OPEnSLab-OSU/SlideSentinel/Documentation/capstone/cs_capstone2018/Old/individual/main.pdf

## CS CAPSTONE TECHNOLOGY REVIEW

### DECEMBER 4, 2018

# SLIDE SENTINEL

PREPARED FOR

# OREGON STATE UNIVERSITY

### DR CHET UDELL

PREPARED BY

# GROUP 29 THE SLIDE SENTINEL

### LUCAS CAMPOS-DAVIS

Abstract

This document outlines different technology options for the Slide Sentinel project. The options presented cover micro-controllers, GPS modules, and filament materials for the housing.

CONTENTS

1 | Introduction | 2
2 | Technologies | 2
3 | Micro-controllers | 2
4 | GPS RTK Module | 3
5 | Housing Material | 4
6 | Conclusion | 4
References | 5

### 1 INTRODUCTION

My group is working on the Slide Sentinel project. This project aims to create a system for monitoring landslide-prone

areas as well as sending alerts when landslides occur. The system is built on a hub that communicates with many nodes

that report GPS data. The project also includes developing aversion of the hub that will integrate with the Open Sensing

ecosystem.

### 2 TECHNOLOGIES

The roles for our group have not yet been completely decided, so the technologies I review here may not represent what

I am responsible for come spring term. That being said, the technologies under review are Micro-controllers, GPS RTK

Modules, and Housing Materials

### 3 MICRO-CONTROLLERS

Both the ONE Hub and the Slide Sentinel Hub will be built around a micro-controller. This micro controller needs to be

able to communicate with the array of nodes and with the online client. To do this, the micro-controller will need to be

able to utilize LoRa to communicate with the nodes and LTE to communicate with the online client. The micro-controller

must also be readily available.

### 3.1 Arduino MKR NB 1500

The Arduino MKR NB 1500 is a new micro-controller from Arduino. The Arduino MKR NB 1500 is designed to provide

LTE connectivity for IoT developers. The Arduino MKR NB 1500 does not support LoRa communications by itself. If

we are to use this board, we would need an additional board to handle LoRa communications. The Arduino MKR NB

1500 is programmed in C or C++. The Arduino MKR NB 1500 also has not released yet so it is not readily available [1].

### 3.2 Pycom FiPy

The Pycom FiPy is a micro-controller with similar form factor to the Arduino MKR NB 1500. The Pycom FiPy, like the

Arduino MKR NB 1500, provides LTE communication. Unlike the Arduino MKR NB 1500, the Pycom FiPy provides four

other wireless communication networks. Not only does the Pycom FiPy provide LoRa communication, it also provides,

WiFi, Bluetooth, and Sigfox. The Pycom FiPy is programmed in a version of Python called MicroPython. The Pycom

FiPy is currently available from the Pycom website [2].

### 3.3 RAK WisLTE

The RAK WisLTE is similar to the Arduino MKR NB 1500 and the Pycom FiPy in that it is a micro-controller that

supports LTE communications. The RAK WisLTE is based on the Quectel BG96 IoT communications module. The RAK

WisLTE supports Arduino control but does not provide LoRa communication [3]. In order to utilize the RAK WisLTE we

could have to combine it with the RAK811 which is a LoRa module from RAK that is based on the Semtech SX1276[4].

All RAK boards ship through AliExpress which means that is the RAK boards are chosen, orders will need to be placed

soon.

### 3.4 Recommendation

The only board that supports LTE and LoRa communication without any additional components is the Pycom FiPy.

The fact that it meets both of the communication requirements and that it is readily available from the Pycom website

cement the Pycom FyPi as my recommendation for the micro-controller that the two Hub’s will be built around.

### 4 GPS RTK MODULE

The Slide Sentinel Hub will utilize Real Time Kinematics, or RTK. RTK relies on a base station with a fixed position

to send correction data a rover or rovers [5]. For Slide Sentinel, the hub will act as the base station and the nodes

will be the rovers. The Slide Sentinel team has already identified a GPS chip that is RTK capable. I have found two

alternative products that provide similar functionality. In order for one of the alternatives to be recommended, they

need to consume less power than the current chip. If they both consume less power, the form factor should be the

deciding trait.

### 4.1 Navspark S2525F8-GL-RTK

The Navspark S2525F8-GL-RTK is the current choice for both the base and the nodes. The Navspark S2525F8-GL-RTK

provides RTK capabilities. When RTK is not feasible, the chip can provide GNSS and DGNSS positioning. The Navspark

S2525F8-GL-RTK provides centimeter-level accuracy. The Navspark S2525F8-GL-RTK is twenty five millimeters by

twenty five millimeters. The power consumption is 230 mW [6].

### 4.2 SXBlue III+ GNSS

The SXBlue III+ GNSS is not an integratable chip or board. The SXBlue III+ GNSS is a stand alone RTK receiver. The

SXBlue III+ GNSS also offers one centimeter accuracy in RTK mode. The SXBlue III+ GNSS is designed to get its RTK

data from existing RTK stations. The SXBlue III+ GNSS also has the option to use GPS or GLONASS. The SXBlue

III+ GNSS is twenty six millimeters by sixty six millimeters. The SXBlue III+ GNSS uses its own rechargeable, field

replaceable, battery. The SXBlue III+ GNSS’s battery lasts an average of eight hours and takes four to five hours to

charge [7].

### 4.3 Trimble MB-Two

The Trimble MB-Two is an integratable module. The Trimble MB-Two can be used for RTK applications and can utilize

a local base or existing RTK networks. The Trimble MB-Two, in RTK mode, has a one centimeter-level accuracy. The

Trimble MB-Two can utilize RTK with a stationary or mobile base. The Trimble MB-Two is seventy one millimeters by

forty six millimeters by eleven millimeters. The power consumption for the Trimble MB-Two is about 1.2 W [8].

### 4.4 Recommendation

While all three options offer centimeter-level accuracy, there is one clear winner. My recommendation is to keep using

the Navspark S2525F8-GL-RTK. I recommend the Navspark S2525F8-GL-RTK over the other two alternatives because it

is the smallest of the three and has the lowest power consumption of the three.

### 5 HOUSING MATERIAL

The Slide Sentinel Hub needs to have a 3D printed housing. This housing will need to protect the hardware inside from

water and any potential impacts that the hub may sustain. Therefore the selected material needs to be water resistant.

The selected material can not be brittle. The housing material must also be able to survive in an outdoor environment.

The housing will be printed at the OPEnS Lab and therefore should be available at the lab. The OPEnS Lab has the

resources to print in resin, ABS, PLA, and Nylon 645. The resin-capable printer is significantly slower and smaller than

the other two printers which are capable of printing in the other materials [9].

### 5.1 ABS

As Anatol Locker wrote for All3DP, Acrylonitrile Butadiene Styrene, or ABS, is one of the most common plastics used

today. ABS can be found in Lego bricks, bicycle helmets, and home appliances. ABS can melt and cool without changing

its chemical properties, which makes it a good option for 3D printer filament [10]. ABS produces strong and durable

prints, ABS is often used for items that will be dropped or frequently handled such as phone cases and electrical

enclosures [11]. The one downside of ABS is that is can degrade through prolonged exposure to sunlight [10].

### 5.2 PLA

Polylactic Acid, or PLA, is a filament material that is made from biological materials like cornstarch or sugarcane.

Being made from biological materials means that prints made from PLA are biodegradable. This means that for indoor

applications, PLA will not degrade quickly, but for outdoor applications the prints will be degraded by bacteria. PLA is

also brittle and prone to shattering if it is dropped or put under stress. PLA is often used for low wear parts like painted

miniatures [12]. PLA is also used for prototype parts [11].

### 5.3 Nylon 645

The final non-resin filament type available to the OPEnS Lab is Nylon 645. Nylon is considered the number one filament

choice when it comes to strength, flexibility, and durability. Printed Nylon parts are resistant to impact and prolonged

stress. However, nylon is hygroscopic, this means that nylon will absorb water over time. This property leads to

decreased strength and durability. It also is not preferable for outdoor use [11]. According to a manufacturer of nylon

645, the only way to bond anything with nylon 645 is to either use heat to bond two pieces of nylon 645 or to use a

proprietary nylon glue [13].

### 5.4 Recommendation

All three filament types have their own drawbacks. PLA is immediately disqualified as its biodegradable and brittle

properties make it not suited for outdoor applications. Thus, the decision comes down to ABS or nylon. While nylon

is very durable and seemingly well suited to protecting the Slide Sentinel Hub from impacts, the absorption of water

from the surrounding air means that it is not suited for protecting electronics from the environment. This means that

ABS is the most well suited for the Slide Sentinel Hub enclosure. ABS will need to be painted in order to keep it from

degrading in sunlight.

### 6 CONCLUSION

My recommendations are summarized in the table below.

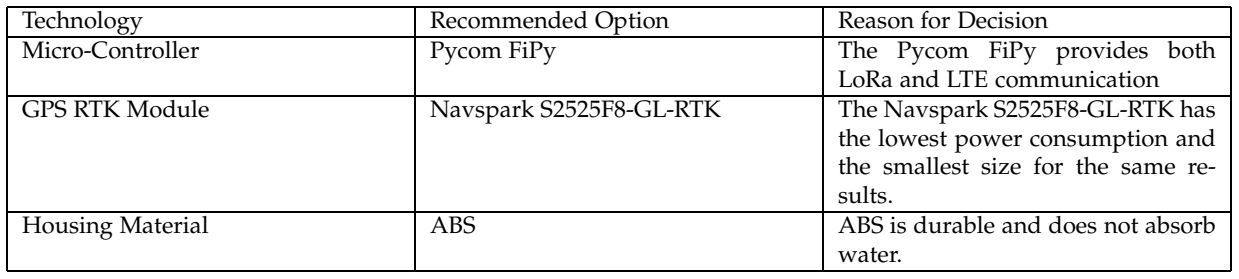
[picture p12: figure]
LoRa and LTE communication; the lowest power consumption and the smallest size for the same re- sults.; water.

Technology | Recommended Option | Reason for Decision
Micro-Controller | Pycom FiPy | The Pycom FiPy provides both
GPS RTK Module | Navspark S2525F8-GL-RTK | The Navspark S2525F8-GL-RTK has
Housing Material | ABS | ABS is durable and does not absorb

REFERENCES

[1] Arduino, “Arduino mkr nb 1500.” [Online]. Available: https://store.arduino.cc/usa/arduino-mkr-nb-1500
[2] Pycom, “Fipy.” [Online]. Available: https://pycom.io/product/fipy/
[3] R. T. Co, “Wislte.” [Online]. Available: https://www.rakwireless.com/en/WisKeyOSH/WisLTE
[4] ——, “Rak811.” [Online]. Available: https://www.rakwireless.com/en/module/lora/RAK811
[5] R. S. LLC, “Rtk (real time kinematic) basics for surveying.” [Online]. Available: http://www.resourcesupplyllc.com/PDFs/RTKBasics SurveyGradeGPS.pdf
[6] Navspark, “S2525f8glrtk.” [Online]. Available: http://navspark.mybigcommerce.com/content/S2525F8-GL-RTK v2.pdf
[7] G. | inc, | “Sxblue | iii+ | gnssk.” | [Online]. | Available: | http://www.sxbluegps.com/wp-content/uploads/2016/07/
2016-07-15-SXBlue-III-GNSS-EN web.pdf
[8] T. N. Limited, “Trimble mb-two.” [Online]. Available: http://trl.trimble.com/docushare/dsweb/Get/Document-867970/
[9] OPEnS, “Resources.” [Online]. Available: www.open-sensing.org/resources
[10] A. Locker, “The ultimate filament guide.” [Online]. Available: https://all3dp.com/abs-3d-printer-filament-explained/
[11] All3DP, “The ultimate filament guide.” [Online]. Available: https://all3dp.com/1/3d-printer-filament-types-3d-printing-3d-filament/
[12] R. Baguley, “3d printing materials: The pros and cons of each type.” [Online]. Available: https://www.tomsguide.com/us/3d-printing-materials,news-24392.html
[13] taulman3d, “645 specifications.” [Online]. Available: http://taulman3d.com/645-features.html
