OPEnSLab-OSU/SlideSentinel/Documentation/capstone/cs_capstone2018/Old/individual/techreview.pdf

## CS CAPSTONE TECHNOLOGY REVIEW

### NOVEMBER 27, 2018

# SLIDE SENTINEL

PREPARED FOR

# OREGON STATE UNIVERSITY

DR CHET UDELL

PREPARED BY

# GROUP 29 THE SLIDE SENTINEL

KEVIN KOOS

Abstract

This document outlines some technologies to be used in the Slide Sentinel and ONE hub projects. Outlined here is information on IoT cellular networks, LPWAN radio technologies, and radio transceivers. Each section overviews three possible technologies to be used along with a final recommendation.

CONTENTS

1 | Introduction | 1
2 | Technologies | 1
3 | IoT Cellular Networks | 2
4 | LPWAN Radio Technologies | 3
5 | Radio Transceivers | 3
6 | Appendix | 4
7 | References | 5
References | 5

### 1 INTRODUCTION

Our senior capstone projects goal is to develop a wireless hub to be used in the Open Sensing sensor ecosystem with the LOOM library, as well as a wireless hub for the Slide Sentinel project using satellite communication with additional constraints on the system. Both hubs will provide a way for many smaller sensors to communicate with it and allow users to remotely collect their data while providing data to the sensors such as RTK GPS corrections. The Slide Sentinel projects goal is to provide a means for users to monitor mass movements of ground in remote locations and visualize that information on an online client for easy viewing and analysis.

### 1.1 Role

While our specific roles in the project are not set in stone at the moment, my current responsibility is to work on the wireless capabilities of the hubs, add more wireless capabilities into it, and integrate existing code into the LOOM library according to previously set specifications. I will likely also be working on the Slide Sentinel hub but many specifics of its final design are still being finalized.

### 2 TECHNOLOGIES

The technologies I will be reviewing in this paper are cellular networks, radio transceivers, and LPWAN IoT wireless radio protocols. The LPWAN IoT wireless protocols are different from regular wireless protocols in that it is specific towards wireless protocols which are designed for IoT devices where efficiency and robustness are considered top priority.

### 3 IOT CELLULAR NETWORKS

One of the central and key responsibilities of the central hub is to send collected data over a cellular network to some other database. There are many different kinds of cellular networks available all with different data rates, frequency, sensitivity, and power consumption. Both hubs will utilize cellular networks. Due to one of the use cases of the hub being remote data collection, priority will be placed on networks which feature a low data rate and low power consumption such as IoT specific cellular networks. Cellular IoT networks are actually considered LPWAN networks but due to their significant difference in range, we will consider them separately from other LPWAN technologies later in the document. The three cellular network shown here give a wide view of both the time line and scope of these technologies as they came to be. All three run at a low transmit power of around 20 30 dBm and a relatively narrow band of frequencies making them optimal for IoT specific applications.

### 3.1 LTE CAT-1

LTE CAT-1, released in Q4 2008, was the first cellular network available to expressly support IoT-like devices. Although LTE CAT-1 does have a relatively large frequency band from 1.4 to 20 MHz, it makes up for it in the peak upload and download rates which are much higher than other IoT standards. Additionally, this network boasts full duplex communication unlike other IoT standards, allowing for 2-way continuous communication. As a consequence of supporting full duplex communication and high data rates, LTE CAT-1 is still an expensive solution for small IoT application with extremely low data rates. For what it is worth, LTE CAT-1 directly builds off of existing LTE modems allowing for IoT application to connect where LTE networks already exist. Usage of this network can be seen in IoT devices which may require a higher data rate than most such as those concerning video streaming.

3.2 4G LTE CAT-M1
4G LTE CAT-M1 was the first fully IoT based cellular network to be widely supported and used. It was released in the 2016 3GPP specification. Compared to LTE CAT-1, CAT-M1 is cheaper with lower data rates and a much narrower frequency band. The network also boasts a much lower latency than other networks with the capability to communication in either full or half duplex mode. CAT-M1 has a large popularity among IoT cellular networks due to its wide variety of capabilities and low data rates. CAT-M1, like its predecessor CAT-1, is able to directly build off of existing LTE networks. CAT-M1 IoT applications can be seen in devices which collect a small amounts of data periodically such as a rain meter or electrical meter.

3.3 4G CAT-NB1 (NB-IoT)
NB-IoT, short for Narrow Band, is a new IoT communication standard that works differently from previous standards. The NB-IoT standard is built from the ground up to be for IoT devices by only requiring a very narrow band of frequency and very low power usage. As a consequence, communication speeds on NB-IoT is much slower, but for basic sensing IoT applications, it is more than enough. NB-IoT was released in the 2016 3GPP specification along with CAT-M1 and has had much slower adoption due to it not using an LTE modem. NB-IoT uses DSSS modulation which is a specific modulation technique that spreads out a signal into a wider spectrum of frequencies (a ”wideband signal”) in order to decrease effects of interference on the signal.

### 3.4 Recommendations

Since both hubs are to be used in IoT application where data is very small, we want to go with a cellular network with a low data rate. Additionally, both hubs are envisioned to be used in remote areas away from any outlet so power consumption is one of our top priorities when choosing a cellular network. For the reasons stated above, going with either CAT-M1 or NB-IoT is recommended for either project. Located below is a table containing the specifications we are concerned with.

TABLE 1
Numerical qualities of cellular IoT networks
Standard: | LTE CAT-1 | 4G LTE CAT-M1 | 4G NB-IoT
Peak Download Rate: | 10 Mbit/s | 1 Mbit/s | <300 kbit/s
Peak Upload Rate: | 5 Mbit/s | 1 Mbit/s | <300 kbit/s
Transmit Power(US) | 23dBm | 20dBm | 23dBm
Duplex Mode | Full | Full or Half | Half

### 4 LPWAN RADIO TECHNOLOGIES

LPWAN, short for Low Power Wide Area Network, are network technologies which are designed to be used in low power and low data rate applications. The Slide Sentinel hub and the ONE hub will both depend on some radio technologies to talk to other sensors in the field. All three radio technologies are patented, each using slightly different techniques to improve certain aspects of the signal. For both hubs, we are looking for radio solutions which can transmit at a long range and on a low power budget. All three achieve this but in much different ways.

### 4.1 LoRa

LoRa, short for Long Range, is a patented wireless radio technology which can achieve a high sensitivity at the cost of lower data rates. These characteristics make this technology perfect for low data wireless applications such as IoT devices. LoRa was originally developed by Cycleo, but was later acquired by Semtech. LoRa is able to achieve this due to their patented chirp modulation technology. LoRa is also capable of multiplexing multiple signals together onto a single frequency allowing for multiple LoRa systems to talk to one another on the same band. This is achieved by their chirp modulation technology which encodes data through many ”chirps”. (Chirps are signals which increase or decrease in frequency over time.) This makes LoRa considered a ”spread-spectrum” radio technology. These chirps are also much easier to discern from noise in a signal making LoRa resistant to some kinds of interference.

### 4.2 SigFox

SigFox is a patented wireless radio technology, developed by its namesake, which boasts a low power, low bit-rate, long range solution all in a very narrow frequency bandwidth. SigFox uses a technique called D-BPSK which is a specific kind of phase shift keying (PSK) which encodes data in the reference wave of a signal by modulating its phase. Since the modulation technique here only affects the phase of the signal, the transmissions only need a very narrow chunk of the spectrum to transmit data unlike LoRa which requires a frequency band. As a consequence, SigFox has a very slow symbol transmission rate and needs more than a few seconds per transmission which can lead to interference between symbols in the transmission. Although slow and possibly noisy, SigFox radio technology is able to achieve low power, low data rate transmission in a remarkably small spectrum band. Due to these combinations of factors, SigFox is useful for star networks with a central base station which has a better antenna.

### 4.3 nRF

nRF are a brand of wireless solutions from Nordic Semiconductor which runs in the 2.4GHz WiFi band that specialize in being ultra low power. Due to the frequency at which WiFi runs at, multiple WiFi signals can exist in a crowded area simultaneously. Due to this and the low throughput of nRF, signals have a very low range which is way under the requirements of our project. To make up for this, a Low-Noise Amplifier (LNA) can be used to amplify the receiving signal. Of course, using an amplifier will increase the overall power needed for transmission, but with an already low power nRF solution, the combined power consumption may still make nRF a viable solution in the end.

### 4.4 Recommendations

Due to the need for both long range and low power transmissions, I would recommend the usage of LoRa in the radio solution. LoRa is a good choice for the Slide Sentinel project because of its ability to multiplex signals together and have a long range. Of course, the radio solutions depend on the implementation of the radio technology in the hardware along with the radio technology itself.

### 5 RADIO TRANSCEIVERS

The Slide Sentinel project will require a radio transceiver in the hub that has enough range and can communicate with sensors placed in the field as well have a low power consumption to last a long time. Typically these two qualities have an inverse relationship but certain radio technologies can make up for this. The need for a transceiver rather than a receiver comes from the fact that sensor nodes will get GPS RTK correction data from the central hub to achieve our goal of having a 1cm positional accuracy on sensor positions. Currently the final choice of transceiver has not yet been made yet and only a few solutions have been tried. Covered here are three solutions that fit our requirements and have not yet been considered in the hubs.

### 5.1 Analog Devices: ADF7030-1

The ADF7030-1 is a programmable radio transceiver available through Analog Devices. It is able to transmit at frequencies <1GHz and uses Gaussian PSK modulation. It is able to achieve up to 300 kbps with -121.4 dBm sensitivity at 2.4 kbps. Along with a transmitting -20dBm - +17dBm range, this transceiver is a very capable device. It comes with both IEEE802.15.4g and generic packet modes allowing for flexibility in the packet protocol. More importantly, this transceiver comes with multiple modes of interrupts in order to wake the transceiver out of sleep mode. Although this module among its modes consumes more power than the others on average, it can be programmed for just the right amount of amplification for the job at hand.

### 5.2 RFSolutions: RF-LORA-915-SO

RF-LORA-915-SO is a LoRa radio transceiver solution from RFSolutions. It uses a Semtech SX1272 Modem at its core and is capable of up 16km in range at frequencies <1GHz. Although this range is probably optimistic due to lack of obstructions, this is still an outstanding range to get nonetheless. Although this module is designed for use with LoRa, the Semtech modem is capable of other modulation techniques such as G/FSK, G/MSK, and OOK. With a high sensitivity and a high link budget, this module is capable of a very long range making it a good choice for project with small data requirements. This RF transceiver also comes with a few modes of interrupts in order to wake the transceiver up to listen mode.

### 5.3 STMicroelectronics: S2-LP

The S2-LP is a RF transceiver available from STMicroelectronics which boats having high performance at an ultra low power. It is capable of transmitting over a number of modulation techniques such as G/FSK, OOK, and ASK. Just like the other two transceivers this radio transmits in the <1GHz range. This RF transceiver has a lower power budget out of the others pulling 7mA receiving and 10mA (at +10dBm) when transmitting. Although this RF transceiver also has excellent sensitivity and link budget, it is lacking in terms of amplification when compared to the previous two transceivers. This transceiver comes with a wide range of ways to wake the transceiver from idle.

### 5.4 Recommendations

For the reasons stated above, I would recommend the RFSolutions RF-LORA-915-SO due to its long range and flexible settings. Due to the environment our radio solutions will be placed in, nothing can replace real testing when it comes to finding the best performer. Below is a table of the appropriate information of each transceiver. Range is usually not provided and can usually only be inferred from testing in the deployment location.

TABLE 2
Specifications of RF Transceivers
Transceiver | Modulation | Estimated Range | Data Rate | Sensitivity | Link Budget | Power Consumption
ADF7030-1 | G/FSK | N/A | 0.1-300 kbps | -121.2 dBm (@ 2.4kbps) | N/A | (@915MHz) 25.4mA (300kbps) RX 43mA (+13dBm) TX
RF-LORA-915-SO | LoRa(Chirp), FSK, MSK | 16Km | 0.1-300 kbps | -130 dBm | 157 dB Max | 10mA RX 28mA TX (+13dBm)
S2-LP | FSK, ASK, SigFox | N/A | 0.1-500 kbps | -130 dBm | >145 dB | 7mA RX 10 mA TX (+10 dBm)

### 6 APPENDIX

### 6.1 Abbreviations

- IoT - Internet of Things
- PSK - Phase Shift Keying
- GPSK - Gaussian PSK
- MSK - Minimum Shift Keying
- GMSK - Gaussian MSK
- FSK - Frequency Shift Keying
- ASK - Amplitude Shift Keying
- OOK - On-Off Keying
- LoRa - Long Range
- nRF - (Nordic) Radio Frequency
- GPS - Global Positioning System
- RTK - Real Time Kinematic (GPS)
- WAN - Wide Area Network
- LPWAN - Low Power WAN
- LTE - Long-Term Evolution
- NB-IoT - Narrow Band IoT
- 3GPP - 3rd Generation Partnership Project
- DSSS - Direct Sequence Spread Spectrum (modulation)
- CAT - Category

### 7 REFERENCES

[1] V. Prajzler, “Lora, lorawan and loriot.io,” https://www.loriot.io/lorawan.html, accessed: 11-5-18.
[2] Y. | Hwang, | “Cellularm | iot | explained | - | nb-iot | vs. | lte-m | vs. | 5g | and | more,” | https://www.iotforall.com/
cellular-iot-explained-nb-iot-vs-lte-m/, (https://www.iotforall.com/cellular-iot-explained-nb-iot-vs-lte-m/) accessed: 11-4-18.
[3] “Sigfox technology overview,” https://www.sigfox.com/en/sigfox-iot-technology-overview#popin-235-1, accessed: 11-6-18.
[4] Y.-P. E. Wang, X. Lin, A. Adhikary, A. Grovlen, Y. Sui, Y. Blankenship, J. Bergman, and H. S. Razaghi, “A primer on 3gpp narrowband internet of things,” IEEE Communications Magazine, vol. 55, no. 3, pp. 117–123, 2017.
[5] 3GPP, “Release specificatioins,” www.3gpp.org/release-#, accessed: 11-19-18.
[6] LinkLabs, “Sigfox vs. lora,” https://www.link-labs.com/blog/sigfox-vs-lora, accessed: 11-24-18.
[7] ——, “What is sigfox?” https://www.link-labs.com/blog/sigfox-vs-lora, accessed: 11-24-18.
[8] N. Semiconductor, “Nordic 2.4ghz rf,” https://www.nordicsemi.com/eng/Products/2.4GHz-RF, accessed: 11-25-18.
[9] A. Devices, “Adf7030-1,” https://www.analog.com/en/products/ADF7030-1.html#product-overview, accessed: 11-25-18.
[10] RFSolutions, “Rm-lora-915-so,” https://www.rfsolutions.co.uk/radio-modules-c10/fm-lora-transceiver-module-pre-set-to-915mhz-p469, accessed: 11-25-18.
[11] STMicroeletronics, | “S2-lp,” | https://www.st.com/content/st com/en/products/wireless-connectivity/sub-1ghz-rf/s2-lp.html#
design-scroll, (https://www.st.com/content/st_com/en/products/wireless-connectivity/sub-1ghz-rf/s2-lp.html) accessed: 11-26-18.
