OPEnSLab-OSU/SlideSentinel/Documentation/capstone/cs_capstone2018/Old/29_progressWINTER.pdf

## CS CAPSTONE PROGRESS REPORT

### APRIL 16, 2019

# SLIDE SENTINEL

PREPARED FOR

# OREGON STATE UNIVERSITY

DR CHET UDELL

PREPARED BY

# GROUP 29 THE SLIDE SENTINEL

JAMES STALLKAMP
LUCAS CAMPOS-DAVIS
KEVIN KOOS

Abstract

This document provides an overview of the Slide Sentinel capstone teams work over the past term. This includes an overview of what problems we have encountered and how they have/will be solved. Images included show off alpha level functionality.

CONTENTS

1 | Purpose | 2
2 | Goals | 2
3 | What is Next | 2
4 | Problems and Solutions | 2
5 | Interface Design and Feedback | 3
6 | Images | 4

### 1 PURPOSE

The purpose of the Slide Sentinel project is to provide users a cost effective way to monitor remote areas that are at risk

of landslides. Slide Sentinel will accomplish this with an array of sensors devices that communicate telemetry data to

a central hub. Slide Sentinel will automatically upload the data that it collects to a remote repository. In addition to the

hub system there exists a online client that allows users to access and visualize the data that Slide Sentinel collects. The

data that Slide Sentinel collects will hopefully help to prevent or mediate future damages from landslides.

The senior capstone team will also be working on the ONE Hub, a generalized version of the Slide Sentinel hub designed

for the LOOM sensor ecosystem. LOOM is a much larger sensor ecosystem that encapsulates many devices, eventually

slide sentinel will be fully integrated into LOOM. This means the hub will be able to communicate with other LOOM

sensors over nRF, LoRa, or WiFi. Data collected by the ONE hub will be sent to a remote repository of the user’s

choosing.

### 2 GOALS

The senior capstone team for Slide Sentinel is focused on implementing software for the online client and to handle

routing communication between the hub and nodes. Another major goal included for all aspects of the project is to

eventually integrate the entire system into the LOOM ecosystem. Additionally the Slide Sentinel may have other small

software issues related to being integrated with LOOM that the capstone team may work on.

### 3 WHAT IS NEXT

There are several tasks remaining to be completed. The script used to populate a spreadsheet used for data store is still

being finalized. The online client needs some kind of functionality added to allow users to directly access data. Also the

online client has some aesthetic and general formatting work that needs to be done before presenting. Last the client

would like the entire slide sentinel system to be integrated into the greater LOOM system that the opens lab uses.

### 4 PROBLEMS AND SOLUTIONS

### 4.1 Cellular

During the beginning of the project, it was made clear that we would be using a cellular network along with satellite

communication as a low cost solution to uploading data. Work initially began using a Pycom Gpy since it could

communicate with cellular networks out of the box. However, this proved to be a great challenge due to Pycom devices

only recently getting software to properly communicate over our specific cellular network. For this reason, and that

the target device we will be using has changed to the Adafruit feather M0, the decision was made to use an Adafruit

breakout board called a FONA, which simplifies the process to communicate over a cellular network.

### 4.2 Rockblock+

The Rockblock+ proved to be a challenge for us for a while due to circumstances outside of our control. In order to use

any Rockblock product, credits need to be bought to upload strings as well as a line rentals to activate the Rockblock

to be able to communicate to the satellites. Due to complications with how these charges were going to be funded, we

needed to wait until we have the necessary approval to move forward with testing the Rockblock. This approval took around a weeks time to go through due to having to use a wire transfer to transfer funds. Additionally, when it came

time to work on the Rockblock+, we had not gotten the line rental yet. Fortunately, approval for the line rental came

through quickly this time.

Unique to the Rockblock+ compared to the normal Rockblock, it uses a RS-232 interface to interface with the microcon-

troller. A custom printed circuit board was created by Kamron of OPEnS for interfacing a Adafruit feather M0 with both

the Rockblock and Rockblock+. Before the custom PCB was finished and tested, he helped us with making a breadboard

version of the PCB so we could begin testing early.

### 4.3 LOOM Pushingbox Depreciation and Rock7

With LOOM 2 coming in the near future and new additions being made to the whole LOOM project, previous features

are being reevaluated if they should be included in LOOM. Pushingbox, due to security and limitations is being

depreciated from LOOM in the near future. Since our project is supposed to integrate into LOOM later in the projects

lifespan, we want to align with the direction LOOM is taking and want to remove the need for Pushingbox in our

project. While this is simple for directly uploading to Google sheets from the microcontroller, uploading from iridium’s

Rock7 servers is not. The Iridium Rock7 server requires that the server it sends a POST request to responds with a 200

HTML only and nothing else. If it doesn’t get a 200 response code back, the server will automatically put the message

into a re-delivery queue where the message will be resent again after a certain amount of time. When a HTML request

is sent to a Google URL, a one-time use URL is generated for the request and redirected there for security reasons. This

redirect responds with an HTML response code of 302, not the 200 which Rock7 requires. Additionally, the request will

go through on Google’s side and work, but since Rock7 server think the message did not deliver, the message is sent

repeatedly. Due to these reasons, an intermediary is needed for these two servers to talk to one another correctly. A

small NodeJS app was created and hosted on Microsoft Azure Cloud Services to act as this intermediary. This program

essentially acts in just the same way as Pushingbox and allows for the redirection of the endpoints remotely.

### 5 INTERFACE DESIGN AND FEEDBACK

### 5.1 Spreadsheet

The spreadsheet used for displaying the raw data is hosted on Google sheets and displays the necessary information to

the users. As of the latest version of the spreadsheet, the columns are separated into all the fields that the hubs send out.

Everything is displayed to the user and any abbreviations are expanded into their real meaning by the spreadsheet to

reduce the number of bytes sent by the hub. Aesthetically, the spreadsheet looks like a normal spreadsheet but sports a

green background. Below is a picture of the spreadsheet.

### 5.2 Map Client

The Map client has been created as a web page and has most of its basic functionality implemented. The Map client is

deployed as a node js application and currently is hosted on a personal machine. This map client can load a specific sheet

selected by the user from a pre-defined Google spreadsheet. The map client searches the retrieved data for longitude

and latitude in the column names and visualizes the corresponding points onto Google maps. The Google API proved

to be rather difficult to work with as the API itself is very particular. Security and app permissions proved to be difficult

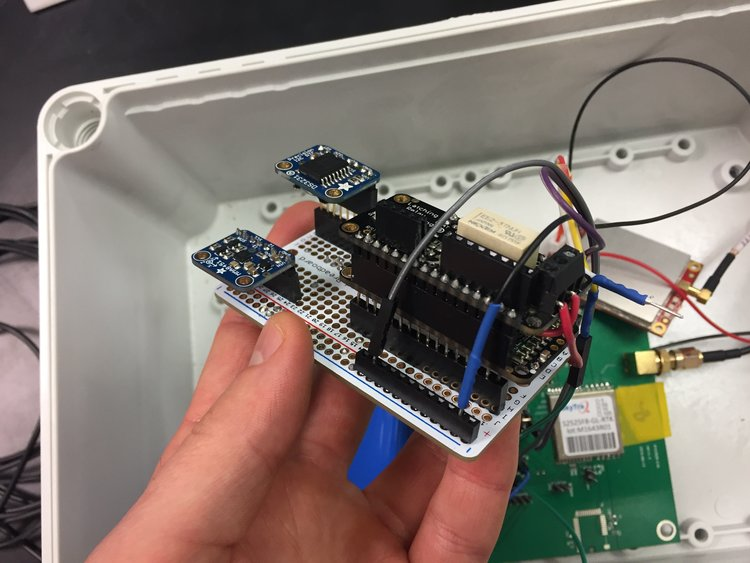
[picture p13: figure]

Fig. 1. OPEnS open house revision of the hub

as we had to work through Google’s credential system and we had no prior experience. The web client still needs to be

polished aesthetically and the client may want additional functionality added. These future additions should be small

and can be implemented quickly.

### 6 IMAGES

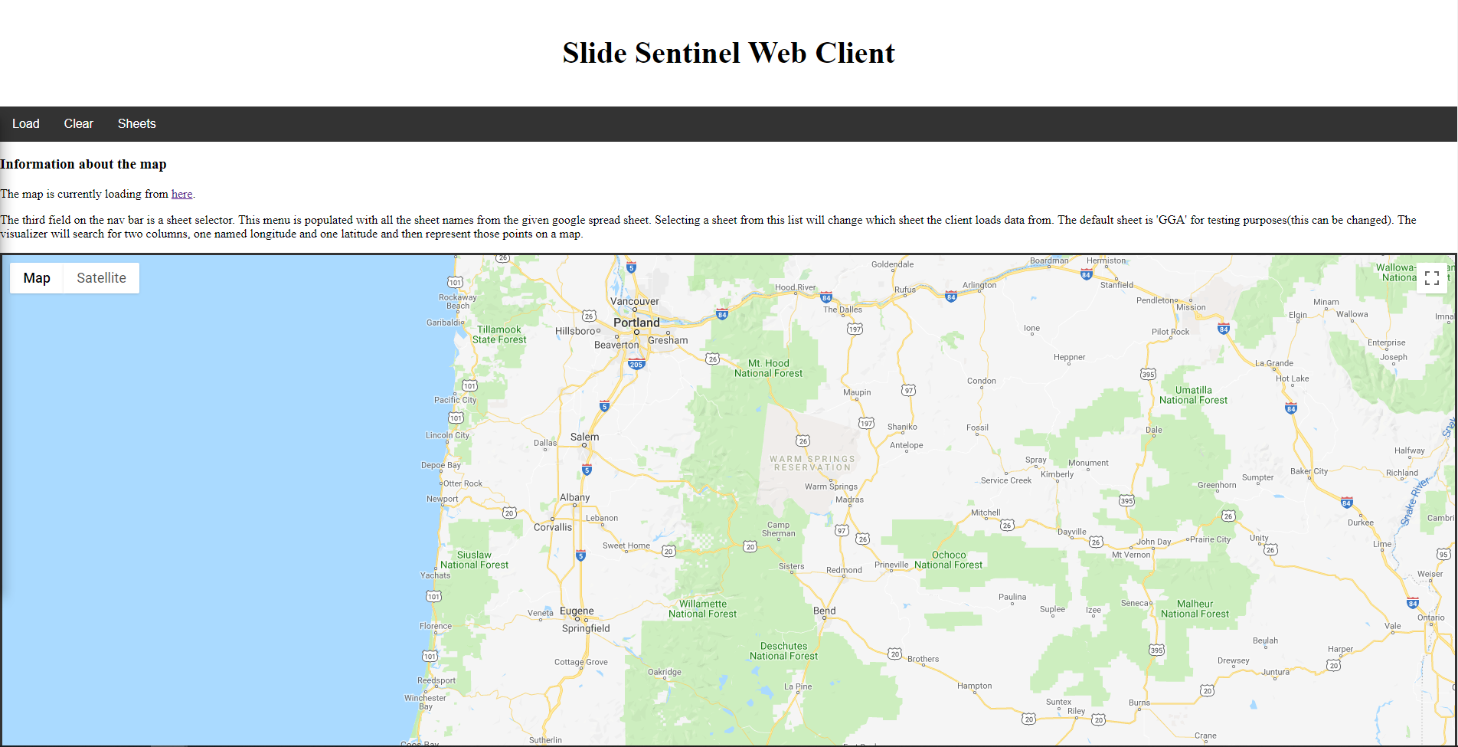
[picture p14: figure]

Fig. 2. WIP Version of the map client

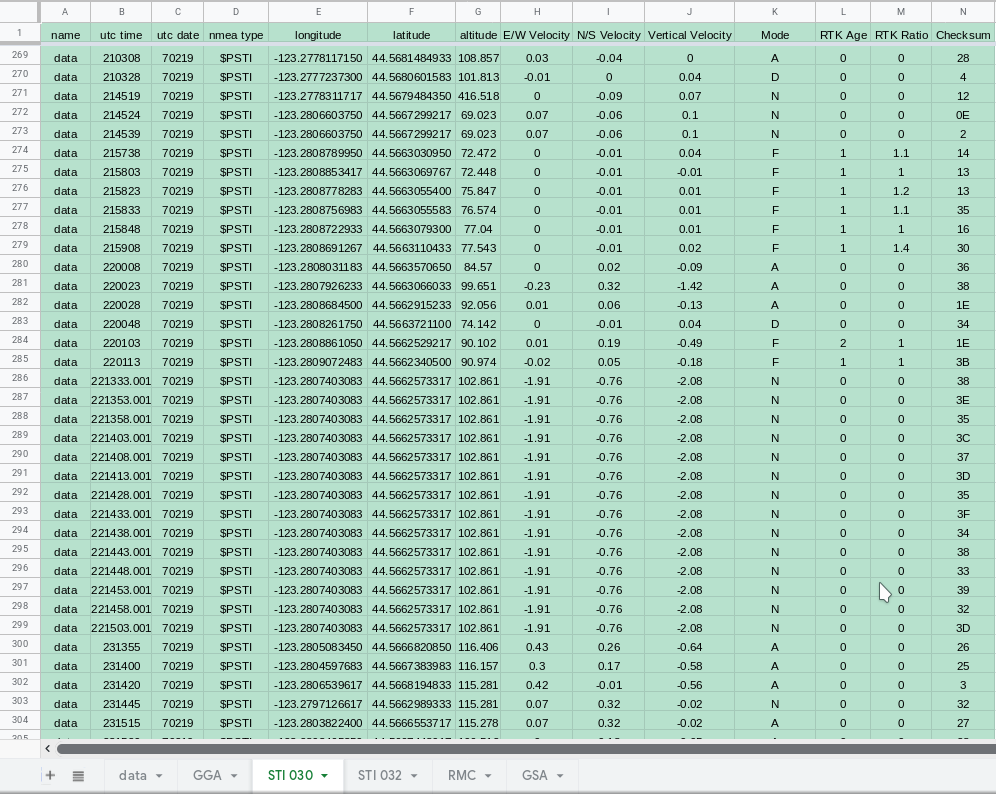
[picture p15: figure]

Fig. 3. OPEnS Open house demonstration spreadsheet

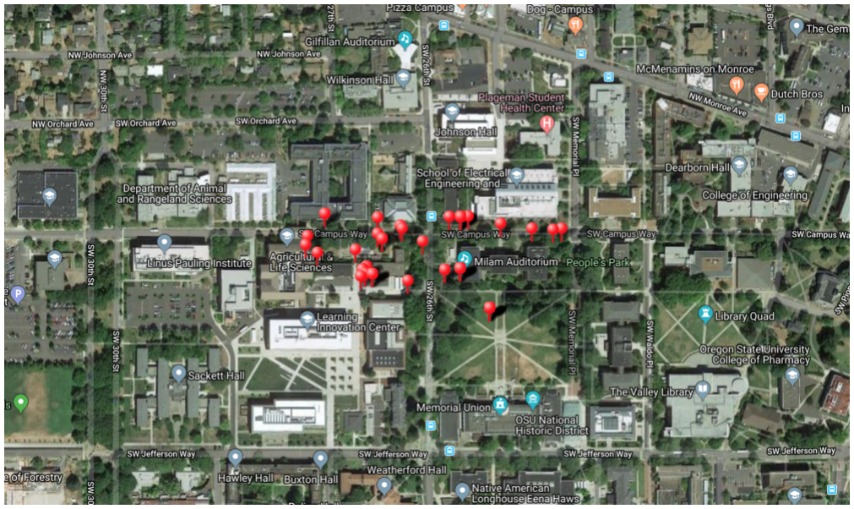
[picture p16: figure]

Fig. 4. Early version of the map client using GPSVisualizer. Used for OPEnS open house demonstration
