OPEnSLab-OSU/SlideSentinel/Documentation/Photos/Diagrams/GNSSfrequency.png

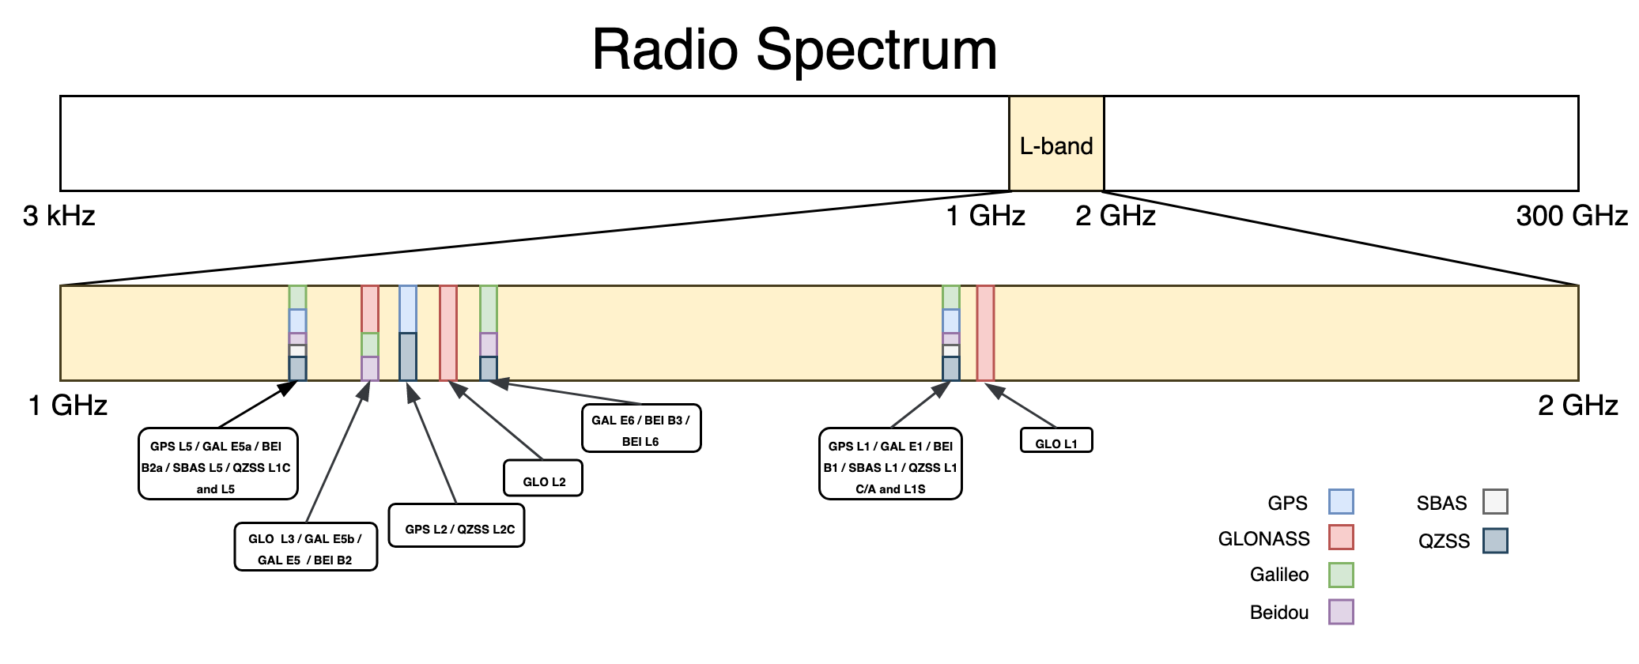
Documentation/Photos/Diagrams/GNSSfrequency.png
