OPEnSLab-OSU/SlideSentinel/Documentation/Photos/Diagrams/MAXdiagram.png

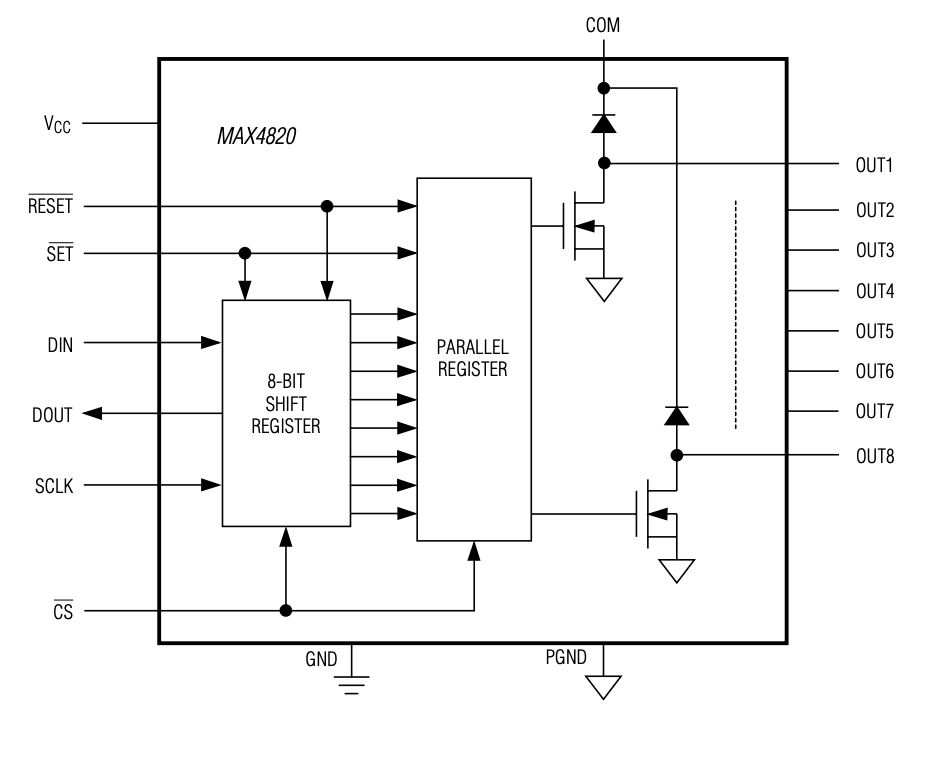
Documentation/Photos/Diagrams/MAXdiagram.png
