OPEnSLab-OSU/SlideSentinel/Documentation/Photos/Diagrams/NewDiagram.png

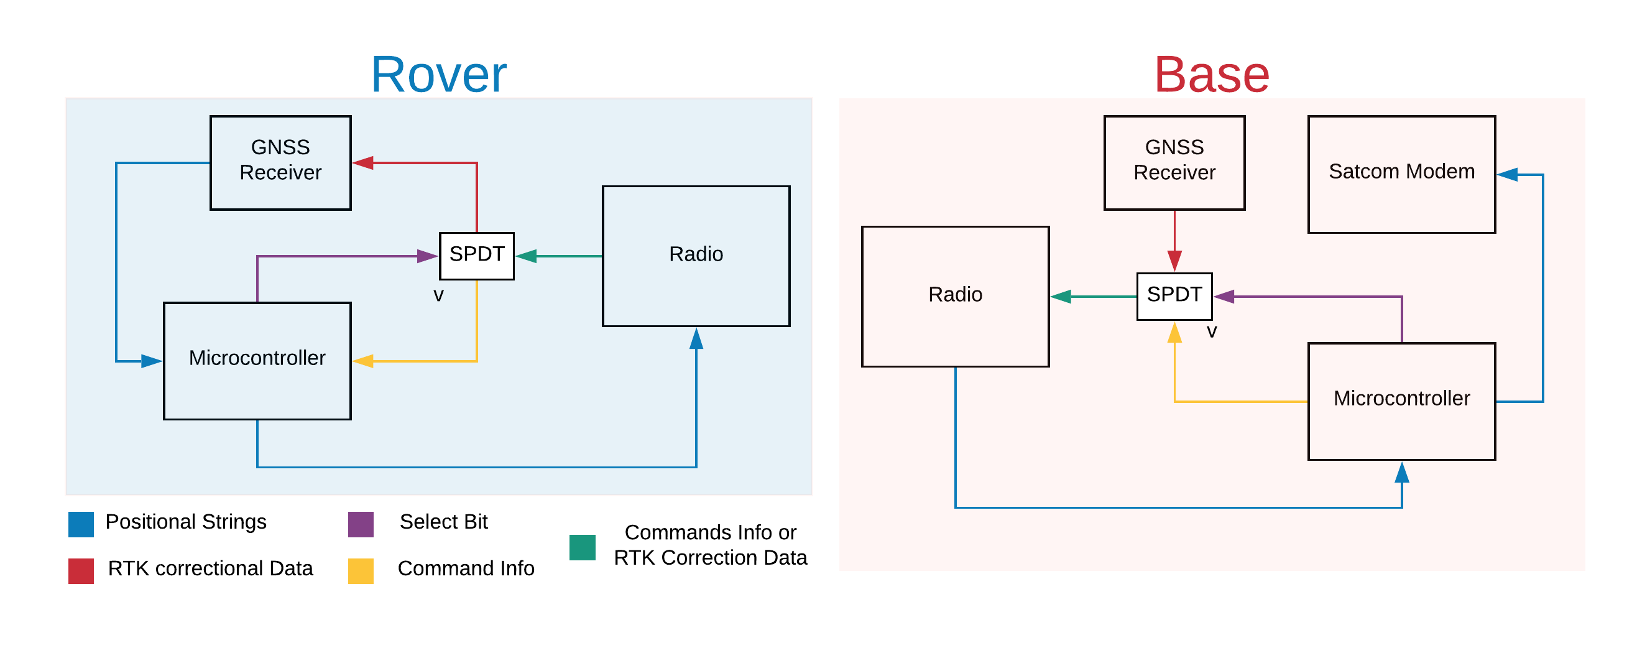
Documentation/Photos/Diagrams/NewDiagram.png
