OPEnSLab-OSU/SlideSentinel/Documentation/Photos/Diagrams/routingRS232.png

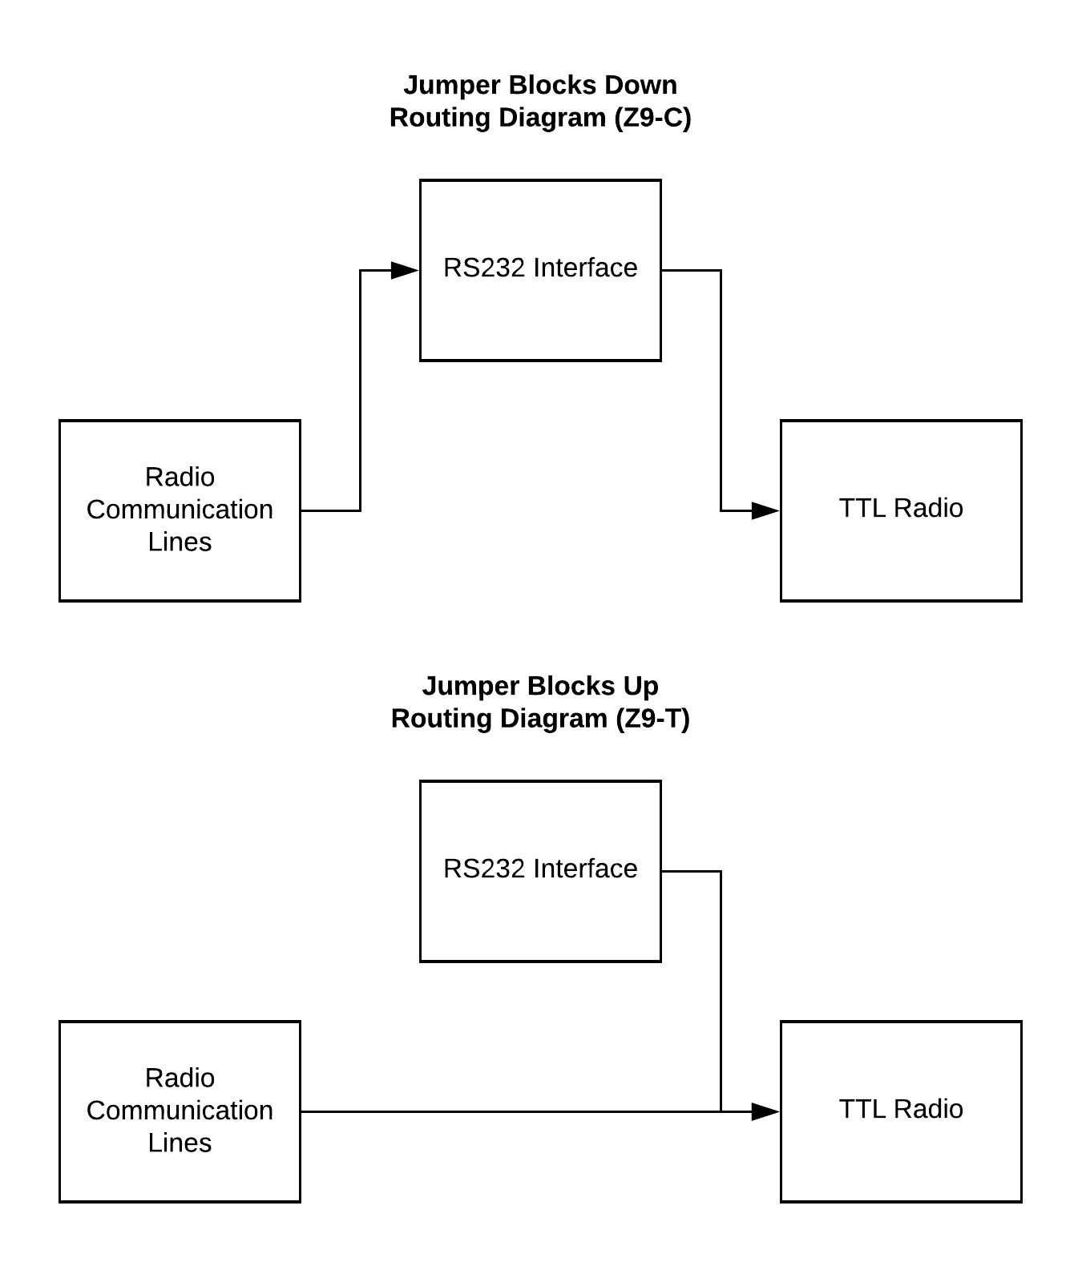
Documentation/Photos/Diagrams/routingRS232.png
