OPEnSLab-OSU/SlideSentinel/Documentation/Photos/Hardware/Base.jpg

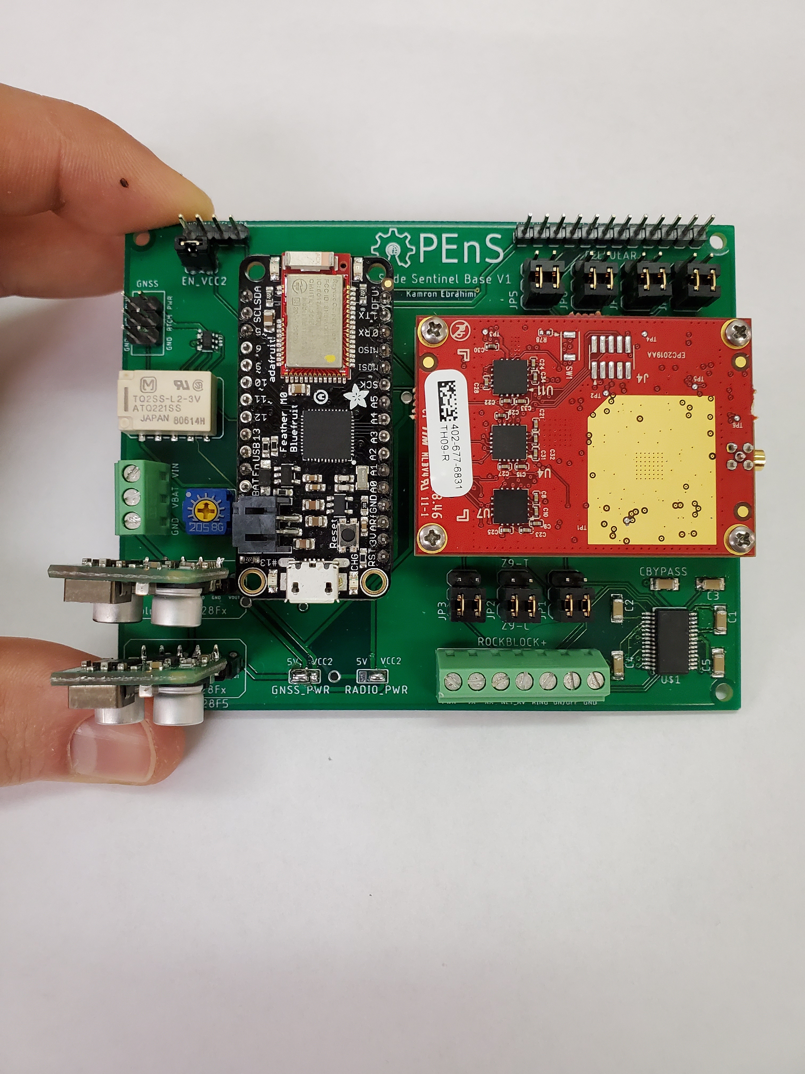
Documentation/Photos/Hardware/Base.jpg
