OPEnSLab-OSU/SlideSentinel/Documentation/Photos/Hardware/baseBlocks.png

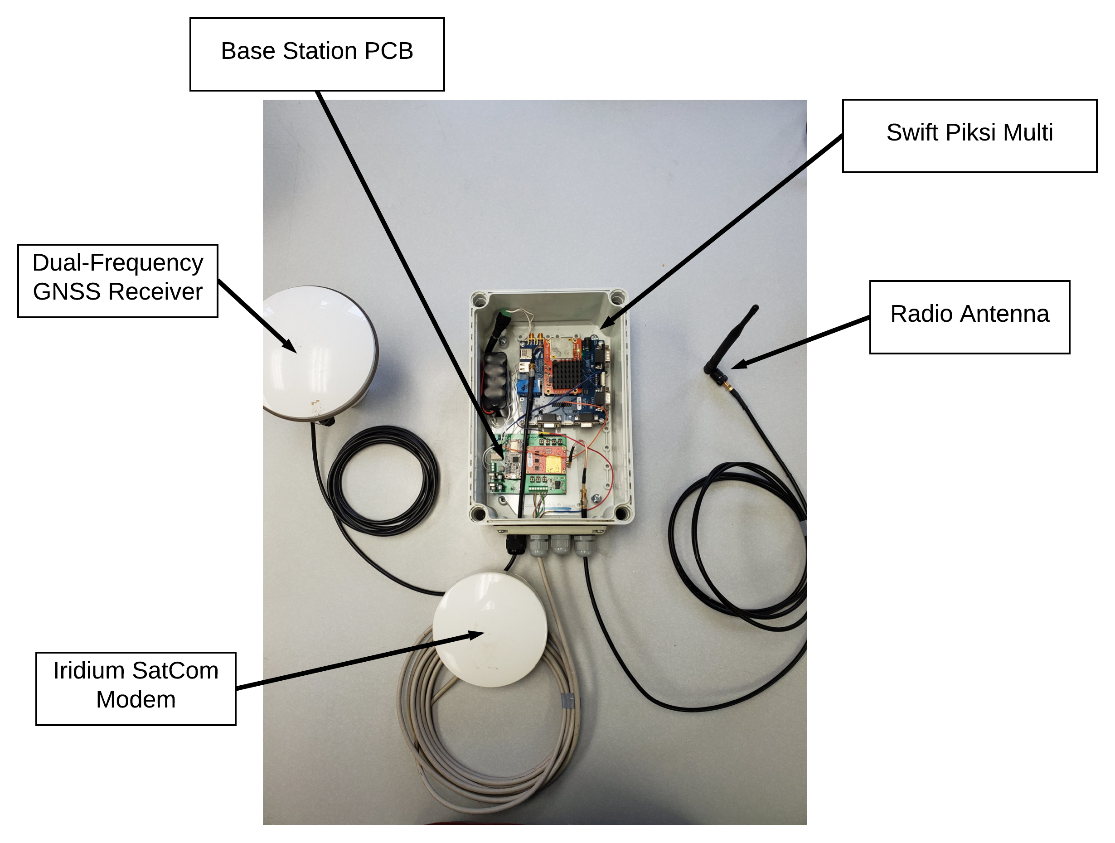
Documentation/Photos/Hardware/baseBlocks.png
