OPEnSLab-OSU/SlideSentinel/Documentation/Photos/Hardware/BaseBlog.png

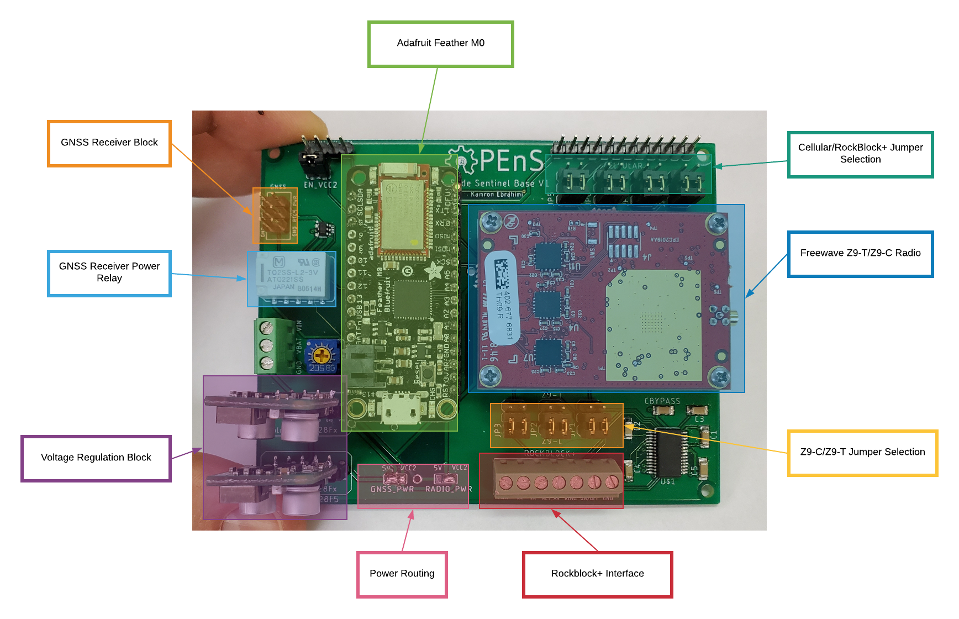
Documentation/Photos/Hardware/BaseBlog.png
