OPEnSLab-OSU/SlideSentinel/Documentation/Photos/Hardware/baseEmpty.jpg

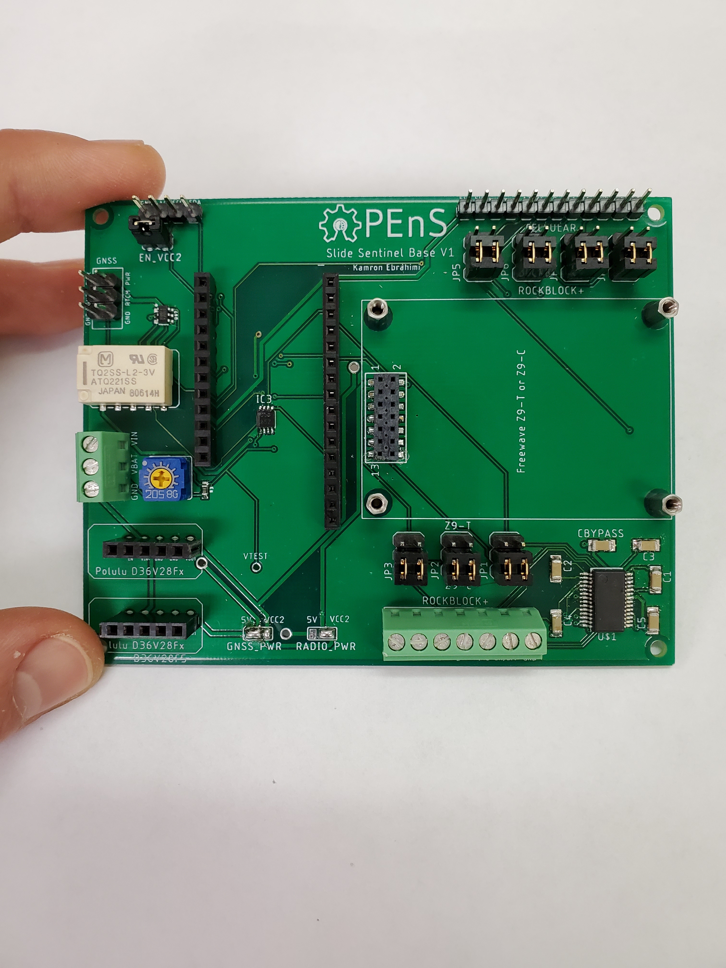
Documentation/Photos/Hardware/baseEmpty.jpg
