OPEnSLab-OSU/SlideSentinel/Documentation/Photos/Hardware/basePCB.png

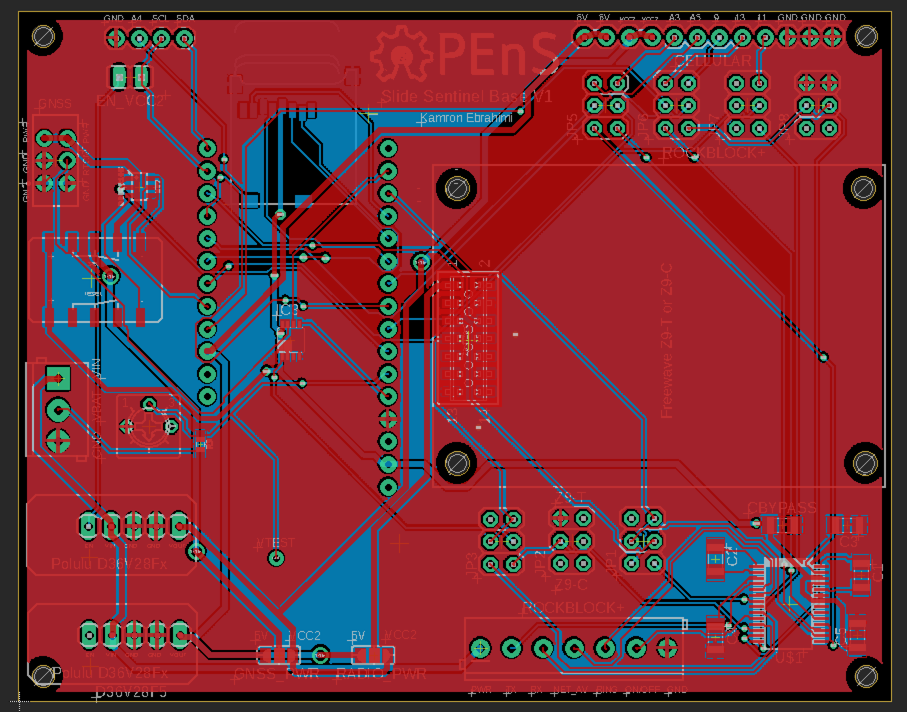
Documentation/Photos/Hardware/basePCB.png
