OPEnSLab-OSU/SlideSentinel/Documentation/Photos/Hardware/FreewaveCADModel.png

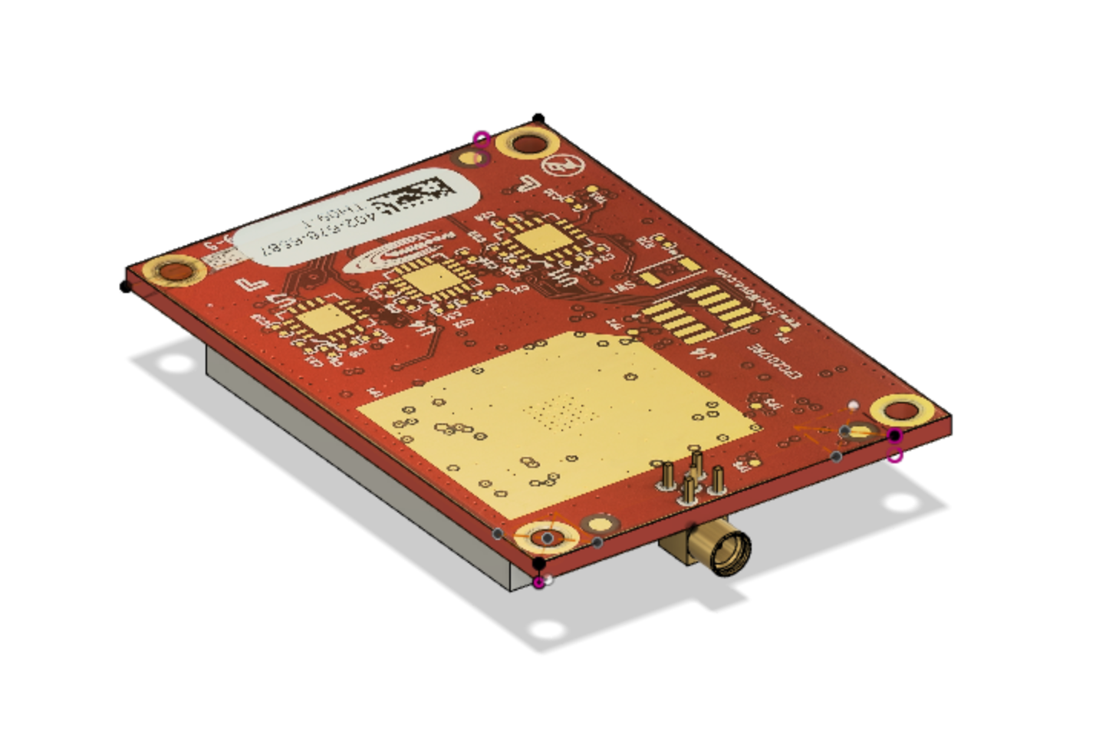
Documentation/Photos/Hardware/FreewaveCADModel.png
