OPEnSLab-OSU/SlideSentinel/Documentation/Photos/Hardware/fusionPCB.png

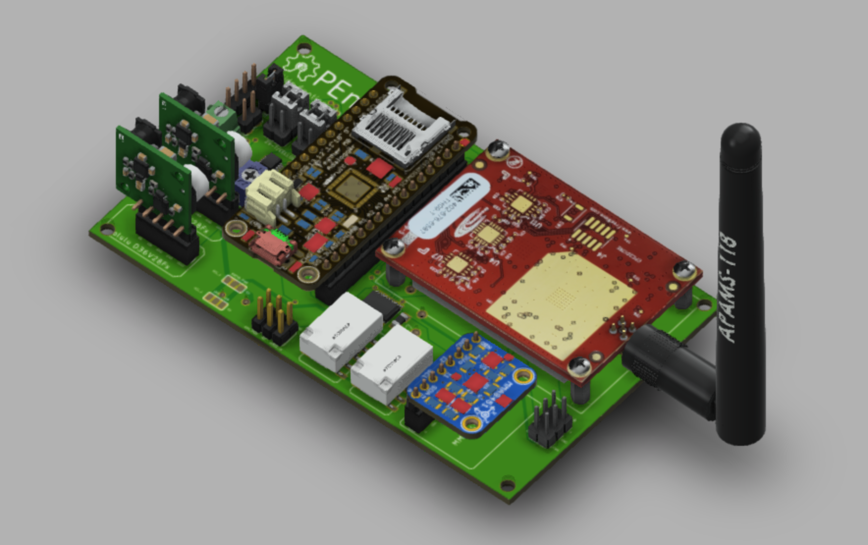
Documentation/Photos/Hardware/fusionPCB.png
