OPEnSLab-OSU/SlideSentinel/Documentation/Photos/Hardware/MAX4280.png

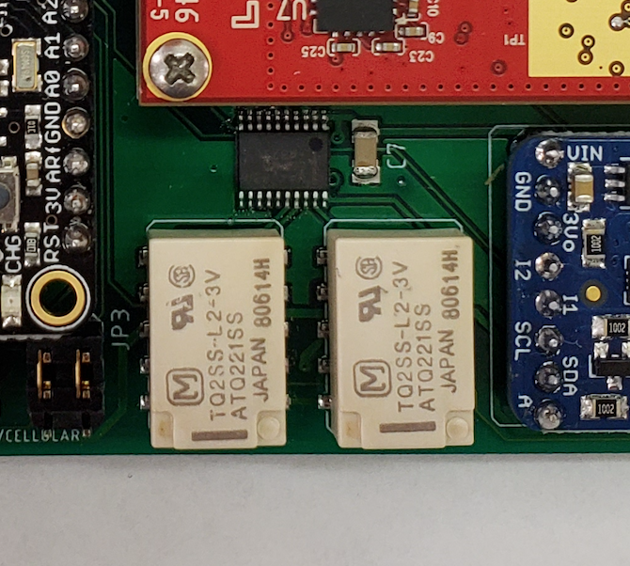
Documentation/Photos/Hardware/MAX4280.png
