OPEnSLab-OSU/SlideSentinel/Documentation/Photos/Hardware/MaxPCB.png

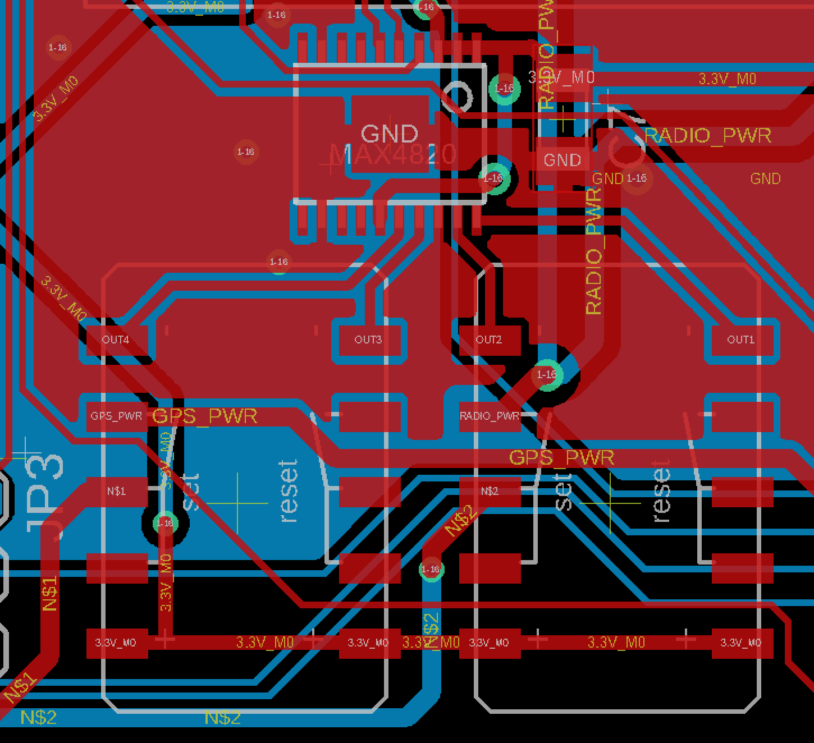
Documentation/Photos/Hardware/MaxPCB.png
