OPEnSLab-OSU/SlideSentinel/Documentation/Photos/Hardware/piksiMulti.jpg

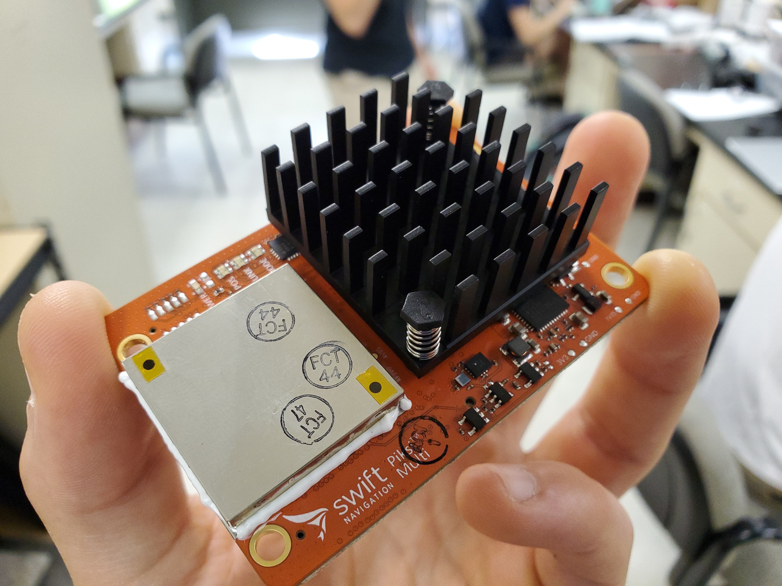
Documentation/Photos/Hardware/piksiMulti.jpg
