OPEnSLab-OSU/SlideSentinel/Documentation/Photos/Hardware/rockblock.jpg

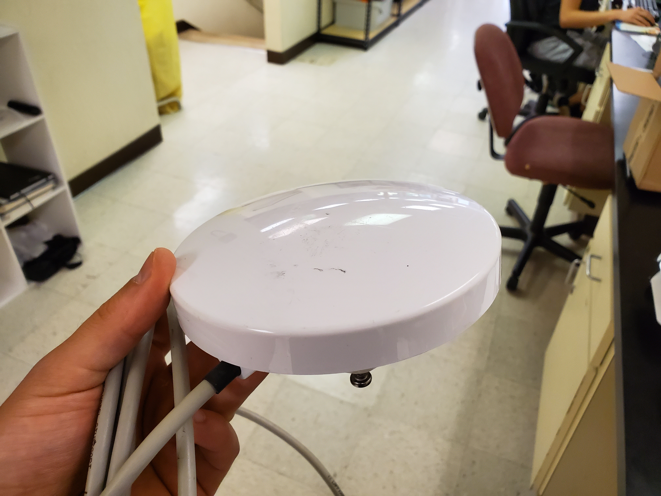
Documentation/Photos/Hardware/rockblock.jpg
