OPEnSLab-OSU/SlideSentinel/Documentation/Photos/Hardware/rover.jpg

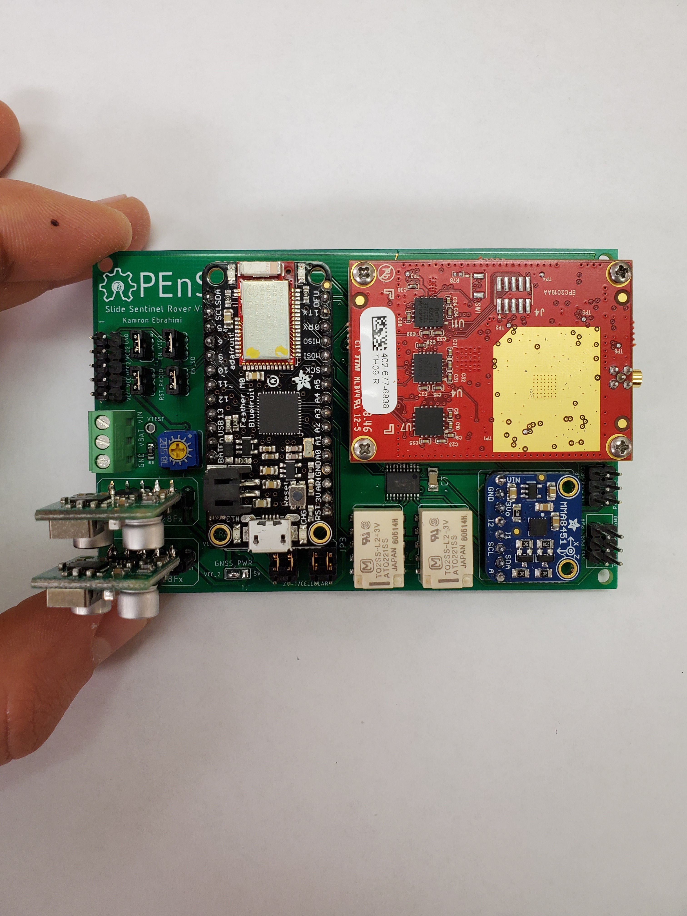
Documentation/Photos/Hardware/rover.jpg
