OPEnSLab-OSU/SlideSentinel/Documentation/Photos/Hardware/RoverBlog.png

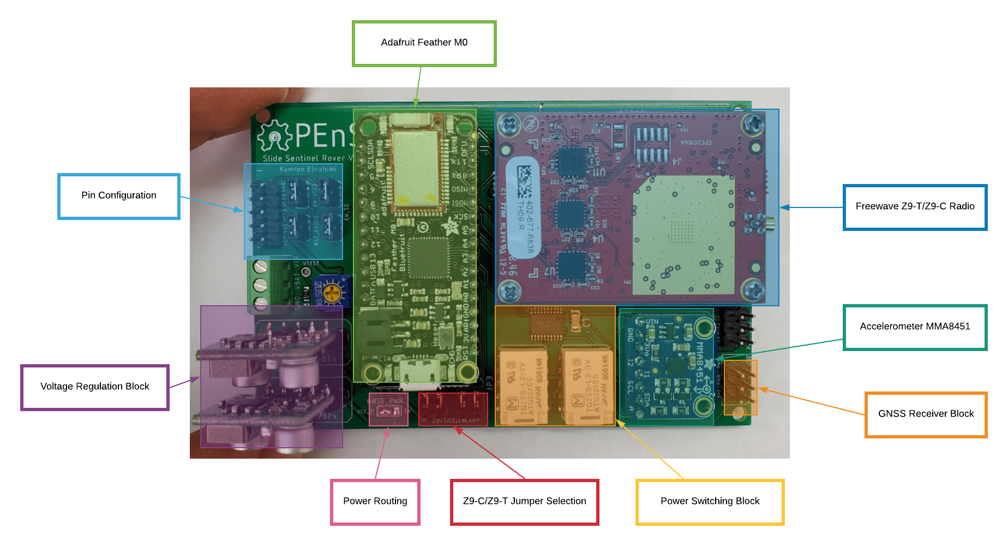
Documentation/Photos/Hardware/RoverBlog.png
