OPEnSLab-OSU/SlideSentinel/Documentation/Photos/Hardware/RoverBlogEmpty.png

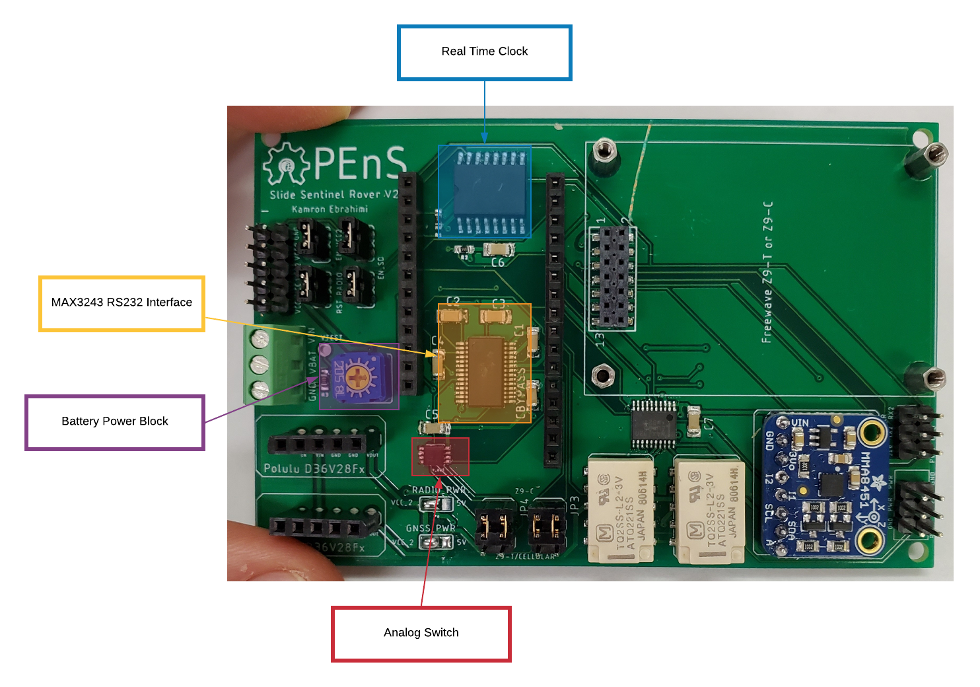
Documentation/Photos/Hardware/RoverBlogEmpty.png
