OPEnSLab-OSU/SlideSentinel/Documentation/Photos/Hardware/roverEmpty.jpg

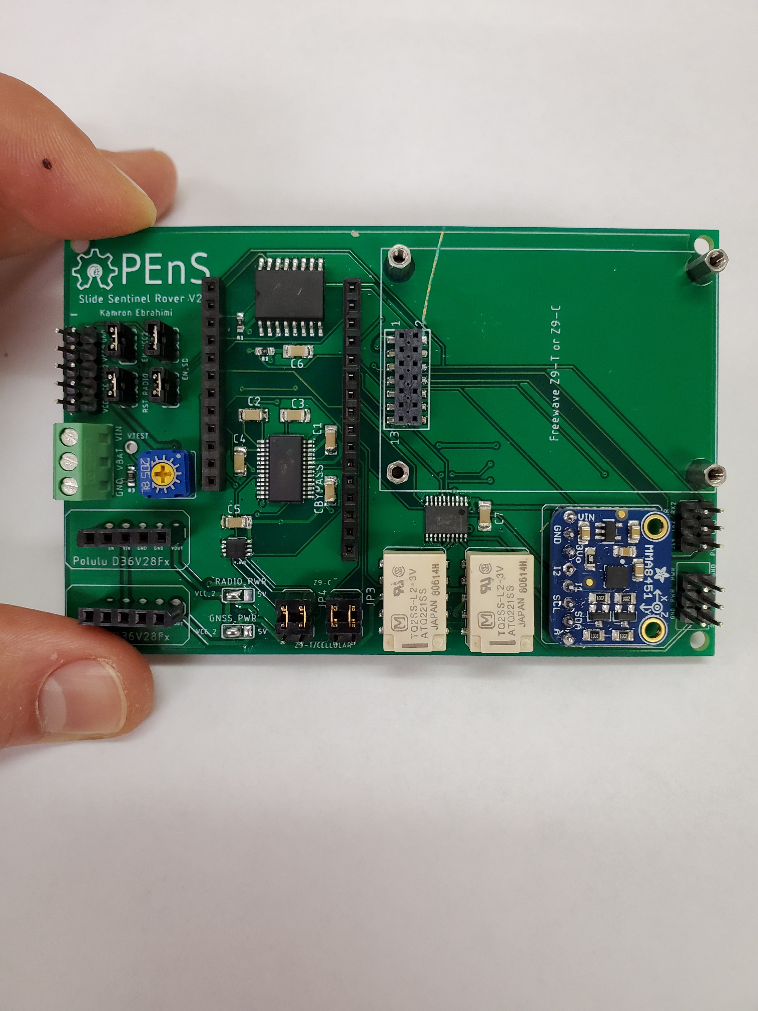
Documentation/Photos/Hardware/roverEmpty.jpg
