OPEnSLab-OSU/SlideSentinel/Documentation/Photos/Hardware/skytraq.jpg

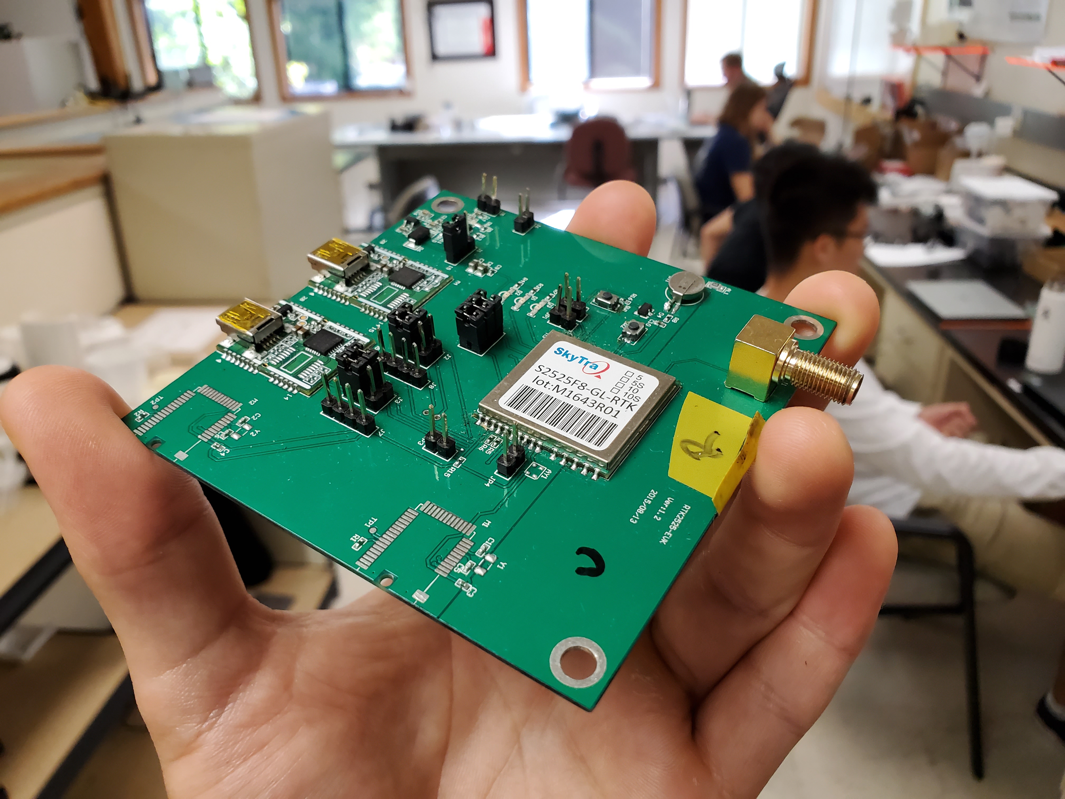
Documentation/Photos/Hardware/skytraq.jpg
