OPEnSLab-OSU/SlideSentinel/Documentation/Photos/Hardware/zed.jpg

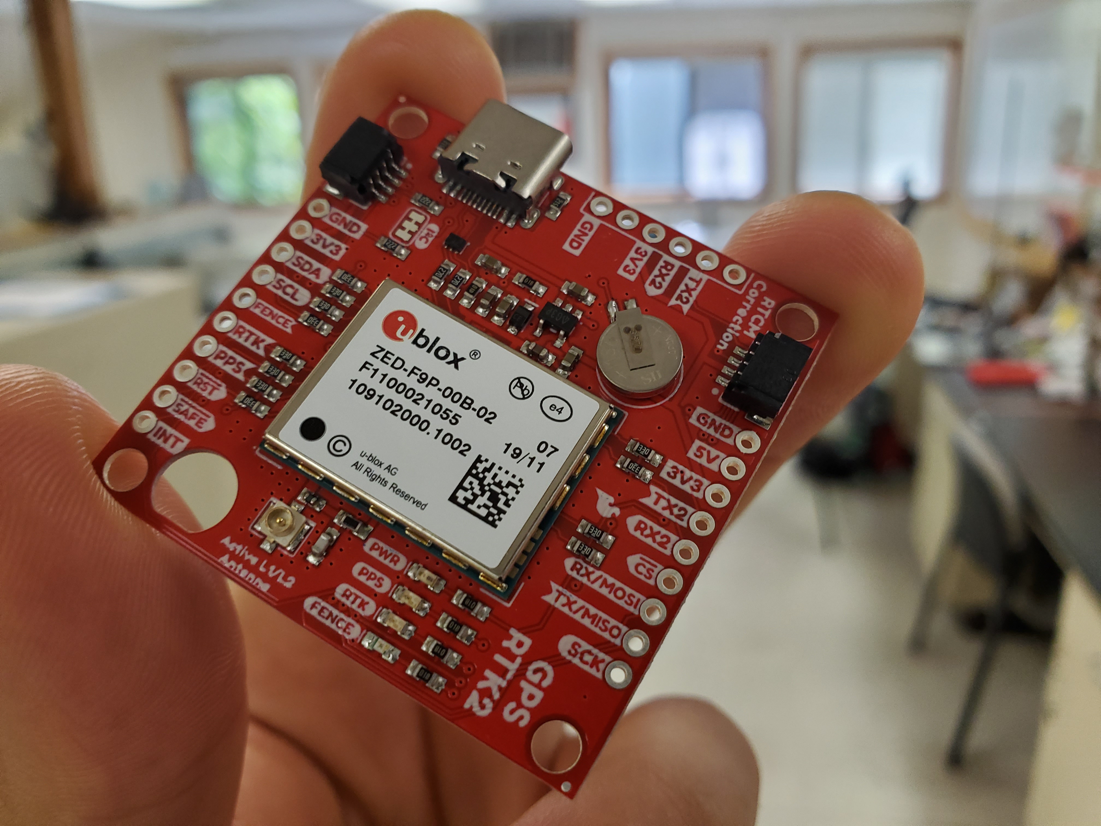
Documentation/Photos/Hardware/zed.jpg
