OPEnSLab-OSU/SlideSentinel/Integration/Hardware/rover/bom.pdf

Item | Name On PCB | Value | Package Size | Manufacturer part Number DigiKey part number | Quantity per PCB | Cost per 1 pcs | Cost for Required quantity | Product/site info | Future Design Considerations ANALOG SWITCH
SN74LVC2G53 | IC3 C5 | 1 uF | SM8 1206 | SN74LVC2G53DCT CC1206KRX7R9BB104 | 296-13269-2-ND 311-1179-1-ND | 1 1 | $0.67 $0.19 | $0.67 $0.19 | https://www.digikey.com/product-detail/en/texas-instruments/SN74LVC2G53DCTR/296-13269-1-ND/484508 Bypass Capacitor 1 uF (1206) https://www.digikey.com/product-detail/en/yageo/CC1206KRX7R9BB104/311-1179-1-ND/303089 RADIO
SAMTEC TLE 14 POS | Freewave Z9-C Freewave Z9-C | | TLE | TLE-107-01-G-DV-A Z9-C | SAM10182-ND 2108-Z9-C-ND | 1 1 | $2.83 $490.44 | $2.83 $490.44 | https://www.digikey.com/product-detail/en/samtec-inc/TLE-107-01-G-DV-A/SAM10182-ND/6678919 FREEWAVE Z9-C or Z9-T https://www.digikey.com/products/en?keywords=freewave%20Z9-C

CONNECTIVE HARDWARE

Female-Female 1/4", 2-56 standoffs | For connecting the Freewave Radio | | | | | 4 | $1.87 | $7.48 | https://www.mcmaster.com/91115A806
2-56 Thread, 3/16" Long Bolt | For connecting the Freewave Radio | (Packs of 100 @ $5.40) | 12 | $5.40 | $5.40 | https://www.mcmaster.com/91802A076 Female-Male 1/4", 2-56 standoffs | For connecting the entire board | 4 | $2.15 | $8.60 | https://www.mcmaster.com/91075A211 CONNECTORS/ANTENNA
900 MHz RF antenna | | SMA MMCX | A09-HASM-675 CBA-SMA-MMCXRA | A09-HASM-675-ND CBA-SMA-MMCXRA-ND | 1 1 | $25.00 $5.81 | $25.00 $5.81 | https://www.digikey.com/product-detail/en/digi-international/A09-HASM-675/A09-HASM-675-ND/615818 MMCX to SMA connector https://www.digikey.com/product-detail/en/rf-solutions/CBA-SMA-MMCXRA/CBA-SMA-MMCXRA-ND/2781759

JUMPERS

2x3 2.54 mm header block | Z9-C Radio/Z9-TRadio | 2.54 mm | M20-9980345 | 952-2120-ND | 3 | $0.27 | $0.81 | https://www.digikey.com/product-detail/en/harwin-inc/M20-9980345/952-2120-ND/3728084
2x2 2.54 mm Shunt Jumper | Z9-C Radio/Z9-TRadio | 2.54 mm | MNT-102-BK-G | SAM9042-ND | 2 | $0.76 | $1.52 | https://www.digikey.com/product-detail/en/samtec-inc/MNT-102-BK-G/SAM9042-ND/2685308
2x1 2.54 mm Shunt Jumper | RST_RADIO/EN_VCC2 | 2.54 mm | QPC02SXGN-RC | S9337-ND | 2 | $0.10 | $0.20 | https://www.digikey.com/product-detail/en/sullins-connector-solutions/QPC02SXGN-RC/S9337-ND/2618262 RS232 INTERFACE TO RADIO MAX3243 | MAX3243 | SSOP-28 | MAX3243CDBR | 296-6941-1-ND | 1 | $1.91 | $1.91 | https://www.digikey.com/product-detail/en/texas-instruments/MAX3243CDBR/296-6941-1-ND/371563
0.1 uF SMD capacitor (1206) | C1, C2, C3, C4, CBYPASS | 1 uF | 1206 | CC1206KRX7R9BB104 | 311-1179-1-ND | 5 | $0.19 | $0.95 | https://www.digikey.com/product-detail/en/yageo/CC1206KRX7R9BB104/311-1179-1-ND/303089 ACCELEROMETER
Adafruit MMA8451 | Adafruit MMA8451 | | | | | 1 | $7.95 | $7.95 | https://www.adafruit.com/product/2019 POWER GRID
Polulu 5V step down | (Recommend D36V28F3) D36V28F5 | | | N/A D36V28F5 | | 1 1 | $11.95 $11.95 | $11.95 $11.95 | https://www.pololu.com/product/3782 Polulu 3V step down https://www.pololu.com/product/3782
3.5 mm 3-position screw terminal | | | 3.5 mm pitch length | 1751251 | 277-5749-ND | 1 | $1.95 | $1.95 | https://www.digikey.com/product-detail/en/phoenix-contact/1751251/277-5749-ND/2511152 VOLTAGE DIVIDER
VBAT Resistor (0603) 1MOhm | R12 | 1 M Ohms | \0603 | CPF0603B1M0E | A119955DKR-ND | 1 | $0.52 | $0.52 | https://www.digikey.com/product-detail/en/te-connectivity-passive-product/CPF0603B1M0E/A119955DKR-ND/4966666 Trim pot CT6 2MOhms | 2 M Ohms | CT6 | CT6EP205 | CT6EP205-ND | 1 | $0.79 | $0.79 | https://www.digikey.com/product-detail/en/nidec-copal-electronics/CT6EP205/CT6EP205-ND/738311 Microcontroller Adafruit Feather Addalogger | 1 | $19.95 | $19.95 | https://www.adafruit.com/product/2796 RTC
DS3231 | C6 | 1 uF | 16-SOIC 1206 | DS3231S#T&R CC1206KRX7R9BB104 | DS3231S#T&RCT-ND 311-1179-1-ND | 1 1 | $7.87 $0.19 | $7.87 $0.19 | https://www.digikey.com/product-detail/en/maxim-integrated/DS3231S-T-R/DS3231S-T-RCT-ND/4895454 Bypass Capacitor 1 uF https://www.digikey.com/product-detail/en/yageo/CC1206KRX7R9BB104/311-1179-1-ND/303089
10K Resistor 0805 | R9,R6 | 10K | \0603 | RNCP0805FTD10K0 | RNCP0805FTD10K0CT-ND | 2 | $0.10 | $0.20 | https://www.digikey.com/product-detail/en/te-connectivity-passive-product/CPF0603B1M0E/A119955DKR-ND/4966666 SD
SD connector | SD CARD MICO CONNECTOR | 1 | $1.95 | $1.95 | https://www.adafruit.com/product/1660 Relay MAX4280 | TSSOP | MAX4820EUP+T | MAX4820EUP+CT-ND | 1 | $3.93 | $3.93 | https://www.digikey.com/product-detail/en/maxim-integrated/MAX4820EUP-T/MAX4820EUP-CT-ND/5405793
2A Latching Relay | relays 1 and 2 C5 | 1 uF | 1206 | TQ2SS-L2-3V-Z CC1206KRX7R9BB104 | 255-3845-1-ND 311-1179-1-ND | 2 1 | $5.07 $0.19 | $10.14 $0.19 | https://www.digikey.com/product-detail/en/panasonic-electric-works/TQ2SS-L2-3V-Z/255-3845-1-ND/3885594 Bypass Capacitor 1 uF (1206) https://www.digikey.com/product-detail/en/yageo/CC1206KRX7R9BB104/311-1179-1-ND/303089
| | | | | | | TOTAL | 631.34
Source | Description | Units | Part number | Price/unit | Total | Purpose: X for Y Digikey | SN74LVC2G53 | 1 | 296-13269-2-ND | $0.67 | $0.67 | For signal routing on the rover Digikey | Bypass Capacitor 1 uF (1206) | 8 | 311-1179-1-ND | $0.19 | $1.52 | Passives for Rover PCB Digikey | SAMTEC TLE 14 POS | 1 | SAM10182-ND | $2.83 | $2.83 | Conector for Freewave Digikey | FREEWAVE Z9-C or Z9-T | 1 | 2108-Z9-C-ND | $490.44 | $490.44 | Radio for Rover Digikey | 900 MHz RF antenna | 1 | A09-HASM-675-ND | $25.00 | $25.00 | Antenna for radio Digikey | MMCX to SMA connector | 1 | CBA-SMA-MMCXRA-ND | $5.81 | $5.81 | Antenna adapted for radio Digikey | 2x3 2.54 mm header block | 3 | 952-2120-ND | $0.27 | $0.81 | Jumpers for Rover PCB Digikey | 2x2 2.54 mm Shunt Jumper | 2 | SAM9042-ND | $0.76 | $1.52 | Jumpers for Rover PCB Digikey | 2x1 2.54 mm Shunt Jumper | 2 | $0.10 | $0.20 | Jumpers for Rover PCB Digikey | MAX3243 | 1 | 296-6941-1-ND | $1.91 | $1.91 | RS232 interface for Z9-C Digikey | 3.5 mm 3-position screw terminal | 1 | 277-5749-ND | $1.95 | $1.95 | Screw terminal for Rover PCB Digikey | 1MOhm resistor | 1 | A119955DKR-ND | $0.52 | $0.52 | Resistor for Rover PCB Digikey | 2 M Ohms Trim Pot | 1 | CT6EP205-ND | $0.79 | $0.79 | Trim pot for rover Digikey | DS3231 | 1 | DS3231S#T&RCT-ND | $7.87 | $7.87 | RTC for rover Digikey | 10k 0603 resistors | 2 | RNCP0805FTD10K0CT-ND | $0.10 | $0.20 | resistor for RTC Digikey | MAX4280 | 1 | MAX4820EUP+CT-ND | $3.93 | $3.93 | Low side relay driver SPI Digikey | 2A Latching Relay | 2 | 255-3845-1-ND | $5.07 | $10.14 | 2A Latching Relay Adafruit | Microcontroller | 1 | $19.95 | $19.95 | Microcontroller from rover Adafruit | MMA8451 breakout | 1 | $7.95 | $7.95 | Accelerometer for Rover McMaster | Female-Female 1/4", 2-56 standoffs | 4 | $1.87 | $7.48 | Hardware for rover McMaster | 2-56 Thread, 3/16" Long Bolt | 1 | (pack of 100) | $5.40 | $5.40 | Hardware for rover McMaster | Female-Male 1/4", 2-56 standoffs | 4 | $2.15 | $8.60 | Hardware for rover Polulu | 5 Volt regulator | 1 | $11.95 | $11.95 | Voltage regulator for PCB
Polulu (https://www.pololu.com/product/3781) | 3.3 Volt regulator | 1 | $11.95 | $11.95 | Voltage regulator for PCB
Total | $629.39
Rover Pins | Function | Block A0 | Select bit | SPDT A3 | Int1 on MMA8451 | Accelerometer A1 | Battery Voltage | Power A2 | SD CARD RESET | SD
A4 | SD_CARD CS | SD
A5 | FORCEOFF_N RS232 | Radio RX (0) | Serial1_RX | Radio TX (1) | Serial1_TX | Radio
9 | CS MAX4280 | Relay 13 | VCC2_EN | Power 12 | Serial2_RX | GPS
11 | Serial2_TX | GPS
10 | CD | radio
6 | reset Radio | Radio
5 | RTC wake | RTC

SCL SDA
