OPEnSLab-OSU/SlideSentinel/Integration/Hardware/base/pcb/BaseStencil v1.stl

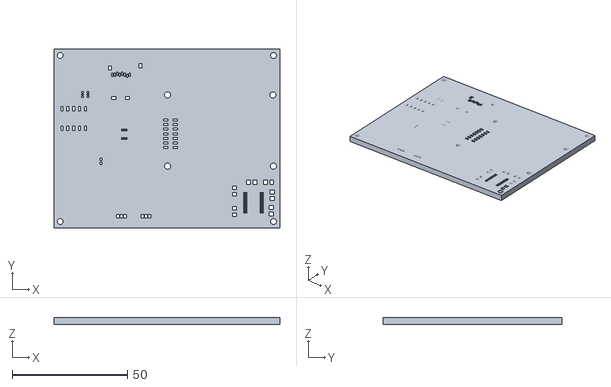
[picture p38: CAD file, 2020-05-13]
Integration/Hardware/base/pcb/BaseStencil v1.stl
98.1 x 77.6 x 3.00
