OPEnSLab-OSU/SlideSentinel/Integration/Hardware/rover/pcb/RoverStencil v1.stl

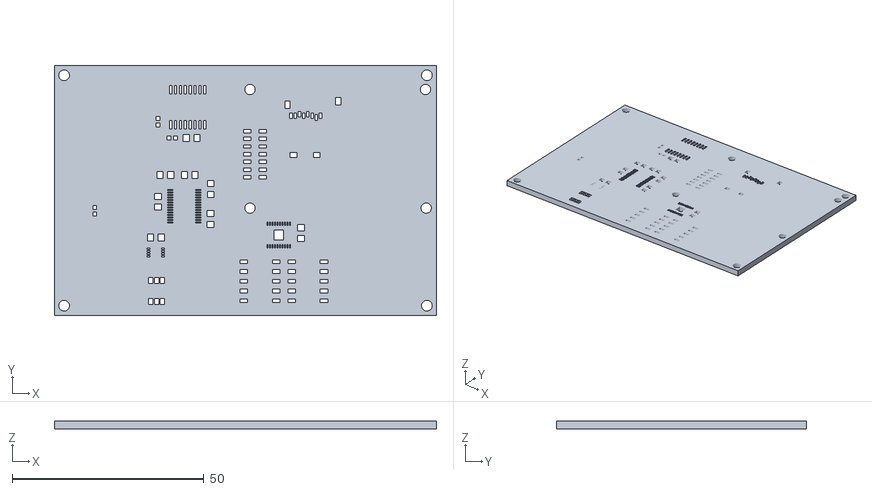
[picture p39: CAD file, 2020-05-13]
Integration/Hardware/rover/pcb/RoverStencil v1.stl
99.5 x 65.0 x 2.00
