OPEnSLab-OSU/SlideSentinel/Documentation/Photos/Hardware/baseAssembled.jpg

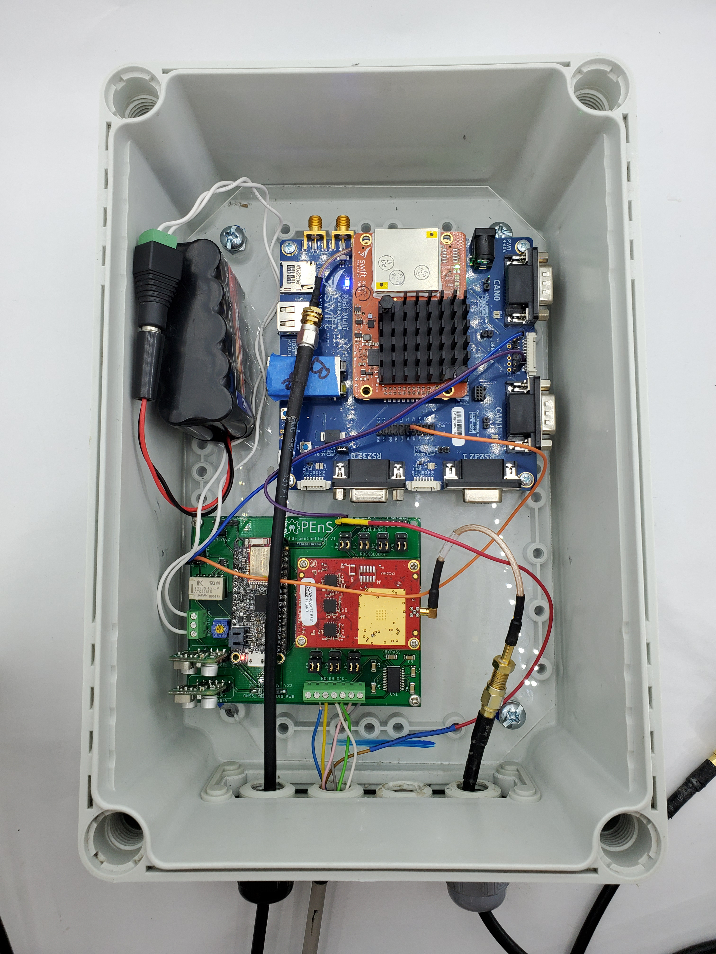
Documentation/Photos/Hardware/baseAssembled.jpg
