OPEnSLab-OSU/SlideSentinel/Documentation/Photos/Hardware/roverAssembled.jpg

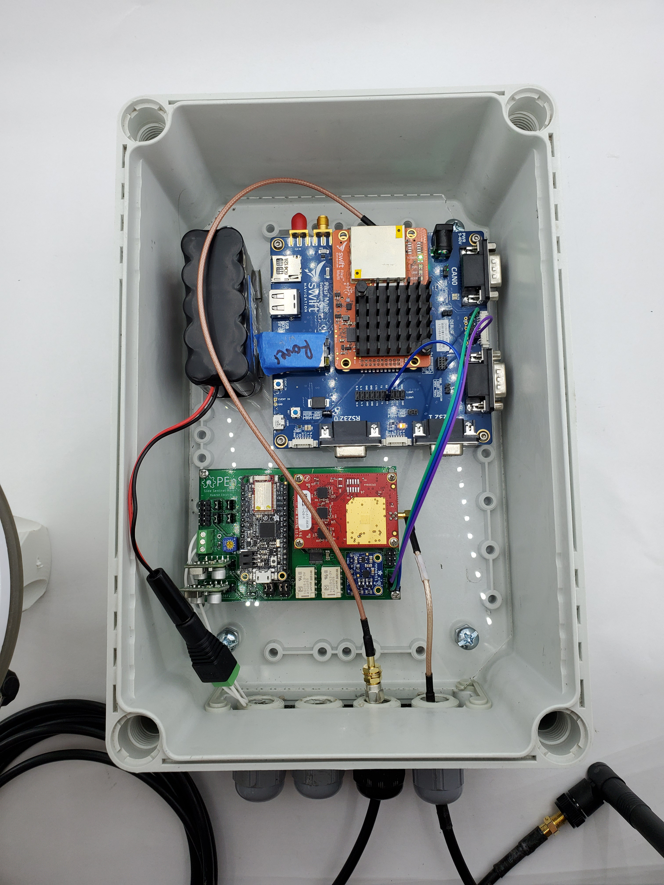
Documentation/Photos/Hardware/roverAssembled.jpg
