OPEnSLab-OSU/SlideSentinel/(threads)

Thread 2 (2018-10-23):

Configure Accelerometer Interrupts for Transient detection

lunng, 2018-10-23:
Motion detection interrupt for feather M0 needed from MMA8451 accelerometer. Preferentially single pulse, one time configuration interrupts so that the device can be set up and measured without further configuration.

lunng, 2018-11-09:
MMA done

Closed 2018-11-09.

Thread 3 (2018-10-23):

Write functional tests for Nordic 2.4GHz antennae

lunng, 2018-10-23:
Need to implement rx and tx files with large payloads for a NRF24L01+ range test. Rx and tx files are currently written, testing is required with Sparkfun boards.

Closed 2020-02-06.

Thread 54 (2022-08-23):

Gnss poll won't function unless call latency is as close to 0 as possible

AleksVidmantas, 2022-08-23:
10 ms delay seems to occasionally work, 50ms doesn't at all. 0 ms is ideal.

AleksVidmantas, 2022-08-23:
I believe this is the cause for do_every. If a delay of 0 is used, poll throws a return error on clean data

AleksVidmantas, 2022-09-01:
Additionally, a solid satellite signal with a solild yellow/orange LED is required for data to be sent.

Closed 2022-09-01.

Thread 56 (2022-09-08):

Base will acknowledge a transmission while flagging it as a retry.

AleksVidmantas, 2022-09-08:
This takes place on fullrewritetest at the current date.

AleksVidmantas, 2022-09-09:
FOR REFERENCE:
justin....@gmail.com
4:35 PM (8 minutes ago)
to radiohead-arduino
Hi,

I added a fix a while ago for what sounds like this exact issue. You can set RH_ENABLE_EXPLICIT_RETRY_DEDUP in RHReliableDatagram.h to 1 to enable my fix that checks an explicit retry bit so the server will know not to dedupe the latest message containing the same seen ID as before (since every time your client device starts up, it resets the ID to zero -- essentially always sending an ID of zero).

You can see what it is doing by search for the usage of RH_ENABLE_EXPLICIT_RETRY_DEDUP in RHReliableDatagram.cpp.

Currently you have to manually flip this value in the library itself. A few months ago I proposed a change that would make this configurable via a compiler arg so consumers can change this value without having to make changes to the lib source locally. Mike indicated that he would include this in the next release (this was in March/April of 2022, and the last release was 2022-02-02, so I don't think it has made it in yet). Here is the thread related to making it overridable: https://groups.google.com/u/1/g/radiohead-arduino/c/SyXyJe5vVKo

You should just be able to modify this flag in your local lib source. Just be aware that you will need to do this again if you upgrade the lib. Hope this solves your problem.

AleksVidmantas, 2022-09-09:
The issue was that the rover would send 1 message per wake cycle. The rover defaults to message ID 0 when turned on. Supposedly the base stores the ID of the last message. When the rover wakes up, the ID is 0 again matching the base's, causing it to get flagged as a duplicate.

NOTE: I believe this only happens if the 1st transmission fails, in addition to all of the above circumstances.

Closed 2022-09-09.

Thread 57 (2022-09-20):

RadioHead needs maxlength to be custom set if using high capacity radios

AleksVidmantas, 2022-09-20:
set RH_SERIAL_MAX_PAYLOAD_LEN  to something like 1000

AleksVidmantas, 2022-09-21:
255 is the hard max so far encountered, fixing seems unlikely, not critical
