OPEnSLab-OSU/SlideSentinel/Integration/Hardware/rover/pcb/rover_2.0.0.brd

## EAGLE design Integration/Hardware/rover/pcb/rover_2.0.0.brd (2019-12-03)

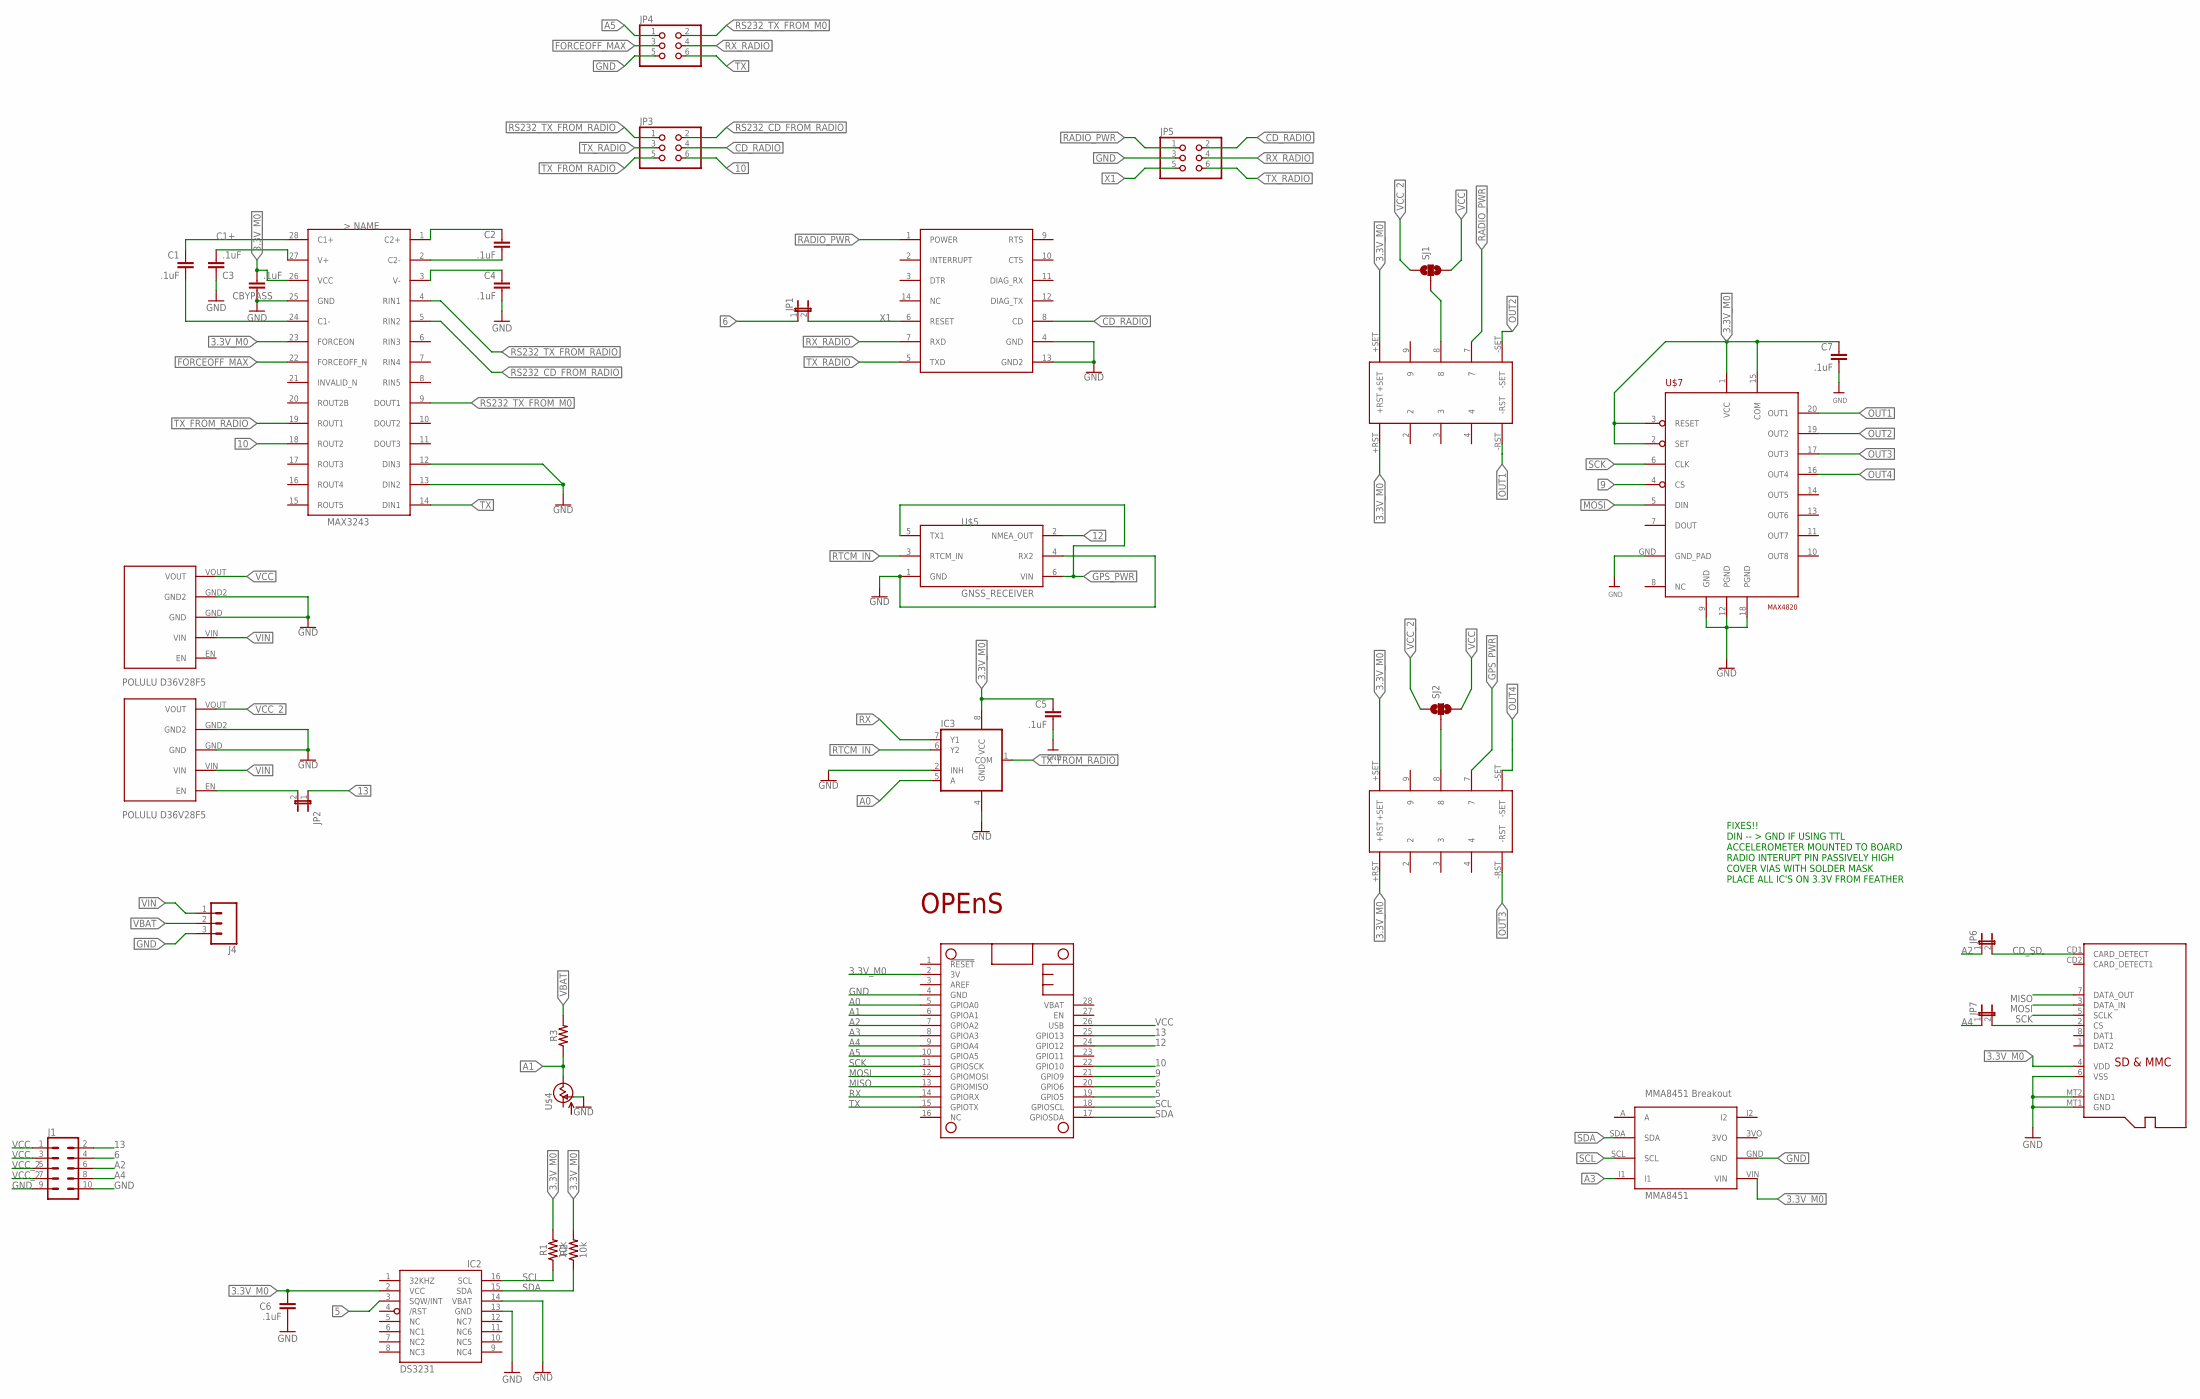
[picture p42: schematic rover_2.0.0.sch]

Parts:
C1, C2, C3, C4, C5, C6, C7: .1uF; C1206
CBYPASS: .1uF; C1206
IC2: DS3231/SO; SO16W
IC3: 741G53DCT; DCT_R-PDSO-G8
J1: CONN_05X2NO_SILK; 2X5_NOSILK
J4: CONN_03SCREW; SCREWTERMINAL-3.5MM-3
JP1, JP2, JP6, JP7: JP1E; JP1
JP3, JP4, JP5: PINHD-2X3; 2X03
MS1: FEATHERWING
R1, R2: 10k; 0603
R3: 1.6KOHM-0603-1/10W-1%; 0603
SJ1, SJ2: SOLDERJUMPER_2WAY-OLDT; SJ_2
U$1: MAX3243; SSOP-28
U$2: OPENS-LOGO
U$3, U$12: POLULU_D36V28FX
U$4: CT6EP205; CT6
U$5: GNSS_RECEIVER; HDRV6W64P254_2X3_1016X508X838B
U$7: MAX4820; TSSOP20
U$8, U$9: TQ2SS
U$11: Z9-T/Z9-C
U$13: MMA8451
U$16: MICROSD

Connections:
3.3V_M0: C5.1, C6.1, C7.1, CBYPASS.2, IC2.2 (VCC), IC3.8 (VCC), MS1.2 (3V), R1.2, R2.2, U$1.23 (FORCEON), U$1.26 (VCC), U$7.1 (VCC), U$7.2 (SET), U$7.3 (RESET), U$7.15 (COM), U$8.+RST, U$8.+SET, U$9.+RST, U$9.+SET, U$13.VIN, U$16.4 (VDD)
5: IC2.3 (SQW/INT), MS1.19 (GPIO5)
6: J1.4, JP1.1, MS1.20 (GPIO6)
9: MS1.21 (GPIO9), U$7.4 (CS)
10: JP3.6, MS1.22 (GPIO10), U$1.18 (ROUT2)
12: MS1.24 (GPIO12), U$5.2 (NMEA_OUT)
13: J1.2, JP2.1, MS1.25 (GPIO13)
A0: IC3.5 (A), MS1.5 (GPIOA0)
A1: MS1.6 (GPIOA1), R3.1, U$4.S (VSS)
A2: J1.6, JP6.1, MS1.7 (GPIOA2)
A3: MS1.8 (GPIOA3), U$13.I1
A4: J1.8, JP7.1, MS1.9 (GPIOA4)
A5: JP4.1, MS1.10 (GPIOA5)
C1+: C1.1, U$1.28 (C1+)
CD_RADIO: JP3.4, JP5.2, U$11.8 (CD)
CD_SD: JP6.2, U$16.CD1 (CARD_DETECT)
CS_SD: JP7.2, U$16.2 (CS)
FORCEOFF_MAX: JP4.3, U$1.22 (FORCEOFF_N)
GND: C3.1, C4.2, C5.2, C6.2, C7.2, CBYPASS.1, IC2.13 (GND), IC2.14 (VBAT), IC3.2 (INH), IC3.4 (GND), J1.9, J1.10, J4.3, JP4.5, JP5.3, MS1.4 (GND), U$1.12 (DIN3), U$1.13 (DIN2), U$1.25 (GND), U$3.GND, U$3.GND2, U$4.A (OUT), U$5.1 (GND), U$5.4 (RX2), U$7.9 (GND), U$7.12 (PGND), U$7.18 (PGND), U$7.GND (GND_PAD), U$11.4 (GND), U$11.13 (GND2), U$12.GND, U$12.GND2, U$13.GND, U$16.6 (VSS), U$16.MT1 (GND), U$16.MT2 (GND1)
GPS_PWR: U$5.5 (TX1), U$5.6 (VIN), U$9.7
MISO: MS1.13 (GPIOMISO), U$16.7 (DATA_OUT)
MOSI: MS1.12 (GPIOMOSI), U$7.5 (DIN), U$16.3 (DATA_IN)
unnamed: SJ2.2, U$9.8
unnamed: SJ1.2, U$8.8
unnamed: C2.1, U$1.1 (C2+)
unnamed: C2.2, U$1.2 (C2-)
unnamed: C4.1, U$1.3 (V-)
unnamed: C1.2, U$1.24 (C1-)
unnamed: C3.2, U$1.27 (V+)
OUT1: U$7.20 (OUT1), U$8.-RST
OUT2: U$7.19 (OUT2), U$8.-SET
OUT3: U$7.17 (OUT3), U$9.-RST
OUT4: U$7.16 (OUT4), U$9.-SET
RADIO_PWR: JP5.1, U$8.7, U$11.1 (POWER)
RS232_CD_FROM_RADIO: JP3.2, U$1.5 (RIN2)
RS232_TX_FROM_M0: JP4.2, U$1.9 (DOUT1)
RS232_TX_FROM_RADIO: JP3.1, U$1.4 (RIN1)
RTCM_IN: IC3.6 (Y2), U$5.3 (RTCM_IN)
RX: IC3.7 (Y1), MS1.14 (GPIORX)
RX_RADIO: JP4.4, JP5.4, U$11.7 (RXD)
SCK: MS1.11 (GPIOSCK), U$7.6 (CLK), U$16.5 (SCLK)
SCL: IC2.16 (SCL), MS1.18 (GPIOSCL), R1.1, U$13.SCL
SDA: IC2.15 (SDA), MS1.17 (GPIOSDA), R2.1, U$13.SDA
TX: JP4.6, MS1.15 (GPIOTX), U$1.14 (DIN1)
TX_FROM_RADIO: IC3.1 (COM), JP3.5, U$1.19 (ROUT1)
TX_RADIO: JP3.3, JP5.6, U$11.5 (TXD)
VBAT: J4.2, R3.2
VCC: J1.1, J1.3, MS1.26 (USB), SJ1.3, SJ2.3, U$3.VOUT
VCC_2: J1.5, J1.7, SJ1.1, SJ2.1, U$12.VOUT
VIN: J4.1, U$3.VIN, U$12.VIN
X1: JP1.2, JP5.5, U$11.6 (RESET)
X2: JP2.2, U$12.EN

Notes on the sheet:
FIXES!! DIN -- > GND IF USING TTL ACCELEROMETER MOUNTED TO BOARD RADIO INTERUPT PIN PASSIVELY HIGH COVER VIAS WITH SOLDER MASK PLACE ALL IC'S ON 3.3V FROM FEATHER

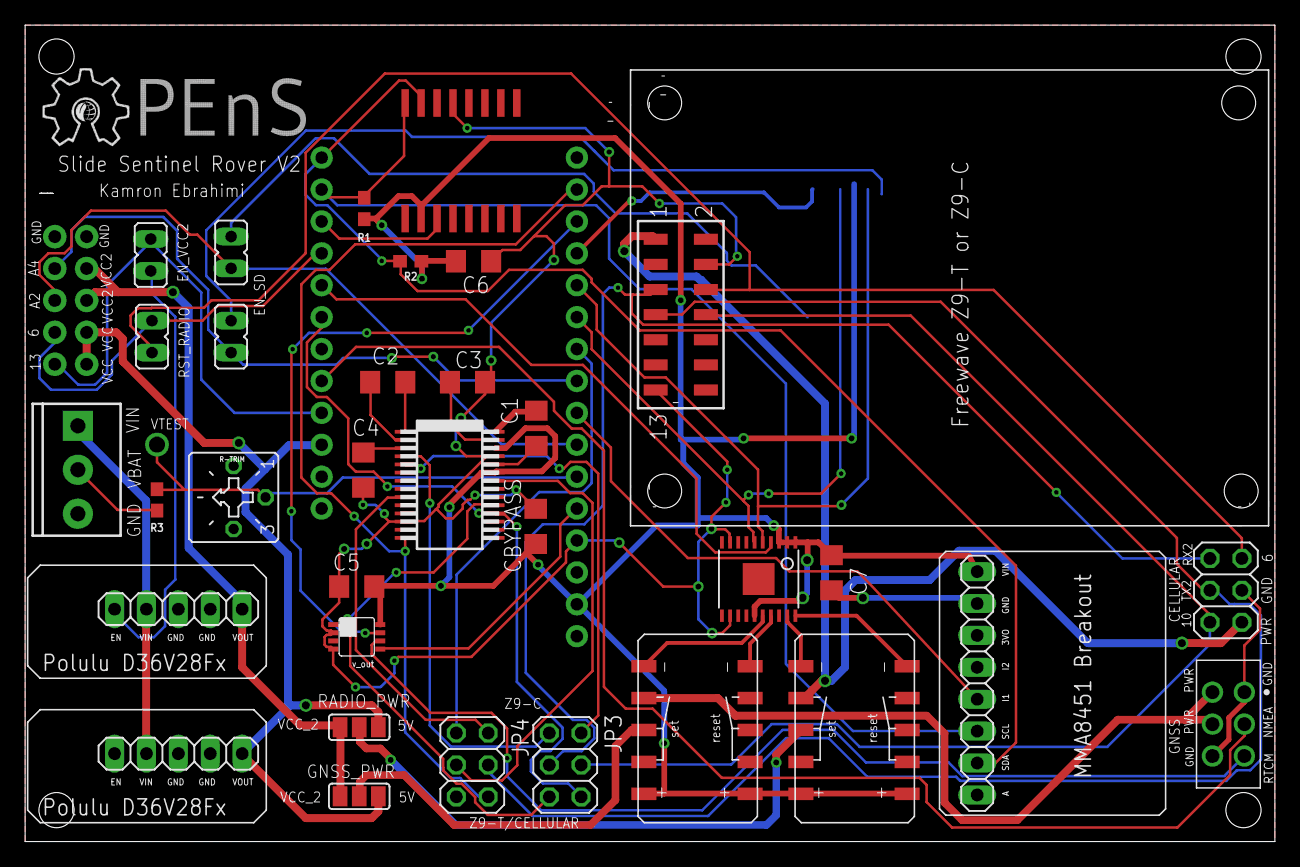
[picture p43: board rover_2.0.0.brd from above]

Board: 2 copper layers, 99.5 x 65.0 mm, 37 parts (1 on the bottom side), 52 nets.
