OPEnSLab-OSU/SlideSentinel/Integration/Hardware/base/pcb/base_2.0.0.brd

## EAGLE design Integration/Hardware/base/pcb/base_2.0.0.brd (2019-12-03)

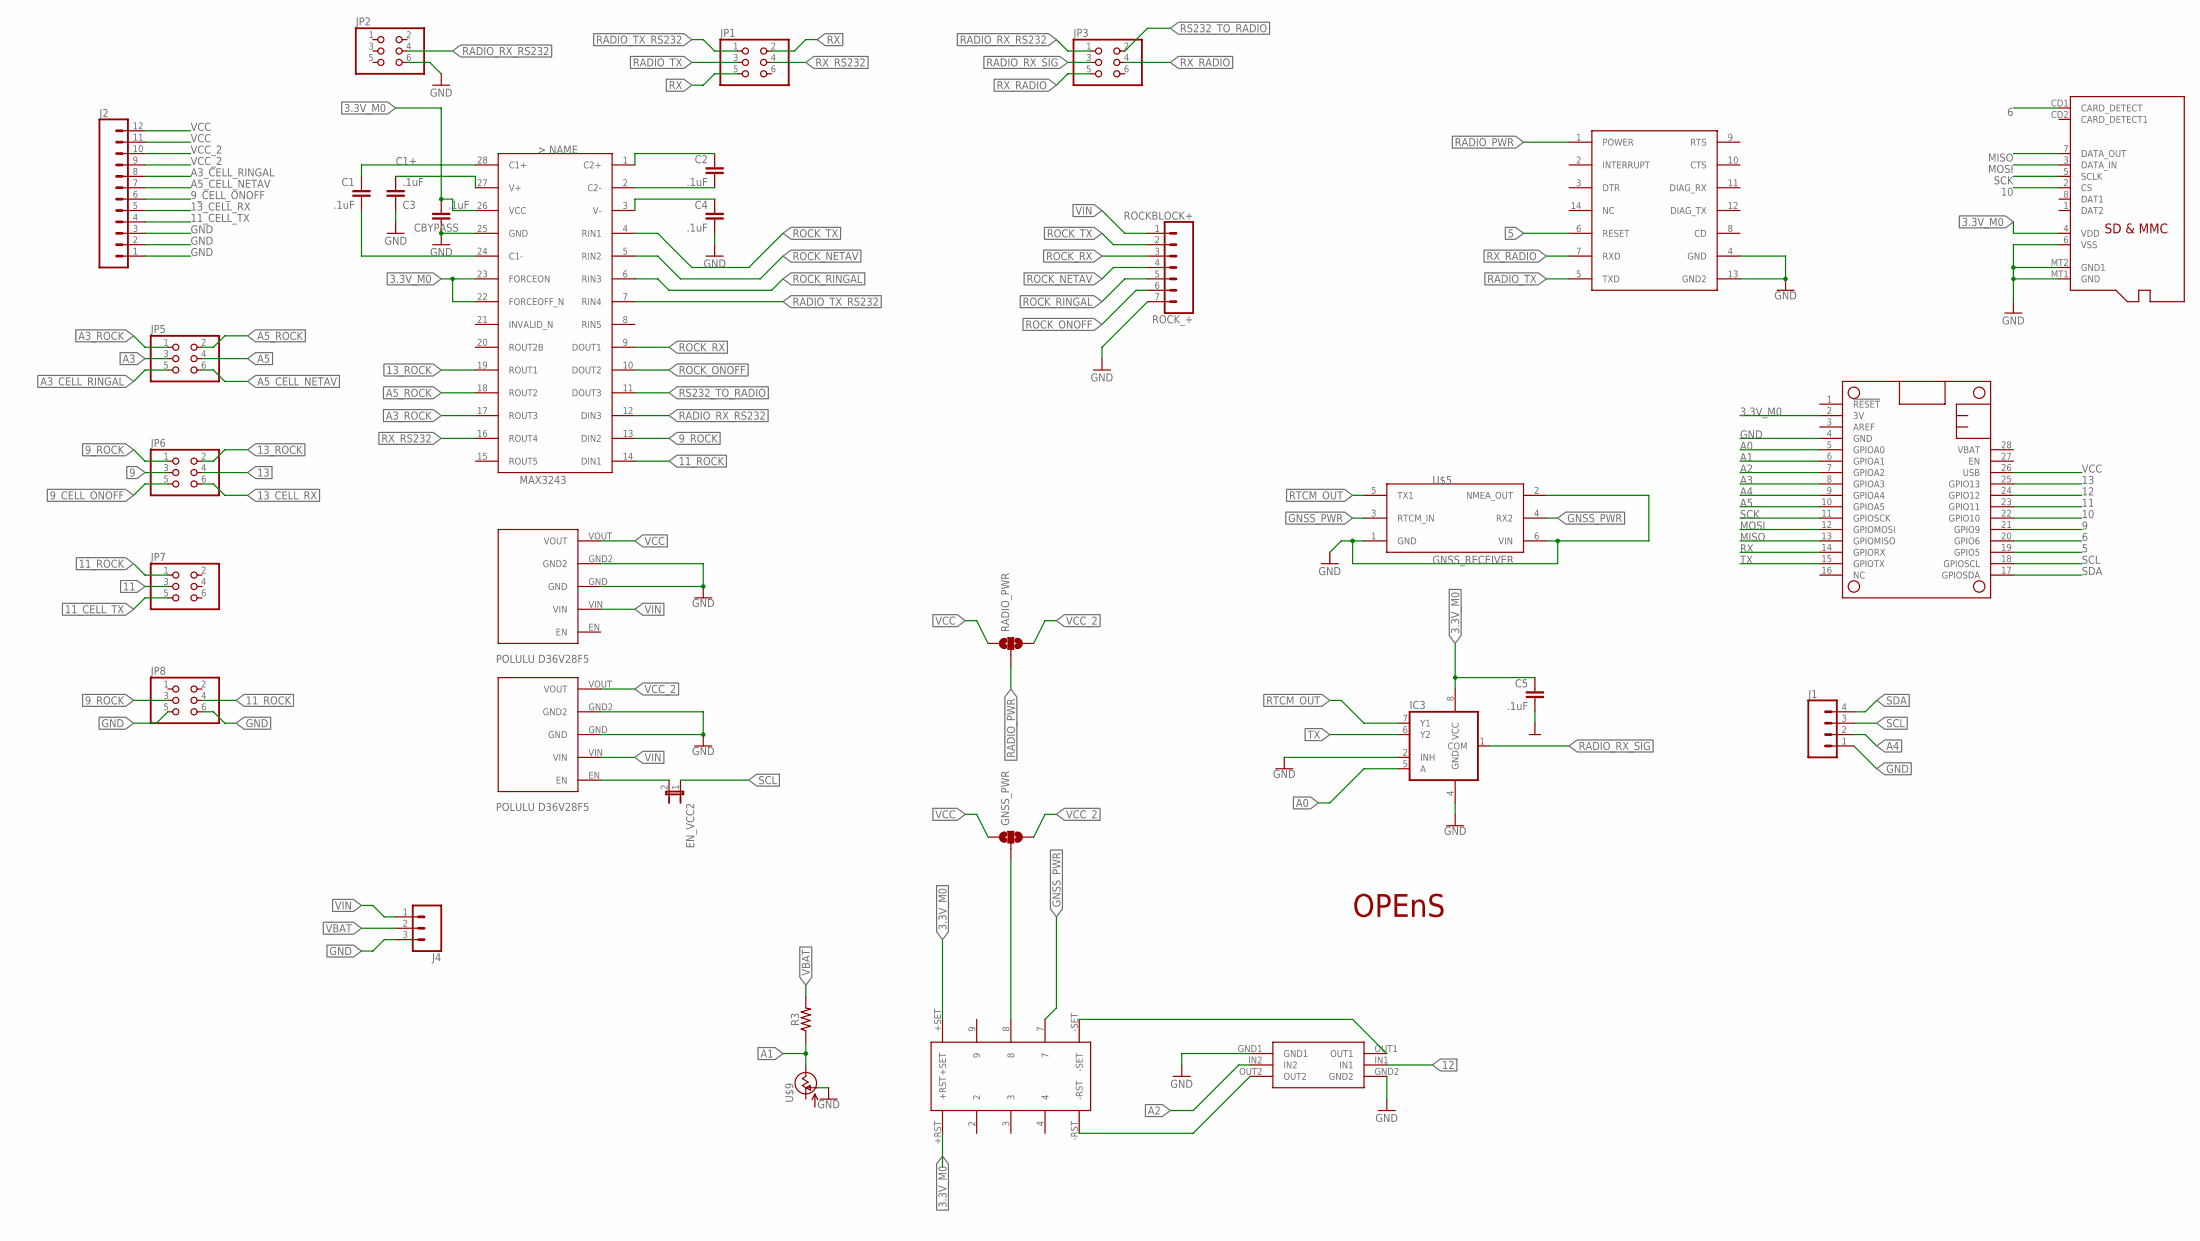
[picture p44: schematic base_2.0.0.sch]

Parts:
C1, C2, C3, C4, C5: .1uF; C1206
CBYPASS: .1uF; C1206
EN_VCC2: JP1E; JP1
GNSS_PWR: SOLDERJUMPER_2WAY-OLDT; SJ_2
IC3: 741G53DCT; DCT_R-PDSO-G8
J1: CONN_04; 1X04
J2: CONN_12; 1X12
J4: CONN_03SCREW; SCREWTERMINAL-3.5MM-3
JP1, JP2, JP3, JP5, JP6, JP7, JP8: PINHD-2X3; 2X03
MS1: FEATHERWING
R3: 1.6KOHM-0603-1/10W-1%; 0603
RADIO_PWR: SOLDERJUMPER_2WAY-OLDT; SJ_2
ROCK_+: ROCKBLOCK+; SCREWTERMINAL-3.5MM-7
U$1: MAX3243; SSOP-28
U$2: OPENS-LOGO
U$3, U$12: POLULU_D36V28FX
U$4: MICROSD
U$5: GNSS_RECEIVER; HDRV6W64P254_2X3_1016X508X838B
U$7: DRDC3105; SOT26
U$8: TQ2SS
U$9: CT6EP205; CT6
U$11: Z9-T/Z9-C

Connections:
3.3V_M0: C5.1, CBYPASS.2, IC3.8 (VCC), MS1.2 (3V), U$1.22 (FORCEOFF_N), U$1.23 (FORCEON), U$1.26 (VCC), U$4.4 (VDD), U$8.+RST, U$8.+SET
5: MS1.19 (GPIO5), U$11.6 (RESET)
6: MS1.20 (GPIO6), U$4.CD1 (CARD_DETECT)
9: JP6.3, MS1.21 (GPIO9)
9_CELL_ONOFF: J2.6, JP6.5
9_ROCK: JP6.1, JP8.3, U$1.13 (DIN2)
10: MS1.22 (GPIO10), U$4.2 (CS)
11: JP7.3, MS1.23 (GPIO11)
11_CELL_TX: J2.4, JP7.5
11_ROCK: JP7.1, JP8.4, U$1.14 (DIN1)
12: MS1.24 (GPIO12), U$7.IN1
13: JP6.4, MS1.25 (GPIO13)
13_CELL_RX: J2.5, JP6.6
13_ROCK: JP6.2, U$1.19 (ROUT1)
A0: IC3.5 (A), MS1.5 (GPIOA0)
A1: MS1.6 (GPIOA1), R3.1, U$9.S (VSS)
A2: MS1.7 (GPIOA2), U$7.IN2
A3: JP5.3, MS1.8 (GPIOA3)
A3_CELL_RINGAL: J2.8, JP5.5
A3_ROCK: JP5.1, U$1.17 (ROUT3)
A4: J1.2, MS1.9 (GPIOA4)
A5: JP5.4, MS1.10 (GPIOA5)
A5_CELL_NETAV: J2.7, JP5.6
A5_ROCK: JP5.2, U$1.18 (ROUT2)
C1+: C1.1, U$1.28 (C1+)
GND: C3.1, C4.2, C5.2, CBYPASS.1, IC3.2 (INH), IC3.4 (GND), J1.1, J2.1, J2.2, J2.3, J4.3, JP2.6, JP8.5, JP8.6, MS1.4 (GND), ROCK_+.7, U$1.25 (GND), U$3.GND, U$3.GND2, U$4.6 (VSS), U$4.MT1 (GND), U$4.MT2 (GND1), U$5.1 (GND), U$5.2 (NMEA_OUT), U$5.6 (VIN), U$7.GND1, U$7.GND2, U$9.A (OUT), U$11.4 (GND), U$11.13 (GND2), U$12.GND, U$12.GND2
GNSS_PWR: U$5.3 (RTCM_IN), U$5.4 (RX2), U$8.7
MISO: MS1.13 (GPIOMISO), U$4.7 (DATA_OUT)
MOSI: MS1.12 (GPIOMOSI), U$4.3 (DATA_IN)
unnamed: GNSS_PWR.2, U$8.8
unnamed: C2.1, U$1.1 (C2+)
unnamed: C2.2, U$1.2 (C2-)
unnamed: U$7.OUT2, U$8.-RST
unnamed: U$7.OUT1, U$8.-SET
unnamed: EN_VCC2.2, U$12.EN
unnamed: C4.1, U$1.3 (V-)
unnamed: C1.2, U$1.24 (C1-)
unnamed: C3.2, U$1.27 (V+)
RADIO_PWR: RADIO_PWR.2, U$11.1 (POWER)
RADIO_RX_RS232: JP2.4, JP3.1, U$1.12 (DIN3)
RADIO_RX_SIG: IC3.1 (COM), JP3.3
RADIO_TX: JP1.3, U$11.5 (TXD)
RADIO_TX_RS232: JP1.1, U$1.7 (RIN4)
ROCK_NETAV: ROCK_+.4, U$1.5 (RIN2)
ROCK_ONOFF: ROCK_+.6, U$1.10 (DOUT2)
ROCK_RINGAL: ROCK_+.5, U$1.6 (RIN3)
ROCK_RX: ROCK_+.3, U$1.9 (DOUT1)
ROCK_TX: ROCK_+.2, U$1.4 (RIN1)
RS232_TO_RADIO: JP3.2, U$1.11 (DOUT3)
RTCM_OUT: IC3.7 (Y1), U$5.5 (TX1)
RX: JP1.2, JP1.5, MS1.14 (GPIORX)
RX_RADIO: JP3.4, JP3.5, U$11.7 (RXD)
RX_RS232: JP1.4, U$1.16 (ROUT4)
SCK: MS1.11 (GPIOSCK), U$4.5 (SCLK)
SCL: EN_VCC2.1, J1.3, MS1.18 (GPIOSCL)
SDA: J1.4, MS1.17 (GPIOSDA)
TX: IC3.6 (Y2), MS1.15 (GPIOTX)
VBAT: J4.2, R3.2
VCC: GNSS_PWR.1, J2.11, J2.12, MS1.26 (USB), RADIO_PWR.1, U$3.VOUT
VCC_2: GNSS_PWR.3, J2.9, J2.10, RADIO_PWR.3, U$12.VOUT
VIN: J4.1, ROCK_+.1, U$3.VIN, U$12.VIN

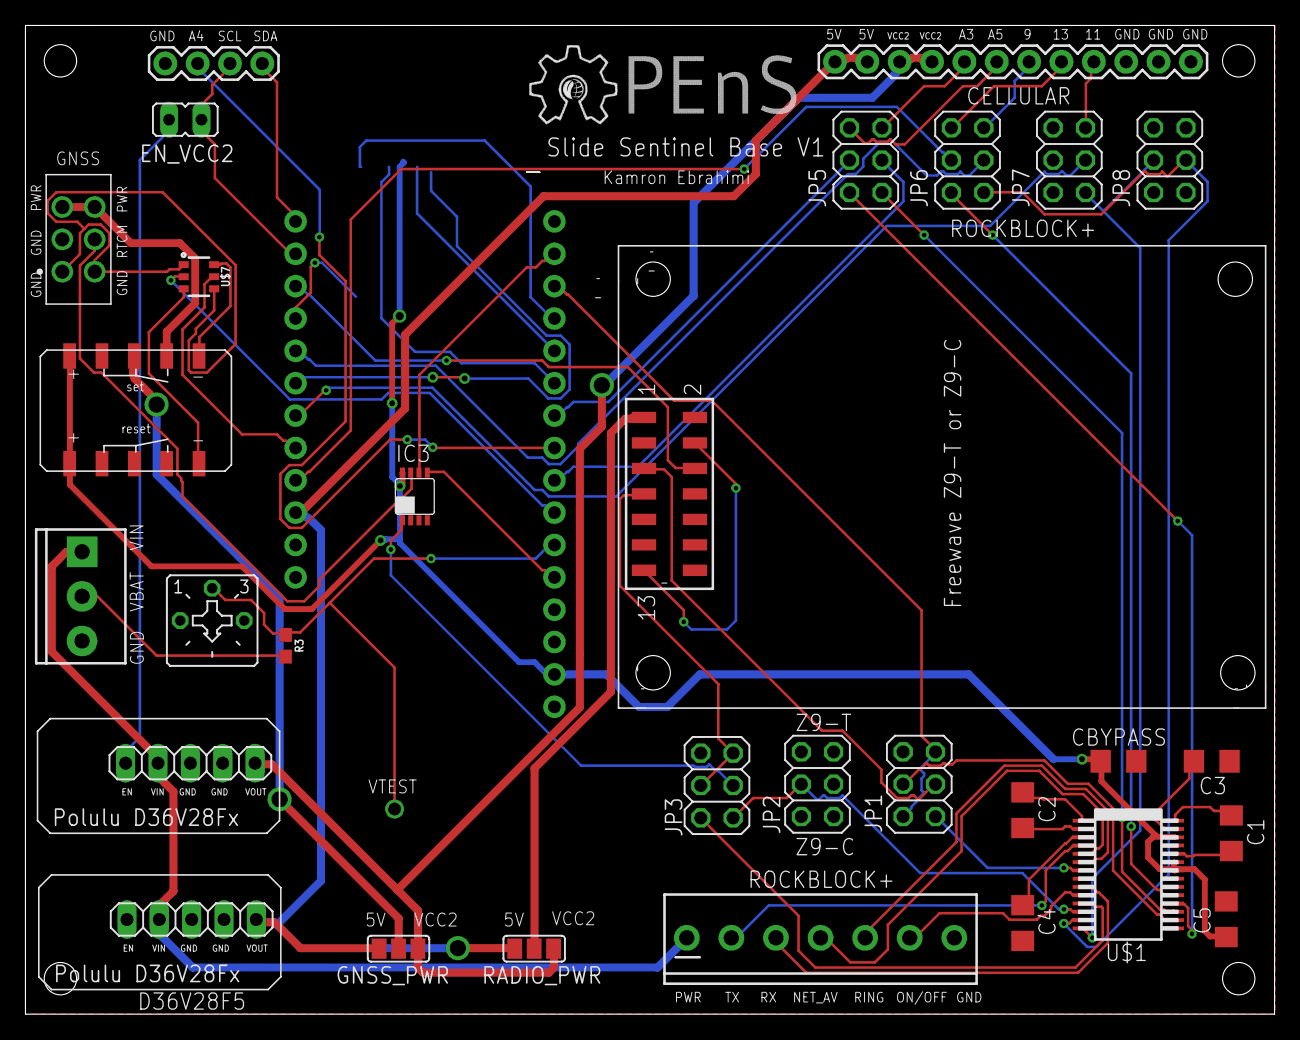
[picture p45: board base_2.0.0.brd from above]

Board: 2 copper layers, 98.1 x 77.6 mm, 33 parts (1 on the bottom side), 61 nets.
