OPEnSLab-OSU/SlideSentinel/Legacy/Phase2Legacy/Rover/PCB/simplePCB/roverPCB_simple.brd

## EAGLE design Legacy/Phase2Legacy/Rover/PCB/simplePCB/roverPCB_simple.brd (2019-12-03, an earlier design)

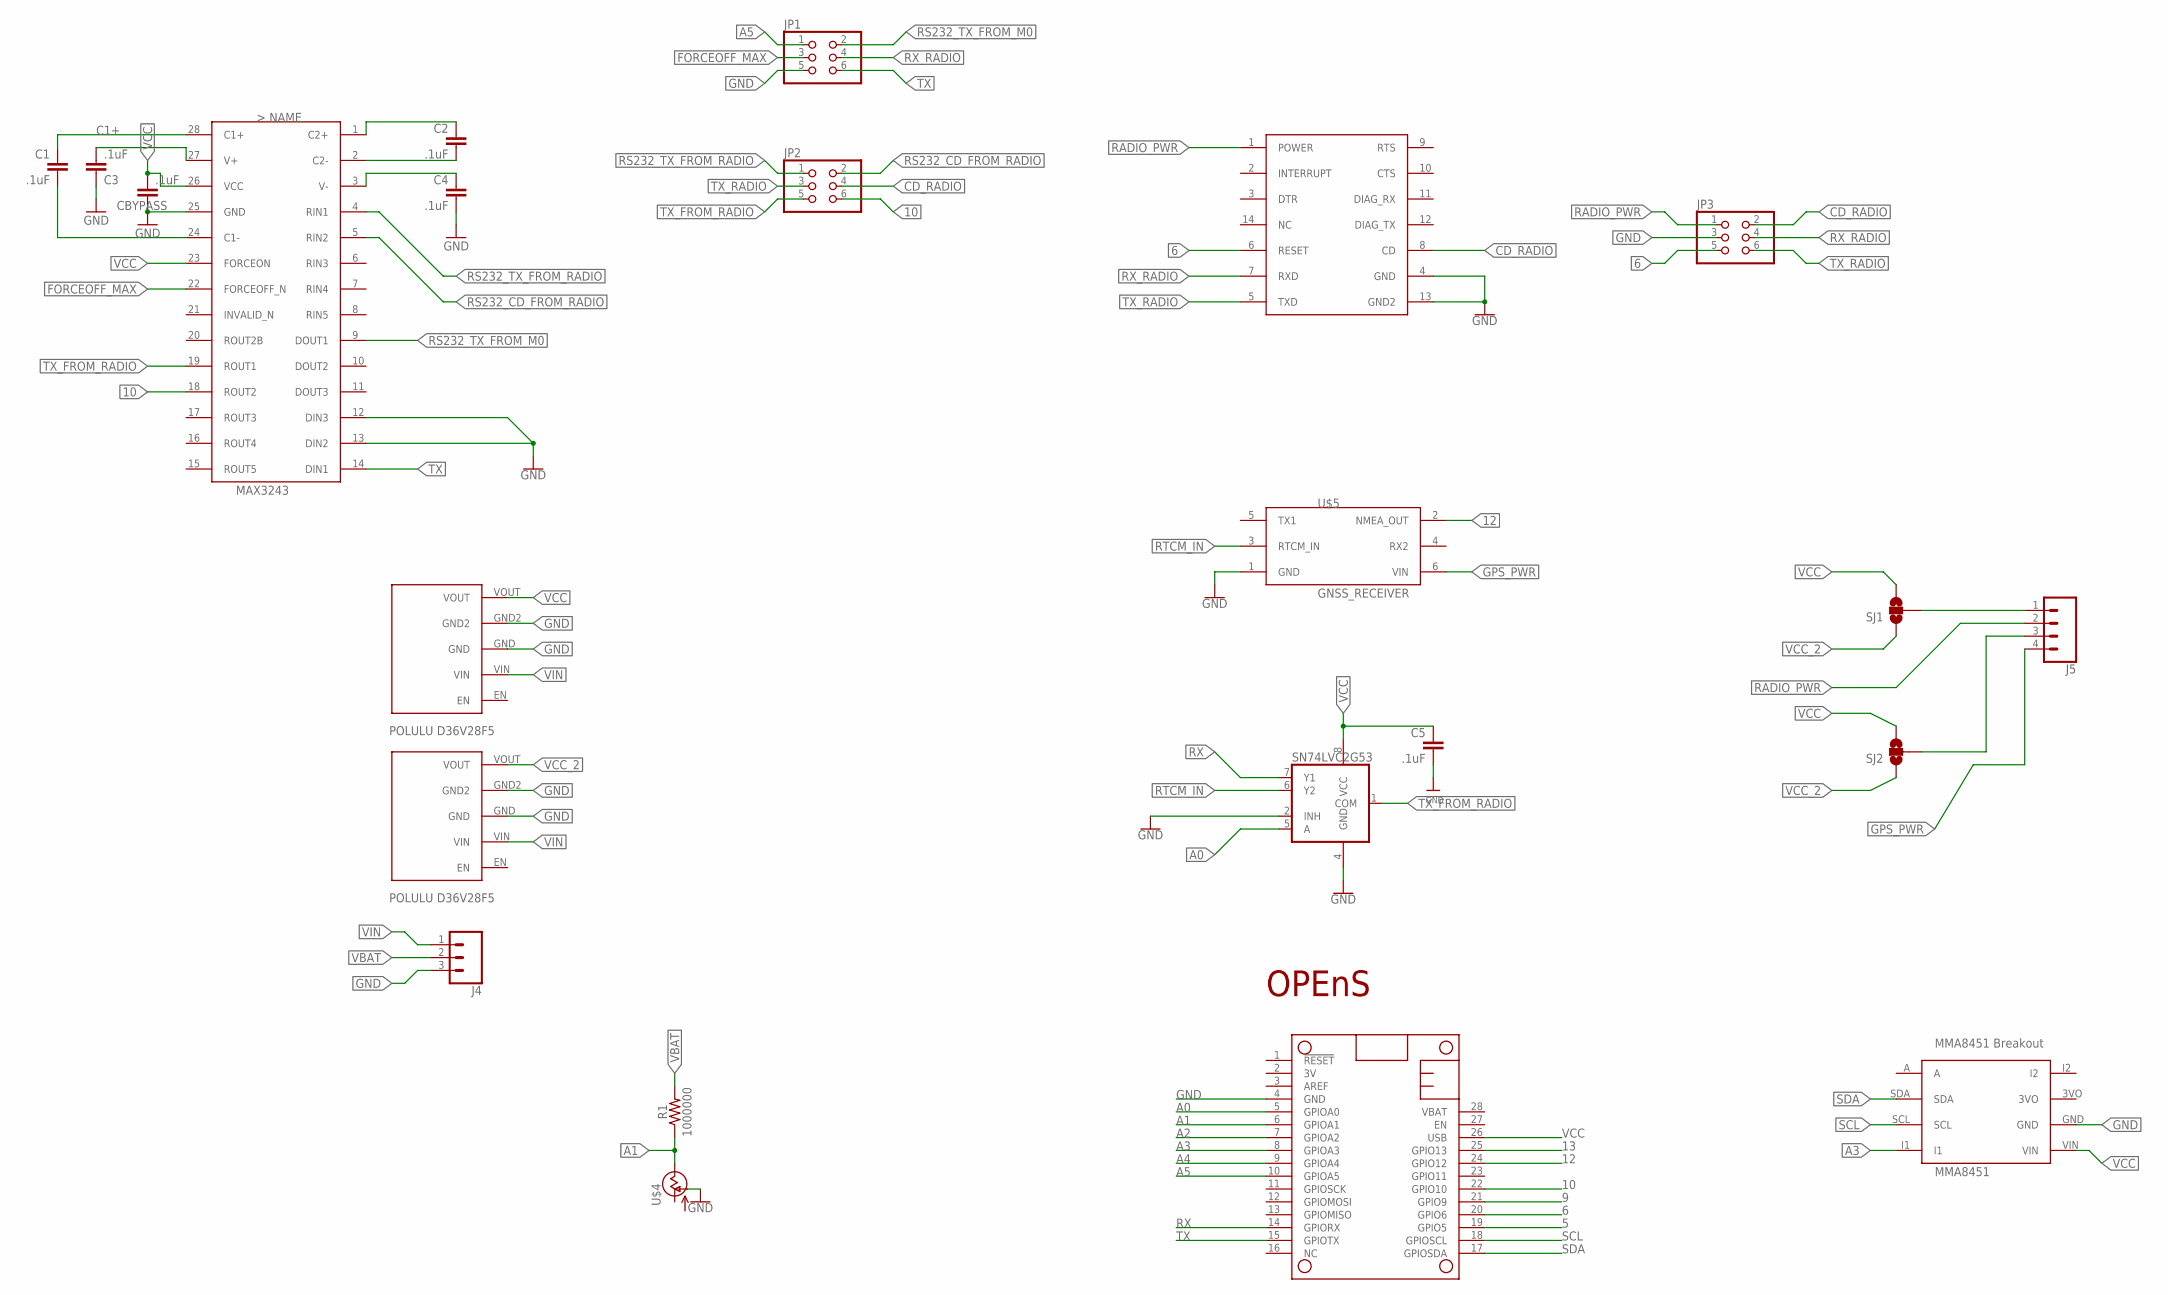
[picture p46: schematic roverPCB_simple.sch]

Parts:
C1, C2, C3, C4, C5: .1uF; C1206
CBYPASS: .1uF; C1206
J4: CONN_03SCREW; SCREWTERMINAL-3.5MM-3
J5: CONN_04SCREW; SCREWTERMINAL-3.5MM-4
JP1, JP2, JP3: PINHD-2X3; 2X03
MS1: FEATHERWING
R1: 1000000; 0603
SJ1, SJ2: SOLDERJUMPER_2WAY-OLDT; SJ_2
SN74LVC2G53: 741G53DCT; DCT_R-PDSO-G8
U$1: MAX3243; SSOP-28
U$2: OPENS-LOGO
U$3: Z9-T/Z9-C
U$4: CT6EP205; CT6
U$5: GNSS_RECEIVER; MA03-2
U$7, U$8: POLULU_D36V28FX
U$9: MMA8451

Connections:
5: MS1.19 (GPIO5)
6: JP3.5, MS1.20 (GPIO6), U$3.6 (RESET)
9: MS1.21 (GPIO9)
10: JP2.6, MS1.22 (GPIO10), U$1.18 (ROUT2)
12: MS1.24 (GPIO12), U$5.2 (NMEA_OUT)
13: MS1.25 (GPIO13)
A0: MS1.5 (GPIOA0), SN74LVC2G53.5 (A)
A1: MS1.6 (GPIOA1), R1.1, U$4.S (VSS)
A2: MS1.7 (GPIOA2)
A3: MS1.8 (GPIOA3), U$9.I1
A4: MS1.9 (GPIOA4)
A5: JP1.1, MS1.10 (GPIOA5)
C1+: C1.1, U$1.28 (C1+)
CD_RADIO: JP2.4, JP3.2, U$3.8 (CD)
FORCEOFF_MAX: JP1.3, U$1.22 (FORCEOFF_N)
GND: C3.1, C4.2, C5.2, CBYPASS.1, J4.3, JP1.5, JP3.3, MS1.4 (GND), SN74LVC2G53.2 (INH), SN74LVC2G53.4 (GND), U$1.12 (DIN3), U$1.13 (DIN2), U$1.25 (GND), U$3.4 (GND), U$3.13 (GND2), U$4.A (OUT), U$5.1 (GND), U$7.GND, U$7.GND2, U$8.GND, U$8.GND2, U$9.GND
GPS_PWR: J5.4, U$5.6 (VIN)
unnamed: C2.1, U$1.1 (C2+)
unnamed: C2.2, U$1.2 (C2-)
unnamed: J5.1, SJ1.2
unnamed: C4.1, U$1.3 (V-)
unnamed: C1.2, U$1.24 (C1-)
unnamed: J5.3, SJ2.2
unnamed: C3.2, U$1.27 (V+)
RADIO_PWR: J5.2, JP3.1, U$3.1 (POWER)
RS232_CD_FROM_RADIO: JP2.2, U$1.5 (RIN2)
RS232_TX_FROM_M0: JP1.2, U$1.9 (DOUT1)
RS232_TX_FROM_RADIO: JP2.1, U$1.4 (RIN1)
RTCM_IN: SN74LVC2G53.6 (Y2), U$5.3 (RTCM_IN)
RX: MS1.14 (GPIORX), SN74LVC2G53.7 (Y1)
RX_RADIO: JP1.4, JP3.4, U$3.7 (RXD)
SCL: MS1.18 (GPIOSCL), U$9.SCL
SDA: MS1.17 (GPIOSDA), U$9.SDA
TX: JP1.6, MS1.15 (GPIOTX), U$1.14 (DIN1)
TX_FROM_RADIO: JP2.5, SN74LVC2G53.1 (COM), U$1.19 (ROUT1)
TX_RADIO: JP2.3, JP3.6, U$3.5 (TXD)
VBAT: J4.2, R1.2
VCC: C5.1, CBYPASS.2, MS1.26 (USB), SJ1.3, SJ2.3, SN74LVC2G53.8 (VCC), U$1.23 (FORCEON), U$1.26 (VCC), U$7.VOUT, U$9.VIN
VCC_2: SJ1.1, SJ2.1, U$8.VOUT
VIN: J4.1, U$7.VIN, U$8.VIN

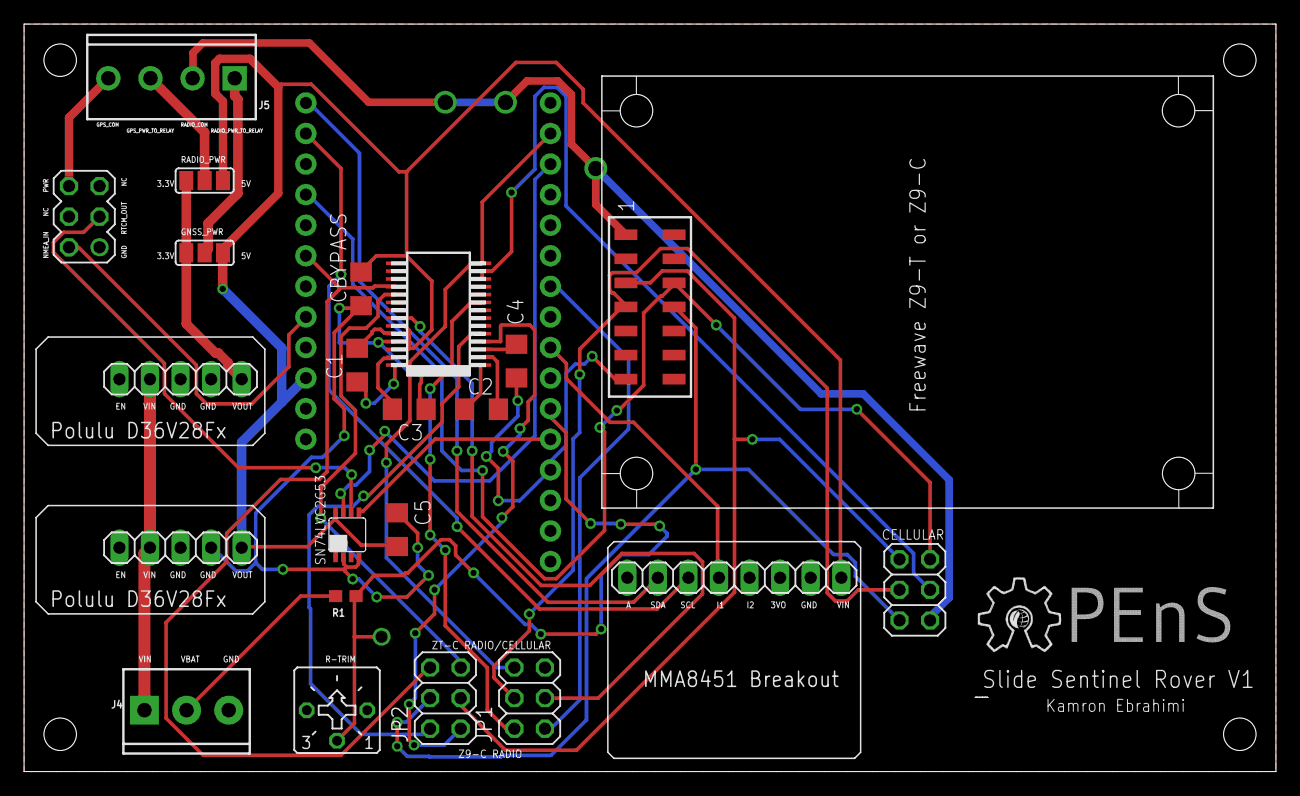
[picture p47: board roverPCB_simple.brd from above]

Board: 2 copper layers, 104.0 x 62.1 mm, 24 parts (0 on the bottom side), 35 nets.
