OPEnSLab-OSU/SlideSentinel/edit_files/P1_SS_Debug_LoopControl/P1_SS_Debug_LoopControl.ino

/*******************************************************************************************
    SlideSentinel: Phase 1 Sensor code
    Author: Marissa Kwon, Grayland Lunn
    8/24/18

    Use ctrl-f and search for every "IMPORTANT" comment before compiling and running, 
    these include notes for libraries and edits to dependant files.

    Slide Sentinel master code, fully operational, configure using preprocessor definitions

    info on devices can be found here:
    LIS3DH: https://learn.sparkfun.com/tutorials/lis3dh-hookup-guide
      SOURCE CODE FROM EXAMPLE: "IntUsage.ino"
      Marshall Taylor @ SparkFun Electronics
      Nov 16, 2016
      https://github.com/sparkfun/LIS3DH_Breakout
      https://github.com/sparkfun/SparkFun_LIS3DH_Arduino_Library

      See ST docs for information
      Doc ID 18198 (AN3308): LIS3DHpplication information
      Doc ID 17530: LIS3DH datasheet
**********************************************************************************************/

// necessary libraries here
#include <Arduino.h>
#include <SPI.h>
#include <RH_RF95.h> // Important Example code found at https://learn.adafruit.com/adafruit-rfm69hcw-and-rfm96-rfm95-rfm98-lora-packet-padio-breakouts/rfm9x-test
#include <RHReliableDatagram.h>
#include "LowPower.h" // from sparkfun low power library found here https://github.com/rocketscream/Low-Power
#include "RTClibExtended.h"// from sparkfun low power library found here https://github.com/FabioCuomo/FabioCuomo-DS3231/
#include "SparkFunLIS3DH.h"// from sparkfun accelerometer library found here https://github.com/sparkfun/SparkFun_LIS3DH_Arduino_Library
#include "wiring_private.h" // pinPeripheral() function
#include "Wire.h"

//IMPORTANT: Must include the following line in the RTClibExtended.h file to use with M0:
//#define _BV(bit) (1 << (bit))
#include <RTClibExtended.h>
#include <EnableInterrupt.h>

// Define mode constants
#define DEBUG 1       // allow printing to serial monitor,
                      // serial monitor must be opened before device will start to function in debug mode
#define RTC_MODE 1    // enable RTC interrupts
#define SD_WRITE 0    // enable SD card logging, not yuet implemented

// Define LoRa constants
#define TIMEOUT 15            // Serial NMEA timeout in ms
#define SERVER_ADDRESS 12     // IMPORTANT: should be between 0 and N_NODES constant in the HUB code (not including N_NODES)
#define LORA_HUB_ADDRESS 20   // IMPORTANT: set equal to the N_NODES constant in the HUB code
#define RTK_SERVER 21         // IMPORTANT: must be same as RTK server in HUB and server code
#define RF95_FREQ 915.0

// ======== Timer periods for different measurement conditions ==========
// Feel free to edit or change these, be aware of race condition when wake period is longer than WAKE time, device may go to sleep indefinitely (not tested)
#define RTC_WAKE_PERIOD 1      // Interval to wake and take sample in Min, reset alarm based on this period (Bo - 5 min), 15 min
#define STANDARD_WAKE 300       // Length of time to take measurements under periodic wake condition,
#define ALERT_WAKE 300          // Length of time to take measurements under acceleration wake condition
#define ACCEL_SAMPLE_PERIOD 15  // Number of seconds to take and send acceleration measurements (sent to base)
#define NMEA_SEND 10            // Number of seconds between transmission of NMEA strings to base


// ======== Pin Assignments, no need to change ==========
// Other pins in use: 13, 10, 6, A5 for UARTs 
// (can possibly use A5 and/or 13, they are defined as UART but unused in this implementation)
#define ACCEL_EN_PIN A1     // Interrupt driven, connect to switch for toggle
#define GPS_EN_PIN A2       // Attach to RESET on relay
#define ALERT_WAKE_PIN A3   // Attach A3 to int1 on accelerometer
#define GPS_DISABLE_PIN A4  // Attach to SET on relay
#define VBATPIN A7    
#define RTC_WAKE_PIN 12     // Attach to SQW pin on RTC
#define RFM95_CS 8          // LORA PIN
#define RFM95_RST 4         // LORA PIN
#define RFM95_INT 3         // LORA PIN


//Holds an NMEA string
struct loraString {
  char data[100];
  short int len;
};


#ifdef __SAMD21G18A__
#define is_M0
#endif

// ======== General Settings ==========

//sensors
LIS3DH myIMU(I2C_MODE, 0x19);       // Default accel constructor is I2C, addr 0x19.
RTC_DS3231 RTC_DS;                  //  instance of DS3231 RTC
RH_RF95 rf95(RFM95_CS, RFM95_INT);  // instance of LoRa
RHReliableDatagram manager(rf95, SERVER_ADDRESS);  //LoRa message verification


// ======== Serial Port Init ==========
// RX pin 13, TX pin 10, configuring for rover UART
Uart Serial2 (&sercom1, 13, 10, SERCOM_RX_PAD_1, UART_TX_PAD_2);
void SERCOM1_Handler()
{
  Serial2.IrqHandler();
}

/***********************IMPORTANT********************************/
// to use SERCOM5, comment out SERCOM5 definitions in arduinoCore-samd/variant/arduino-zero/variant.cpp
// see https://learn.adafruit.com/using-atsamd21-sercom-to-add-more-spi-i2c-serial-ports/muxing-it-up
// section: SERCOM 5
/****************************************************************/

// RX pin 6, TX pin A5, configuring for rover to GPS UART
Uart Serial3 (&sercom5, 6, A5, SERCOM_RX_PAD_2, UART_TX_PAD_0);
void SERCOM5_Handler()
{
  Serial3.IrqHandler();
}

// ========= Declare Variables ==============

int transmitBufLen; // length of transmit buffer
const int ID = 100; // id unique to device
String RTC_monthString, RTC_dayString, RTC_hrString, RTC_minString, RTC_timeString = "", stringTransmit = "";

// Declare RTC/Accelerometer specific variables
volatile bool TakeSampleFlag = false; // Flag is set with external Pin A0 Interrupt by RTC
volatile bool alertFlag = false;      // Flag if an alert is triggered and we need to speed up some processes (Phase 2)
volatile bool accelEnFlag = false;
volatile bool TimerFlag = false;
volatile bool RTCFlag = false;

volatile int HR = 8;        // Hr of the day we want alarm to go off
volatile int MIN = 0;       // Min of each hour we want alarm to go off
volatile int count = 10;    // number of seconds to wait before running loop()
volatile int awakeFor = 20; // number of seconds to stay awake and take measurements for

char buffr[10*RH_RF95_MAX_MESSAGE_LEN];
int avail;
int buffer_len;


unsigned long timer;  // time (in ms) interrupt was triggered
unsigned long accel_timer;
uint8_t dataRead;     // for acceleromter interrupt register
float measuredvbat;


// RTK and serial variables
uint8_t RTKString[RH_RF95_MAX_MESSAGE_LEN]; // string for reading RTK data
uint8_t len;

struct loraString input_string;
struct loraString last_string;
struct loraString accel_string;

unsigned long bytes_recvd, message_timer, buff_len, psti30_timer, psti32_timer, alert_timer, temp_timer;

char nmeaChar;
bool lastUpdated;
bool alertOff;
bool accelEn;

/**********************************************************************************************
   wakeUp_()
   Description: function that takes place after device wakes up
   See: Interrupt Service Routine (ISR)
   wakeUp_alert
   - sets SampleFlag and alertFlag TRUE;
   wakeUp_RTC
   - sets SampleFlag TRUE upon typical wakeup
**********************************************************************************************/
void wakeUp_alert()
{
  alertFlag = true;
  TakeSampleFlag = true;
  TimerFlag = true;
  myIMU.readRegister(&dataRead, LIS3DH_INT1_SRC);//cleared by reading
}

void wakeUp_RTC()
{
  detachInterrupt(digitalPinToInterrupt(RTC_WAKE_PIN));
  TimerFlag = true;
  RTCFlag = true;
}

//no need to detach interrupt because interrupt is rising/falling and will only be triggered when not in standby
void accel_toggle(){
  accelEnFlag = true;
}
/**********************************************************************************************
   setup()
   States: setup
   Preconditions: custom settings saved as global variables; takes place after a reset or power on
   Postcondition: alarmFlag set low; alertFlag set low
   Description:
        - begin serial
        - assign pinmodes/write to pins
        - assign IMU settings (LIS3DH), init, and configure IMU
        - (add GPS set up)
        - initialize DS3231 (if RTC mode on)
        - init LoRa/reliable datagram and set freq
**********************************************************************************************/

void setup() {
  //setup code here, to run once:
  // Open the main serial port to communicate with the computer
  Serial.begin(115200);

  // pins 13(rx), 10(tx) 
  Serial2_setup();

  // pins 6(rx), A5(tx)
  Serial3_setup();

  // lora pinmodes and manager initialization
  // pins 8, 4, 3
  lora_setup();
  
  set_globals();

#if DEBUG
  setupPrint(); //give the device time to wake up and upload sketch if necessary
#else
  // when not in debug mode, dont wait for serial to start code segment
  //   15s for sketch upload
  delay(15000);
#endif //DEBUG == 1
  
#if DEBUG == 1
  Serial.println("Processor Setup Successful.\n");
#endif

  initializeAcceleromter();
  
  /*initialize RTC*/
#if RTC_MODE == 1
  //RTC stuff init//
#if DEBUG == 1
  Serial.println("Setting up RTC");
#endif
  initializeRTC();

#if DEBUG == 1
  Serial.print("Alarm set to go off every ");
  Serial.print(RTC_WAKE_PERIOD);
  Serial.println(" min from program time");
#endif

#endif //RTC_MODE == 1


  timer = millis();
  temp_timer = timer;
  alert_timer = timer;
  /*initialize accelerometer and configure settings*/

  initializePins();

  accelEn = digitalRead(ACCEL_EN_PIN);
  accelInt(accelEn);
  gps_off();
}

void loop() {

  timerFlagCheck(); // set the timer each time an interrupt is triggered, prolong the wake period
  RTCFlagCheck();   // reset RTC interrupts
  enCheck();
  alertFlagCheck(); // reset accelerometer interrupts, 
                    // for some reason RTC flag is triggering every time device is woken from standby,
                    // shouldn't be an issue, I'm in a timecrunch now, plan to debug later



  //when passing recv, len is max message size, then updated to size of meassage received
  len = RH_RF95_MAX_MESSAGE_LEN;
  message_timer = millis();
  if (message_timer - alert_timer < 1000 * ACCEL_SAMPLE_PERIOD) {
    readNMEA();         // BOTTLENECK: block until lora is received or TIMEOUT occurs
    sampleSendAccel();  // read the accelerometer registers and send to waiting base (3 retries if base can't be reached)
  }
  else {
    readNMEA(); // BOTTLENECK: block until lora is received or TIMEOUT occurs
    recvLORA(); // non-blocking, reads a single lora string
  }

  if(message_timer - accel_timer > 200){
    accel_timer = millis();
    Serial.println(buildAccelString());
  }

  //this is the standby loop, always execute last in order
  //check the timer against millis() and sleep if difference is greater than "awakeFor"
  tryStandby();
}

/**********************************************************************************************
   Helper Functions - configInterrupts, initializeRTC, setRTCAlarm, clearRTCAlarm
**********************************************************************************************/

/******************
  Accelerometer
******************/
/* More info about listed data registers on the LISH3DH datasheet: */
/* http://www.st.com/content/ccc/resource/technical/document/datasheet/3c/ae/50/85/d6/b1/46/fe/CD00274221.pdf/files/CD00274221.pdf/jcr:content/translations/en.CD0027422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 */

/* Function: configInterrupts
   Use: set the necessary registers on a sparkfun LIS3DH accelerometer to send
        an interrupt signal from I1
   Precondoitions: Device is initialized using I2C constructor
   Description:
   Interrupt support for the LIS3DH is extremely flexible, so configuration must be left
   to the user.  This sketch demonstrates how to make a interrupt configuration function.

   Use configIntterupts() as a template, then comment/uncomment desired options.
*/

void configInterrupts()
{
  //uint8_t dataToWrite = 0;
  int x = 0;
  //LIS3DH_INT1_CFG
  //dataToWrite |= 0x80;//AOI, 0 = OR 1 = AND
  //dataToWrite |= 0x40;//6D, 0 = interrupt source, 1 = 6 direction source
  //Set these to enable individual axes of generation source (or direction)
  // -- high and low are used generically
  //dataToWrite |= 0x20;//Z high
  //dataToWrite |= 0x10;//Z low
  //dataToWrite |= 0x08;//Y high
  //dataToWrite |= 0x04;//Y low
  //dataToWrite |= 0x02;//X high
  //dataToWrite |= 0x01;//X low
  myIMU.writeRegister(LIS3DH_INT1_CFG, 0x5F);
  Serial.println(x++);

  //LIS3DH_INT1_THS
  //dataToWrite = 0;
  //Provide 7 bit value, 0x7F always equals max range by accelRange setting
  //dataToWrite |= 0x10; //0x10 -> 1/8 range
  myIMU.writeRegister(LIS3DH_INT1_THS, 0x01);
  Serial.println(x++);
  
  //LIS3DH_INT1_DURATION
  //dataToWrite = 0;
  //minimum duration of the interrupt
  //LSB equals 1/(sample rate)
  //dataToWrite |= 0x01; // 1 * 1/100 s = 10ms
  myIMU.writeRegister(LIS3DH_INT1_DURATION, 0x01);
  Serial.println(x++);
  
  //LIS3DH_CLICK_CFG
  //dataToWrite = 0;
  //Set these to enable individual axes of generation source (or direction)
  // -- set = 1 to enable
  //dataToWrite |= 0x20;//Z double-click
  //dataToWrite |= 0x10;//Z click
  //dataToWrite |= 0x08;//Y double-click
  //dataToWrite |= 0x04;//Y click
  //dataToWrite |= 0x02;//X double-click
  //dataToWrite |= 0x01;//X click
  myIMU.writeRegister(LIS3DH_CLICK_CFG, 0x15);
  Serial.println(x++);
  
  //LIS3DH_CLICK_SRC
  //dataToWrite = 0;
  //Set these to enable click behaviors (also read to check status)
  // -- set = 1 to enable
  //dataToWrite |= 0x20;//Enable double clicks
  //dataToWrite |= 0x04;//Enable single clicks
  //dataToWrite |= 0x08;//sine (0 is positive, 1 is negative)
  //dataToWrite |= 0x04;//Z click detect enabled
  //dataToWrite |= 0x02;//Y click detect enabled
  //dataToWrite |= 0x01;//X click detect enabled
  myIMU.writeRegister(LIS3DH_CLICK_SRC, 0x07);
  Serial.println(x++);
  
  //LIS3DH_CLICK_THS
  //dataToWrite = 0;
  //This sets the threshold where the click detection process is activated.
  //dataToWrite = 0x80 //keep interrupt high for duration of latency window
  //Provide 7 bit value, 0x7F always equals max range by accelRange setting
  //dataToWrite |= 0x0A; // ~1/16 range
  myIMU.writeRegister(LIS3DH_CLICK_THS, 0x30);
  Serial.println(x++);
  
  //LIS3DH_TIME_LIMIT
  //dataToWrite = 0;
  //Time acceleration has to fall below threshold for a valid click.
  //LSB equals 1/(sample rate)
  //dataToWrite |= 0x08; // 8 * 1/50 s = 160ms
  myIMU.writeRegister(LIS3DH_TIME_LIMIT, 0x08);
  Serial.println(x++);
  
  //LIS3DH_TIME_LATENCY
  //dataToWrite = 0;
  //hold-off time before allowing detection after click event
  //1 LSB equals 1/(sample rate)
  //dataToWrite |= 0x01; // 1 * 1/100 s = 10ms
  myIMU.writeRegister(LIS3DH_TIME_LATENCY, 0x10);
  Serial.println(x++);
  
  //LIS3DH_TIME_WINDOW
  //dataToWrite = 0;
  //hold-off time before allowing detection after click event
  //LSB equals 1/(sample rate)
  //dataToWrite |= 0x10; // 16 * 1/100 s = 160ms
  myIMU.writeRegister(LIS3DH_TIME_WINDOW, 0x10);
  Serial.println(x++);
  
  //LIS3DH_CTRL_REG1
  //dataToWrite |= 0x20;// most significant nibble controls data rate, 2 = 10Hz
  //dataToWrite |= 0x08;//Low power enable
  //dataToWrite |= 0x04;//Z enable
  //dataToWrite |= 0x02;//Y enable
  //dataToWrite |= 0x01;//X enable

  myIMU.writeRegister(LIS3DH_CTRL_REG1, 0x97); //disable low power 
  
  //LIS3DH_CTRL_REG4 
  //all default values 00
  //dataToWrite |= 0x08;//enable HI RESOLUTION mode
  myIMU.writeRegister(LIS3DH_CTRL_REG4, 0x08); //enable high resolution reads


  //LIS3DH_CTRL_REG3
  //Choose source for pin 1
  //dataToWrite = 0;
  //dataToWrite |= 0x80; //Click detect on pin 1
  //dataToWrite |= 0x40; //AOI1 event (Generator 1 interrupt on pin 1)
  //dataToWrite |= 0x20; //AOI2 event ()
  //dataToWrite |= 0x10; //Data ready
  //dataToWrite |= 0x04; //FIFO watermark
  //dataToWrite |= 0x02; //FIFO overrun
  myIMU.writeRegister(LIS3DH_CTRL_REG3, 0xC0);
  Serial.println(x++);
  
  //LIS3DH_CTRL_REG4
  //dataToWrite = 0;
  //dataToWrite |= 0x80; //Block Data Update - Default 0
  //dataToWrite |= 0x40; //Big/Little endian selection
  //dataToWrite |= 0x20; //Full Scale selection
  //dataToWrite |= 0x10; //Full Scale selection
  //dataToWrite |= 0x08; //High Resolution measurement mode
  //dataToWrite |= 0x04; //Self test enable
  //dataToWrite |= 0x02; //Self Test enable
  //dataToWrite |= 0x01; //SPI serial mode selection
  myIMU.writeRegister(LIS3DH_CTRL_REG4, 0x08);
  Serial.println(x++);
  
  //LIS3DH_CTRL_REG5
  //Int1 latch interrupt and 4D on  int1 (preserve fifo en)
  //myIMU.readRegister(&dataToWrite, LIS3DH_CTRL_REG5);
  //dataToWrite &= 0xF3; //Clear bits of interest
  //dataToWrite |= 0x08; //Latch interrupt (Cleared by reading int1_src)
  //dataToWrite |= 0x04; //Pipe 4D detection from 6D recognition to int1?
  myIMU.writeRegister(LIS3DH_CTRL_REG5, 0x08);
  Serial.println(x++);
  
  //LIS3DH_CTRL_REG6
  //Choose source for pin 2 and both pin output inversion state
  //dataToWrite = 0;
  //dataToWrite |= 0x80; //Click int on pin 2
  //dataToWrite |= 0x40; //Generator 1 interrupt on pin 2
  //dataToWrite |= 0x10; //boot status on pin 2
  //dataToWrite |= 0x02; //invert both outputs
  myIMU.writeRegister(LIS3DH_CTRL_REG6, 0xC2); //C0 cends HIGH interrupt, C2 sends low interrupt
  Serial.println(x++);
  
}

void initializeAcceleromter(){
    //Accel sample rate and range effect interrupt time and threshold values with device freq.
    myIMU.settings.accelSampleRate = 100;  // Hz.  Can be: 0,1,10,25,50,100,200,400,1600,5000 Hz
    myIMU.settings.accelRange = 2;         // Max G force readable.  Can be: 2, 4, 8, 16
    myIMU.settings.adcEnabled = 0;
    myIMU.settings.tempEnabled = 0;
    myIMU.settings.xAccelEnabled = 1;
    myIMU.settings.yAccelEnabled = 1;
    myIMU.settings.zAccelEnabled = 1;
    Serial.println("Accel Functional");
    //Call .begin() to configure the IMU
    myIMU.begin();
    configInterrupts();
  
    myIMU.readRegister(&dataRead, LIS3DH_INT1_SRC);//cleared by reading

}

void initializePins(){
    pinMode(RTC_WAKE_PIN, INPUT_PULLUP);  // pull up resistors required for Active-Low interrupts
    pinMode(ALERT_WAKE_PIN, INPUT_PULLUP);
    pinMode(ACCEL_EN_PIN, INPUT_PULLUP); //connect to pull down switch
    pinMode(GPS_EN_PIN, OUTPUT);
    digitalWrite(GPS_EN_PIN, LOW);
    pinMode(GPS_DISABLE_PIN, OUTPUT);
    digitalWrite(GPS_DISABLE_PIN, LOW);
}

/******************
  RTC Subroutines
******************/

void initializeRTC()
{
  // RTC Timer settings here
  if (! RTC_DS.begin()) {
#if DEBUG == 1
    Serial.println("Couldn't find RTC");
#endif
    while (1);
  }
  // This may end up causing a problem in practice - what if RTC looses power in field? Shouldn't happen with coin cell batt backup
  if (RTC_DS.lostPower()) {
#if DEBUG == 1
    Serial.println("RTC lost power, lets set the time!");
#endif
    // following line sets the RTC to the date & time this sketch was compiled
    RTC_DS.adjust(DateTime(F(__DATE__), F(__TIME__)));
  }
  //clear any pending alarms
  clearRTCAlarm();

  // Query Time and print
  DateTime now = RTC_DS.now();

  //Set SQW pin to OFF (in my case it was set by default to 1Hz)
  //The output of the DS3231 INT pin is connected to this pin
  //It must be connected to arduino Interrupt pin for wake-up
  RTC_DS.writeSqwPinMode(DS3231_OFF);

  //Set alarm1
  setRTCAlarm();
}


/* RTC helper function */
/* Function to query current RTC time and add the period to set next alarm cycle */
void setRTCAlarm()
{
  DateTime now = RTC_DS.now(); // Check the current time
  // Calculate new time
  MIN = (now.minute() + RTC_WAKE_PERIOD) % 60; // wrap-around using modulo every 60 sec
  HR  = (now.hour() + ((now.minute() + RTC_WAKE_PERIOD) / 60)) % 24; // quotient of now.min+periodMin added to now.hr, wraparound every 24hrs
#if DEBUG == 1
  Serial.print("RTC Time is: ");
  Serial.print(now.hour(), DEC); Serial.print(':'); Serial.print(now.minute(), DEC); Serial.print(':'); Serial.println(now.second(), DEC);
  Serial.print("Resetting Alarm 1 for: "); Serial.print(HR); Serial.print(":"); Serial.println(MIN);
#endif

  //Set alarm1
  RTC_DS.setAlarm(ALM1_MATCH_HOURS, MIN, HR, 0);   //set your wake-up time here
  RTC_DS.alarmInterrupt(1, true);  //code to pull microprocessor out of sleep is tied to the time -> here
}


/* RTC helper function */
/* When exiting the sleep mode we clear the alarm */
void clearRTCAlarm()
{
  //clear any pending alarms
  RTC_DS.armAlarm(1, false);
  RTC_DS.clearAlarm(1);
  RTC_DS.alarmInterrupt(1, false);
  RTC_DS.armAlarm(2, false);
  RTC_DS.clearAlarm(2);
  RTC_DS.alarmInterrupt(2, false);
  //opens up RTC to interrupts again
  //uint8_t dataRead;
  //myIMU.readRegister(&dataRead, LIS3DH_INT1_SRC);//cleared by reading
}

/* Debugging and upload helper,
   Allow uploads by waiting for serial monitor to open,
   prevent device from going to standby too soon
*/

void setupPrint()
{
  while (!Serial);    //Won't start anything until serial is open, comment these lines out if powering from battery
  Serial.println("***** Interrupt Test *****");

  // Delay is required to allow the USB interface to be active during
  // sketch upload process

  Serial.println("Entering test mode in:");
  for (count; count > 0; count--)
  {
    Serial.print(count);
    Serial.println(" s");
    delay(1000);
  }
}

void interruptReset() {
  detachInterrupt(digitalPinToInterrupt(ALERT_WAKE_PIN));
  detachInterrupt(digitalPinToInterrupt(RTC_WAKE_PIN));
  delay(20);
  attachInterrupt(digitalPinToInterrupt(ALERT_WAKE_PIN), wakeUp_alert, LOW);
  attachInterrupt(digitalPinToInterrupt(RTC_WAKE_PIN), wakeUp_RTC, LOW);
}

void timerFlagCheck() {
  if (TimerFlag) { //triggered with every wake-up interrupt

    //**************** IMPORTANT, DO NOT EDIT INTERRUPT ISRs ****************
    //clear interrupt registers, attach interrupts EVERY TIME THE INTERRUPT IS CALLED
    interruptReset();

    timer = millis();
    TimerFlag = false;
  }
}

void RTCFlagCheck() {
  if (RTCFlag) {
    clearRTCAlarm();
    Serial.println("Processor wake from RTC");
    DateTime now = RTC_DS.now();
    uint8_t mo = now.month();
    uint8_t d = now.day();
    uint8_t h = now.hour();
    uint8_t mm = now.minute();

    RTC_monthString = String(mo, DEC);
    RTC_dayString = String(d, DEC);
    RTC_hrString = String(h, DEC);
    RTC_minString = String(mm, DEC);
    RTC_timeString = RTC_hrString + ":" + RTC_minString + "_" + RTC_monthString + "/" + RTC_dayString;

#if DEBUG == 1
    Serial.println(RTC_timeString);
#endif
    RTCFlag = false;
    awakeFor = STANDARD_WAKE;
  }
}

void alertFlagCheck() {
  if (alertFlag && accelEn) {
    Serial.println("Processor wake from accelerometer");
    alertFlag = false;
    alert_timer = millis();
    awakeFor = ALERT_WAKE;
  }
  if(alertFlag){
      alertFlag = false;
      RTCFlag = false;
  }
}

void enCheck(){
    if(accelEnFlag){
        detachInterrupt(digitalPinToInterrupt(ACCEL_EN_PIN));
        accelInt(digitalRead(ACCEL_EN_PIN));
        Serial.println("Enable switch interrupt activated");
        accelEnFlag = false;
    }
}

void resetFlags() {
  TimerFlag = false;
  alertFlag = false;
  TakeSampleFlag = false;
}

void tryStandby() {
  if (millis() - timer > 1000 * awakeFor) { //delay, then sleep
    //reset all flags
    resetFlags();

    Serial.println("STANDBY");
    setRTCAlarm(); //reset alarm to go off one wake period from sleeping
    Serial.end();
    USBDevice.detach();
    interruptReset(); //clear interrupt registers, attach interrupts
#if DEBUG == 1
    //digitalWrite(LED_BUILTIN, LOW);
#endif
    gps_off();
    LowPower.standby();
    USBDevice.attach();
    gps_on();
#if DEBUG == 1
    //digitalWrite(LED_BUILTIN, HIGH);
    delay(5000); // give user 5s to close and reopen serial monitor!
#endif
    clearRTCAlarm(); //prevent double trigger of alarm interrupt
    Serial.begin(115200);
    Serial.println("WAKE");
  }
}



/*****************************************************
  read nmea data from serial port 3 when there is no lora transmission to receive
  will send NMEA to base if particular string has been read
*****************************************************/
void readNMEA() {
  while (!rf95.available()) {
    while (Serial3.available()) { //read from serial
      nmeaChar = Serial3.read();
      loadNmeaString(&input_string, &last_string, nmeaChar, &lastUpdated);
      if (lastUpdated) {
        unsigned long int current_time = millis();
        if (current_time - psti30_timer > 10000) {
          if (trySend30(last_string)) {
            psti30_timer = millis();
          }
        }
        lastUpdated = false;
      }
    }
    if (millis() - message_timer > TIMEOUT) {
      break;
    }
  }
}

/*****************************************************
  receive transmission from lora and write it to the serial port
  need to rewrite with RHRelibleDatagram so only messages from base written to serial port
*****************************************************/
void recvLORA() {
  temp_timer = millis();
  avail = 10*RH_RF95_MAX_MESSAGE_LEN-1;
  buffer_len = 0;
  while (millis() - temp_timer < 50) {
    if(rf95.available()){
      avail = 10 * RH_RF95_MAX_MESSAGE_LEN - buffer_len;
      len = (avail > RH_RF95_MAX_MESSAGE_LEN) ? RH_RF95_MAX_MESSAGE_LEN: avail;
      Serial.print("available length: ");
      Serial.println(len);
      if (rf95.recv((uint8_t*)&(buffr[buffer_len]), &len)) {
        bytes_recvd += len; //total received ever
        //copyString(&(buffr[buffer_len]), (char*)RTKString, avail, len);
        buffer_len += len;    //total received in a chunk
        avail -= len;
        temp_timer = millis();
#if DEBUG
//        Serial.println();
//        Serial.print("RSSI: ");
//        Serial.println(rf95.lastRssi(), DEC); // prints RSSI as decimal value
//        Serial.println();
#endif
      }
      else //happens when there is a receiver but bad message
      {
        Serial.println("Receive failed");
      }
    }
    if (!rf95.available()) //happens when there is no receiver on the same freq to listen to
    {
      //Serial.println("BAD RECEIPT");
//        #if DEBUG
//          Serial.println("No reply, is there a listener around?");
//        #endif
    }
  }
  if (buffer_len > 0) {
    Serial2.write(buffr, buffer_len);
  }
}

//void recvLORA(){
//  uint8_t rec_from;
//  uint8_t rec_to;
//  uint8_t rec_id;
//  uint8_t flags;
//  if (manager.available()) {
//    if (manager.recvfromACK(RTKString, &len, &rec_from, &rec_to, &rec_id, &flags)) {
//      bytes_recvd += len;
//      if(rec_from == RTK_SERVER){
//        Serial2.write(RTKString, len);
//        #if DEBUG
//        Serial.println();
//        Serial.print("RSSI: ");
//        Serial.println(rf95.lastRssi(), DEC); // prints RSSI as decimal value
//        Serial.println();
//        for (int j = 0; j < len; j++) {
//                if(RTKString[j] == 0xA0 && RTKString[j+1] == 0xA1){
//                    Serial.println();
//                    Serial.print("Buff Len: ");
//                    Serial.println(buff_len - 7);
//                    buff_len = 0;
//                }
//                buff_len++;
//                Serial.print(RTKString[j], HEX);
//                Serial.print(",");
//        }
//        #endif
//      }
//    }
//    else //happens when there is a receiver but bad message
//    {
//      Serial.println("Receive failed");
//    }
//  }
//  else //happens when there is no receiver on the same freq to listen to
//  {
//#if DEBUG
//    //Serial.println("No reply, is there a listener around?");
//#endif
//  }
//}

/*****************************************************
  load next character into loraString struct
  write new string to last_string struct if input_string is complete
*****************************************************/

void loadNmeaString(struct loraString* input_string, struct loraString* last_string, char nmeaChar, bool* lastUpdated) {
  if (nmeaChar == '$' || input_string->len >= 100) {
    for (int i = 0; i < input_string->len; i++) {
      last_string->data[i] = input_string->data[i];
    }
    last_string->len = input_string->len;
    input_string->len = 0;
    *lastUpdated = true;
  }
  input_string->data[input_string->len] = nmeaChar;
  input_string->len += 1;
}

void sampleSendAccel() {
  char lora_send[40];
  int temp_length = 40;
  String accel_out = buildAccelString();
  //    accel_out.toCharArray(lora_send, temp_length);
  manager.sendtoWait((uint8_t*) accel_out.c_str(), accel_out.length()+1, LORA_HUB_ADDRESS);
  //
}

String buildAccelString(){
  String accel_out = "";
  accel_out += "X,";
  accel_out += String(myIMU.readFloatAccelX(), 4);
  accel_out += ",Y,";
  accel_out += String(myIMU.readFloatAccelY(), 4);
  accel_out += ",Z,";
  accel_out += String(myIMU.readFloatAccelZ(), 4);
  return accel_out;
}

/*****************************************************
  send the newest nmea string for type PSTI 30
  string is minimal 3D GPS fix info
*****************************************************/

bool trySend30(struct loraString last_string) {
  if (!strncmp(last_string.data, "$PSTI,030", 9)) {
    if (manager.sendtoWait((uint8_t*)last_string.data, last_string.len, LORA_HUB_ADDRESS)) {
      Serial.print("Sent bundle through LoRa!\nData: ");
      Serial.write(last_string.data, last_string.len);
      return 1;
    }
    else {
      Serial.print("Failed to send bundle!\nData: ");
      Serial.write(last_string.data, last_string.len);
      return 0;
    }
  }
  return 0;
}


/*****************************************************
  send the newest nmea string for type PSTI 32
  string is RTK information
*****************************************************/

bool trySend32(struct loraString last_string) {
  if (!strncmp(last_string.data, "$PSTI,032", 9)) {
    if (manager.sendtoWait((uint8_t*)last_string.data, last_string.len, LORA_HUB_ADDRESS)) {
      Serial.print("Sent bundle through LoRa!\nData: ");
      Serial.write(last_string.data, last_string.len);
      return 1;
    }
    else {
      Serial.print("Failed to send bundle!\nData: ");
      Serial.write(last_string.data, last_string.len);
      return 0;
    }
  }
  return 0;
}

void Serial2_setup() {
  Serial2.begin(56700);           //rx on rover to pin 10
  // Assign pins 10 & 13 SERCOM functionality, internal function
  pinPeripheral(10, PIO_SERCOM);  //Private functions for serial communication
  pinPeripheral(13, PIO_SERCOM);
}

void Serial3_setup() {
  Serial3.begin(115200);          //tx from rover to pin 6

  // Assign pins 6 & A5 SERCOM functionality, internal function
  pinPeripheral(6, PIO_SERCOM);  //Private functions for serial communication
  pinPeripheral(A5, PIO_SERCOM_ALT);
}

void lora_setup() {
  pinMode(RFM95_RST, OUTPUT);
  digitalWrite(RFM95_RST, HIGH);

  /*manually reset LoRa*/
  digitalWrite(RFM95_RST, LOW);
  delay(10);
  digitalWrite(RFM95_RST, HIGH);
  delay(10);

  /*check LoRa device and set frequency*/
  while (!manager.init()) {
#if DEBUG == 1
    Serial.println("LoRa manager init failed"); //if print wiring may be wrong
#endif
    while (1);
  }
#if DEBUG == 1
  Serial.println("LoRa radio init OK!");
#endif
  // checks if frequency is initialized
  // Defaults after init are 434.0MHz, modulation GFSK_Rb250Fd250, +13dbM
  if (!rf95.setFrequency(RF95_FREQ)) {
#if DEBUG == 1
    Serial.println("setFrequency failed");
#endif
    while (1);
  }
#if DEBUG == 1
  Serial.print("Set Freq to: ");
  Serial.println(RF95_FREQ);
#endif

  // Defaults after init are 434.0MHz, 13dBm, Bw = 125 kHz, Cr = 4/5, Sf = 128chips / symbol, CRC on
  // The default transmitter power is 13dBm, using PA_BOOST.
  // If you are using RFM95/96/97/98 modules which uses the PA_BOOST transmitter pin, then
  // you can set transmitter powers from 5 to 20 dBm:
  rf95.setTxPower(20, false);

  //Enum constant for setting bit rate options, constant configured for high bitrate, short range
  rf95.setModemConfig(RH_RF95::Bw500Cr45Sf128);
}

void set_globals() {
  bytes_recvd = 0;
  psti30_timer = millis();
  psti32_timer = millis();
  input_string.len = 0;
  last_string.len = 0;
  lastUpdated = false;
}

//copy characters from s2 into buffer at s1
int copyString(char* s1, char* s2, int s1_avail, int s2_len) {
  int len;
  if (s2_len > s1_avail) {
    len = s1_avail;
  }
  else {
    len = s2_len;
  }
  for (int i = 0; i < len; i++) {
    s1[i] = s2[i];
  }
}

void accelInt(bool switch_state){
    detachInterrupt(digitalPinToInterrupt(ACCEL_EN_PIN));
    delay(10);
    if(switch_state){
        attachInterrupt(digitalPinToInterrupt(ACCEL_EN_PIN), accel_toggle, FALLING);
        #if DEBUG
        Serial.println("Switch on, interrupt falling");
        #endif
        accelEn = true;
        //interruptReset();
    }
    else{
        //detachInterrupt(digitalPinToInterrupt(ALERT_WAKE_PIN));
        attachInterrupt(digitalPinToInterrupt(ACCEL_EN_PIN), accel_toggle, RISING);
        #if DEBUG
        Serial.println("Switch off, interrupt rising");       
        #endif 
        accelEn = false;
    }  
}

// Turn the GPS module on (consumes ~150 mA)
void gps_on(){
    digitalWrite(GPS_EN_PIN, HIGH);
    delay(10);
    digitalWrite(GPS_EN_PIN, LOW);
}

// Turn off the gps module, save power during sleep
// Functions affect physical latch on feather relay
void gps_off(){
    digitalWrite(GPS_DISABLE_PIN, HIGH);
    delay(10);
    digitalWrite(GPS_DISABLE_PIN, LOW);
}
