OPEnSLab-OSU/SlideSentinel/Integration/SlideSentinel/libhw/Rover/rover_pcb_config.h

#pragma once

/****** ComController ******/
#define RST 6
#define CD 10
#define SPDT_SEL 14
#define FORCEOFF_N A5   //for rs232 translator chip

/****** PMController ******/
#define VCC2_EN 13
#define MAX_CS 9
#define BAT_PIN 15

/****** FSController ******/
#define SD_CS 18  				// A4
#define SD_RST 16 				// A2

/****** IMUController ******/
#define INIT_SENSITIVITY 0x10  	// uint8_t
#define ACCEL_INT A3

/****** GNSSController ******/
#define GNSS_BAUD 115200
#define INIT_LOG_FREQ 30000     // useconds
#define GNSS_TX 11
#define GNSS_RX 12

/****** RTCController ******/
#define RTC_INT 5
#define INIT_WAKETIME 10            // minutes
#define INIT_SLEEPTIME 15       	// minutes

/****** SatComm ******/
#define IRIDIUM_RX 13
#define IRIDIUM_TX 11
#define IRIDIUM_BAUD 19200
#define RING_PIN A3
#define NET_AV_PIN A5
#define SATCOMM_ONOFF 9
