OPEnSLab-OSU/SlideSentinel/NRF UART/NRF_rx/NRF_rx/NRF_rx.ino

/*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
 Update 2014 - TMRh20
 */
/**
 * Simplest possible example of using RF24Network,
 *
 * RECEIVER NODE
 * Listens for messages from the transmitter and prints them out.
 */
#include <RF24Network.h>
#include <RF24.h>
#include <SPI.h>
RF24 radio(5,6);                // nRF24L01(+) radio attached using Getting Started board 
RF24Network network(radio);      // Network uses that radio
const uint16_t this_node = 00;    // Address of our node in Octal format ( 04,031, etc)
const uint16_t other_node = 01;   // Address of the other node in Octal format
struct payload_t {                 // Structure of our payload
  unsigned long ms;
  unsigned long counter;
};
void setup(void)
{
  Serial.begin(57600);
  while(!Serial);
  Serial.println("RF24Network/examples/helloworld_rx/");
 
  SPI.begin();
  radio.begin();
  network.begin(/*channel*/ 90, /*node address*/ this_node);

  //pinMode(8, INPUT_PULLUP);
}
void loop(void){
  
  network.update();                  // Check the network regularly
  while ( network.available() ) {     // Is there anything ready for us?
    
    RF24NetworkHeader header;        // If so, grab it and print it out
    payload_t payload;
    network.read(header,&payload,sizeof(payload));
    Serial.print("Received packet #");
    Serial.print(payload.counter);
    Serial.print(" at ");
    Serial.println(payload.ms);
  }
}
