OPEnSLab-OSU/SlideSentinel/NRF UART/NRF_tx/NRF_tx/NRF_tx.ino

/*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
 Update 2014 - TMRh20
 */
/**
 * Simplest possible example of using RF24Network 
 *
 * TRANSMITTER NODE
 * Every 2 seconds, send a payload to the receiver node.
 */
#include <RF24Network.h>
#include <RF24.h>
#include <SPI.h>
RF24 radio(5,6);                    // nRF24L01(+) radio attached using Getting Started board 
RF24Network network(radio);          // Network uses that radio
const uint16_t this_node = 01;        // Address of our node in Octal format
const uint16_t other_node = 00;       // Address of the other node in Octal format
const unsigned long interval = 2000; //ms  // How often to send 'hello world to the other unit
unsigned long last_sent;             // When did we last send?
unsigned long packets_sent;          // How many have we sent already
struct payload_t {                  // Structure of our payload
unsigned long ms;
  unsigned long counter;
};
void setup(void)
{
  Serial.begin(57600);
  while(!Serial);
  Serial.println("RF24Network/examples/helloworld_tx/");
 
  SPI.begin();
  radio.begin();
  network.begin(/*channel*/ 90, /*node address*/ this_node);
  
  //pinMode(8, INPUT_PULLUP);
}
void loop() {
  
  network.update();                          // Check the network regularly
  
  unsigned long now = millis();              // If it's time to send a message, send it!
  if ( now - last_sent >= interval  )
  {
    last_sent = now;
    Serial.print("Sending...");
    payload_t payload = { millis(), packets_sent++ };
    RF24NetworkHeader header(/*to node*/ other_node);
    bool ok = network.write(header,&payload,sizeof(payload));
    if (ok)
      Serial.println("ok.");
    else
      Serial.println("failed.");

  }
}
