OPEnSLab-OSU/SlideSentinel/Integration/SlideSentinel/libhw/Base/Base.cpp

#include "Base.h"


/* Ran on first bootup of Main*/
Base::Base() : m_max4820(MAX_CS, &SPI),
               m_multiplexer(SPDT_SEL, -1),
               m_RadioManager(),
               m_sdManager(SD_CS),
               m_JSONData(1024){
    
    m_baseInfo.id = SERVER_ADDR;
    m_baseInfo.init_retries = INIT_RETRIES;
    m_baseInfo.timeout = INIT_TIMEOUT;
    m_baseInfo.radioBaud = RADIO_BAUD;
}

/**
 * Listen for a radio request from the Rover with data
 */ 
bool Base::waitAndReceive(int milliseconds){

        Serial.println("[Base] Waiting for data from rovers...");
        // Wait for a packet and if it is not received increase the dropped packet count
        if(!m_RadioManager.waitForPacket(milliseconds)){

            // Increase the dropped packet count by one
            m_baseDiagnostics.setDroppedPkts(m_baseDiagnostics.droppedPkts() + 1);
            Serial.println("[Base] Packet was not received in the expected interval!");
            return false;
        }
        else{
            Serial.println("[Base] Packet Received!");
        }
        return m_RadioManager.readHeader();
}

/**
 * Initialize all aspects of the base, currently checks the sd if it's been initialized
 */ 
bool Base::initBase(){

    // Attempt to initialize the SD card
    if(!m_sdManager.initSD()){
        return false;
    }

    // Switch the mux to communicate with the radio
    setMux(RadioToFeather);

    // Initialize the radio
    if(!m_RadioManager.initRadio()) return false;
    
    #if SATCOMM_ENABLED == true
        // Initialize the SatComm driver
        if(!m_satComm.initSatComm()) return false;
        
        // Wait for a satellite signal to be detected
        if(!m_satComm.waitForSignal()) return false;
    #endif
    
    return true;
}

/**
 * Package data into a Json document to send to the Rover
 */ 
void Base::packageData(DataType packType){
    JsonObject RHJson = m_JSONData.to<JsonObject>();

    switch(packType){
        case INIT_RTK:
            RHJson["TYPE"] = "INIT_RTK_TYPE";
            #if SATCOMM_ENABLED == true
                m_satComm.updateSystemTime();
                RHJson["MSG"] = m_satComm.getCurrentTimeString();
            #else
                RHJson["MSG"] = "";
            #endif

            break;
        case REQUEST: 
            RHJson["TYPE"] = "REQUEST";
            RHJson["MSG"] = "RTK_REQUEST";
            break;
        case UPLOAD:
            RHJson["TYPE"] = "UPLOAD";

            // Take the message in as an object to create a new GNSS data object
            // m_gnss.populateGNSSMessage(RHJson["MSG"].as<JsonObject>()); premerge 8/16
            RHJson["MSG"]= "PLACEHOLDER";
            break;
        case ALERT:
            RHJson["TYPE"] = "ALERT";
            RHJson["MSG"] = "UNSPECIFIED_ALERT";
            break;

    }
}

/**
 * Package data into a Json document using arbitrary type and message
 */ 
void Base::packageData(String type, String message){
    JsonObject RHJson = m_JSONData.to<JsonObject>();
    RHJson["TYPE"] = type;
    RHJson["MSG"] = message;
}


/**
 * Transmit the packaged data to the rover
 */ 
bool Base::transmit(){

    // Set the serial Mux to talk to the Radio
    setMux(RadioToFeather);
    delay(5);

    // Serialize the Json to string
    String processedRHMessage;
    serializeJson(m_JSONData, processedRHMessage);

    // Send the packet to the rover that just requested data
    return m_RadioManager.sendPacket(processedRHMessage, m_RadioManager.getMostRecentRover());
}

/**
 * Check if the SD card is initialized if not reinitialize it
 */ 
bool Base::checkSD(bool reinit){
    if(!m_sdManager.checkSD()){
        if(reinit){
            Serial.println("[Base] SD not initialized retrying...");
            
            // If that fails to initialze we return false
            if(!m_sdManager.initSD()){
                return false;
            }
        }
        return false;
    }
    return true;
}

bool Base::logToSD(){
    // Verify the SD card is connected first
    checkSD();

    // Log the message to a given rover
    return m_sdManager.logData(m_RadioManager.getMostRecentRover(), m_RadioManager.getRoverPacket()["MSG"].as<JsonObject>());

}

/**
 * Uploads the data from the base to the satellite
*/
bool Base::uploadToSatComm(){
   return m_satComm.transmit(m_RadioManager.getRoverPacket()["MSG"].as<JsonObject>());
}

/**
 * Reads bytes in from the Serial bus to print out requested data
 */ 
void Base::debugInformation(){

    // Check for user input on serial to request information about the base
    if(Serial.available()){
        char cmd = Serial.read();
        if(cmd == '1'){
            printDiagnostics();
        }
    }
}

/**
 * Print the base's diagnostic and just general information to the serial bus
 */ 
void Base::printDiagnostics(){

    //Print Basic Configuration Information
    Serial.println("\n**** Configuration ****");
    Serial.println("\tBase ID: " + String(m_baseInfo.id));
    Serial.println("\tRetry Count: " + String(m_baseInfo.init_retries));
    Serial.println("\tRadio Baud Rate: " + String(m_baseInfo.radioBaud));
    Serial.println("\n*************************");

    // Print out the diagnostics to serial
    m_baseDiagnostics.print_serial();
}


/**
 * Print out the most recent rover packet 
 */ 
void Base::printMostRecentPacket(){
    Serial.println("\n**** Rover Packet ****");
    Serial.println("Rover Addr: " + String(m_RadioManager.getMostRecentRover()));
    serializeJsonPretty(m_RadioManager.getRoverPacket(), Serial);
    Serial.println("\n*************************");
}

/** 
 * Returns the messages'type 
 * 
*/
String Base::getMessageType(){
    
    return m_RadioManager.getRoverPacket()["TYPE"];
}

/**
 * Power on the radio to transmit data
 */ 
void Base::powerRadio(){
    Serial.println("[Base] Powering radio on.");
    m_max4820.assertRail(0);
}

/**
 * Power down the radio to conserve energy
 */ 
void Base::powerDownRadio(){
    Serial.println("[Base] Powering radio down.");
    m_max4820.assertRail(1);
}

/**
 * Power up the GNSS board to get fixes 
 */ 
void Base::powerGNSS(){
    Serial.println("[Base] Powering GNSS on.");
    m_max4820.assertRail(2);
}

/**
 * Power down the GNSS board
 */ 
void Base::powerDownGNSS(){
    Serial.println("[Base] Powering GNSS down.");
    m_max4820.assertRail(3);
}

/**
 * Set the current path the multiplexer is using is it feather ot radio or RTC to Radio
 */ 
void Base::setMux(MuxFormat format){
    if(format == RadioToGNSS){
        m_multiplexer.comY1();          
    }else if(format == RadioToFeather){
        m_multiplexer.comY2();
    }
}

void Base::startFeatherTimer(){
    this->startTime = millis();
}

void Base::setFeatherTimerLength(int milliseconds){
    this->featherTimerLength = milliseconds;
}

bool Base::isFeatherTimerDone(){
    if((unsigned long)(millis() - this->startTime) >= this->featherTimerLength){ //calculate if current time exceeds the set timer 
        return true;
    }else{
        return false;
    }
}

void Base::waitForSerial(int timeout){
    long startMillis = millis();

    // Pause if the Serial is not open and we want to wait
    while(!Serial){
        // If it has been 20 seconds break out of the loop
        if(millis() >= (startMillis+timeout)){
            break;
        }
    }
};
