OPEnSLab-OSU/SlideSentinel/Integration/SlideSentinel/libhw/Rover/rover_config.h

#pragma once

// which power rail is the GNSS receiver on
#define GNSS_RAIL2 false

// which power rail is the GNSS receiver on
#define RADIO_RAIL2 true

// What type of radio is in the device, possible values of 0, 1, or 2 correspond to Z9-C, Z9-T, and GXM type respectively
#define RadioType 0

// Set if we need to level shift the serial for the RockBlock and the Radio
#define IS_RS232 true
