OPEnSLab-OSU/SlideSentinel/Integration/SlideSentinel/libhw/Rover/rover_network_config.h

#pragma once

#define CLIENT_ADDR 55 //debug to 0 if you want to simulate server     	// Node_ID
#define SERVER_ADDR 0
#define RADIO_BAUD 115200
#define INIT_TIMEOUT 2000      	// seconds
#define INIT_RETRIES 3        	// Default
