OPEnSLab-OSU/SlideSentinel/LOOM_HUB/loom_create_device_commands.h

// ================================================================
// ===                        LIBRARIES                         ===
// ================================================================


// ================================================================ 
// ===                       DEFINITIONS                        === 
// ================================================================ 


// ================================================================ 
// ===                        STRUCTURES                        === 
// ================================================================


// ================================================================ 
// ===                   GLOBAL DECLARATIONS                    === 
// ================================================================


// ================================================================ 
// ===                   FUNCTION PROTOTYPES                    === 
// ================================================================


// ================================================================ 
// ===                          SETUP                           === 
// ================================================================


// ================================================================ 
// ===                        FUNCTIONS                         === 
// ================================================================
