OPEnSLab-OSU/SlideSentinel/LOOM_HUB/loom_relay.h

// ================================================================
// ===                        LIBRARIES                         ===
// ================================================================


// ================================================================ 
// ===                       DEFINITIONS                        === 
// ================================================================
#define RELAY_PIN0 10
#define RELAY_PIN1 11


// ================================================================ 
// ===                        STRUCTURES                        === 
// ================================================================
struct state_relay_t {
	bool on[2]; // Array to hold relay states (on/off)
};


// ================================================================ 
// ===                   GLOBAL DECLARATIONS                    === 
// ================================================================
struct state_relay_t state_relay;


// ================================================================ 
// ===                   FUNCTION PROTOTYPES                    === 
// ================================================================
void setup_relay();
void handle_relay_msg(OSCMessage &msg);
void write_relay_states();


// ================================================================ 
// ===                          SETUP                           === 
// ================================================================
//
// Called by main setup
// Sets pin modes for relays (on pins 5 and 6)
// Initializes relays to off
// 
void setup_relay() 
{
	pinMode(RELAY_PIN0,OUTPUT);
	pinMode(RELAY_PIN1,OUTPUT);
	state_relay.on[0] = false;
	state_relay.on[1] = false;
}


// ================================================================ 
// ===                        FUNCTIONS                         === 
// ================================================================


// --- HANDLE RELAY MSG ---
//
// Updates stored state of relays, then calls write_relay_states()
// to set relays to those states
//
// @param msg  OSC message with data of state and relay to set 
//
void handle_relay_msg(OSCMessage &msg) 
{
	int relay  = msg.getInt(0);
	int set_to = msg.getInt(1);

	state_relay.on[relay] = (set_to == 1);
	
	LOOM_DEBUG_Print3("Set ", relay, " to "); 
	LOOM_DEBUG_Println((state_relay.on[relay]) ? "ON" : "OFF");

	write_relay_states();
}



// --- WRTIE RELAY STATES ---
//
// Writes current relay states to the physical relays
// Called after handle_relay_msg, which sets the variables holding the state values
// 
void write_relay_states()
{
	digitalWrite(RELAY_PIN0,(state_relay.on[0]==true) ? HIGH : LOW);
	digitalWrite(RELAY_PIN1,(state_relay.on[1]==true) ? HIGH : LOW);
}
