OPEnSLab-OSU/SlideSentinel/Integration/Hardware/rover/test/test.ino

#include <Arduino.h>
#include <SPI.h>
#include <Adafruit_MMA8451.h>
#include <RTClibExtended.h>
#include <wiring_private.h> // Pin peripheral
#include <RHReliableDatagram.h>
#include <RH_Serial.h>
#include <SD.h>

// Test Toggle
#define ADVANCED true

// RS232 Interface Pin Def
#define FORCEOFF_N A5

// RADIO INTERFACE
#define RST 6
#define CD 10
// COMMUNICATION OVER SERIAL1

// Switch Pin Def
#define SPDT_SEL A0

// Relay constants
#define CS_4280 9
#define GNSS_RESET 0x08
#define GNSS_SET 0x04
#define RADIO_RESET 0x02
#define RADIO_SET 0x01
#define CLEAR_RELAYS 0x00

// SD CARD CONSTANTS
#define SD_CS 18

// PMC REGULATOR
#define VCC2_EN 13

void useRelay(uint8_t word)
{
    digitalWrite(CS_4280, LOW);
    SPI.transfer(word);
    digitalWrite(CS_4280, HIGH);
    delay(200);
    digitalWrite(CS_4280, LOW);
    SPI.transfer(CLEAR_RELAYS);
    digitalWrite(CS_4280, HIGH);
}

// Instatiate ACCELEROMETER Object
#define ACCEL_INT A3
Adafruit_MMA8451 mma = Adafruit_MMA8451();

// Instatiate RTC Object
#define RTC_INT 5
RTC_DS3231 RTC_DS;
volatile int HR = 8; //  These should not be volatile
volatile int MIN = 0;
volatile int awakeFor = 20;
#define RTC_WAKE_PERIOD 1 // Interval to wake and take sample in Min, reset alarm based on this period (Bo - 5 min), 15 min

// Reliable Datagram
#define CLIENT_ADDRESS 1
#define SERVER_ADDRESS 2
RH_Serial driver(Serial1);
RHReliableDatagram manager(driver, CLIENT_ADDRESS);
uint8_t data[2];
uint8_t buf[RH_SERIAL_MAX_MESSAGE_LEN];

// GNSS Serial Init
#define SERIAL2_TX 11
#define SERIAL2_RX 12
#define GNSS_BAUD 115200
Uart Serial2(&sercom1, SERIAL2_RX, SERIAL2_TX, SERCOM_RX_PAD_3, UART_TX_PAD_0);
void SERCOM1_Handler()
{
    Serial2.IrqHandler();
}
void Serial2Setup(uint16_t baudrate)
{
    Serial2.begin(baudrate);
    // Assign pins 11,12 SERCOM functionality, internal function
    pinPeripheral(SERIAL2_TX, PIO_SERCOM); // Private functions for serial communication
    pinPeripheral(SERIAL2_RX, PIO_SERCOM);
}

void setup()
{
    Serial.begin(115200);
    while (!Serial)
        ;

    // SPI INIT
    SPI.begin();
    SPI.setClockDivider(SPI_CLOCK_DIV8);

    // RADIO INIT
    Serial1.begin(115200);
    pinMode(RST, OUTPUT);
    digitalWrite(RST, HIGH);
    pinMode(CD, INPUT);

    if (!manager.init())
        Serial.println("init failed");

    // Clear Relays on INIT
    useRelay(CLEAR_RELAYS);

    // RS232 INIT
    pinMode(FORCEOFF_N, OUTPUT);
    Serial.println("RS232 ---> ON (Driving it HIGH)");
    digitalWrite(FORCEOFF_N, HIGH);

    // SPDT INIT
    pinMode(SPDT_SEL, OUTPUT);
    digitalWrite(SPDT_SEL, LOW);

    // RELAY DRIVER INIT
    pinMode(CS_4280, OUTPUT);

    // ACCELEROMETER INIT
    Serial.println("Setting up MMA");
    digitalWrite(ACCEL_INT, INPUT_PULLUP);
    mmaSetupSlideSentinel();
    configInterrupts(mma);
    attachInterrupt(digitalPinToInterrupt(ACCEL_INT), accelInt, FALLING);
    mma.readRegister8(MMA8451_REG_TRANSIENT_SRC);

    // RTC INIT
    pinMode(RTC_INT, INPUT_PULLUP); //active low interrupts
    initializeRTC();

    // GNSS INIT
    Serial2Setup(GNSS_BAUD);

    // Set the XOSC32K to run in standby, external 32 KHz clock must be used for interrupt detection in order to catch falling edges
    SYSCTRL->XOSC32K.bit.RUNSTDBY = 1;

    // INIT EXTERNAL OSCILLATOR FOR RISING AND FALLING interrupts  // Configure EIC to use GCLK1 which uses XOSC32K
    // This has to be done after the first call to attachInterrupt()
    GCLK->CLKCTRL.reg = GCLK_CLKCTRL_ID(GCM_EIC) |
                        GCLK_CLKCTRL_GEN_GCLK1 |
                        GCLK_CLKCTRL_CLKEN;

    // SD Card Initialization
    pinMode(SD_CS, OUTPUT);
    setup_sd();

    // REGULATOR INIT
    pinMode(VCC2_EN, OUTPUT);
    digitalWrite(VCC2_EN, HIGH);
}

void loop()
{
    if (ADVANCED)
    {
        advancedTest();
    }
}
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
