OPEnSLab-OSU/SlideSentinel/Integration/Hardware/base/test/test.ino

#include <Arduino.h>
#include <SPI.h>
#include <wiring_private.h>
#include <RHReliableDatagram.h>
#include <RH_Serial.h>
#include <SD.h>

// RADIO INTERFACE
#define RST 5

// Switch Pin Def
#define SPDT_SEL A0

// Relay constants
#define GNSS_ON_PIN A2
#define GNSS_OFF_PIN 12

// SD CARD CONSTANTS
#define SD_CS 10

// PMC REGULATOR
#define VCC2_EN 21 //SCL

// Switch Pin Def
#define SPDT_SEL A0

// Radio Serial
#define ROCK_TX 11
#define ROCK_RX 12
#define ROCK_ONOFF 9
#define ROCK_NETAV A5
#define ROCK_RINGAL A3

// Reliable Datagram usage
#define CLIENT_ADDRESS 1
#define SERVER_ADDRESS 2
RH_Serial driver(Serial1);
RHReliableDatagram manager(driver, SERVER_ADDRESS);
uint8_t buf[RH_SERIAL_MAX_MESSAGE_LEN];
uint8_t data[] = "ACK";

#define IRIDIUM_BAUD 115200
Uart Serial2(&sercom1, ROCK_RX, ROCK_TX, SERCOM_RX_PAD_3, UART_TX_PAD_0);
void SERCOM1_Handler()
{
    Serial2.IrqHandler();
}

void Serial2Setup(uint16_t baudrate)
{
    Serial2.begin(baudrate);
    pinPeripheral(ROCK_TX, PIO_SERCOM); //Private functions for serial communication
    pinPeripheral(ROCK_RX, PIO_SERCOM);
}

void useRelay(uint8_t pin)
{
    digitalWrite(pin, HIGH);
    delay(4);
    digitalWrite(pin, LOW);
}

void setup()
{
    Serial.begin(115200);

    // Radio Serial
    Serial1.begin(115200);

    // Set up Reliable datagram socket
    if (!manager.init())
        Serial.println("init failed");

    // Iridium Serial
    Serial2Setup(IRIDIUM_BAUD);
    pinMode(ROCK_ONOFF, OUTPUT);
    pinMode(ROCK_NETAV, INPUT);
    pinMode(ROCK_RINGAL, INPUT);

    // setup SD
    pinMode(SD_CS, OUTPUT);
    setup_sd();

    // setup Relay
    pinMode(GNSS_ON_PIN, OUTPUT);
    pinMode(GNSS_OFF_PIN, OUTPUT);
    useRelay(GNSS_OFF_PIN);

    // SPDT INIT, Feather receives data
    pinMode(SPDT_SEL, OUTPUT);
    digitalWrite(SPDT_SEL, HIGH);

    // prevent radio reset
    pinMode(RST, OUTPUT);
    digitalWrite(RST, HIGH);

    pinMode(VCC2_EN, OUTPUT);
    digitalWrite(VCC2_EN, HIGH);
}
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
