OPEnSLab-OSU/SlideSentinel/(commit log)

2018-06-06 Working sensor code with regular wake/sleep cycles
    - still need to add accelerometer ISR
    - still need to test communication with LoRa base station
2018-06-06 Accelerometer code with click interrupts enabled
    Basic test code for accelerometer
2018-06-29 Changed interrupt pin from 13 to 12, added start delay for sketch upload
2018-07-02 Config_interrupts uses less data, pulls interrupt low on interrupt
2018-07-03 M0_interrupt file added, triggers interrupts via LIS3DH
2018-07-03 configure low power test for standby
2018-07-05 removed serial configuration in low power test, sleep-wake cycle functions
2018-07-05 P1_SS is functional! Device is working as expected
2018-07-12 LoopControl provides functioning interrupt configuration with resettable timer
    [P1_SS_Debug_LoopControl.ino]
2018-07-12 fully functional interrupt config
2018-08-07 Revert "Merge branch 'master' into ACC_test_Gray"
    This reverts commit bd914091fd81747ce80cd41bdcd7f8f26e34b2a8, reversing
    changes made to f92026331b5e7d50173b3b7096b479cdaca65383.
    [P1_SS_Debug.ino]
2018-08-08 Slimmed LoopControl, and RTK read/write
    [willmywirelesslinkwork.xls]
2018-08-20 added loom library code
    [willmywirelesslinkwork.xls]
2018-08-24 Edited pushingbox for base, add to buffers. Added switch ints for accel
2018-08-24 Reorganize pin assignment
2018-09-11 Demo update, RTC interrupt being weird
2018-09-17 simplifying configuration and current draw test
2018-11-01 Add functioning interrupt code and library
2018-11-01 Revert "Add functioning interrupt code and library"
    This reverts commit 7293f401c1f6dcdda3fce0888c62526f4254f850.
2018-11-01 Revert "Revert "Add functioning interrupt code and library""
    This reverts commit a4a390a7dc4994edfcadc5f276071546c8a4bde2.
2018-11-02 Interrupt detach within ISR added, read works
2018-11-02 Interrupt fully functional for use case
2018-11-02 Added interrupt print
2018-11-05 Testing configurations for interrupts
2018-11-08 Interrupts fully functioning
2018-11-16 Add GPS log file
    [willmywirelesslinkwork.xls]
2018-11-26 Test results added, tests promising
    [ACCEL11_16-11_19.xlsx, AC_TMP11_19.CSV]
2018-11-26 Matlab code and variables for test results
    [ACCEL11_16-11_19.csv]
2019-01-23 ROCKBLOCK+ interface configured, script for reading signal strength and writing hello world AT command in ROCKBLOCK device testing directory
2019-02-08 empty template spreadsheet used for demo and google script for parsing
    [spreadsheet.xlsx]
2019-02-18 string upload test for rockblock+ w/ feather wing, readme included with findings
2019-02-27 adding developments on hub script as well as PCB schematic and board
    [ROCKBLOCK_interface.brd, ROCKBLOCK_interface.sch]
2019-02-27 added bill of materials for interface
2019-02-27 added testing script to satcom device testing directory
2019-02-28 Add files for SLIP serial
    [config.h, loom_adafruit_io.h, loom_analogIn.h, loom_common_functions.h, loom_create_device_commands.h, loom_decagon.h, loom_ethernet.h, loom_flash.h]
2019-03-01 timer interrupts configured for the base. Rockblock on/off and network availibilty working
2019-03-04 difficulties integrating timers with UART
2019-03-06 add current version of node code
2019-03-21 filtering out uninitialized messages
2019-03-22 filtering bad messages
2019-03-24 Node is now accurately reading the battery voltage and sending the data in the state messages
2019-04-01 corrected battery voltage reading and reset wake times to 5 minutes
2019-04-02 change to battery voltage reading was incorrect
2019-04-07 refactored hub code, removed some loom flags which were preventing execution until serial was opened
    [config.h]
2019-04-09 spreadsheet code and snapshot submission
    [Extended Demonstration Spreadsheet - data.csv]
2019-04-14 added ring indicator interrupts and CRC verification to radio communication
2019-04-14 Adding EAGLE schematic for the node
    [NodeSchematic.sch]
2019-04-16 Add files via upload
    BOM added
    [WEYCO's BOM Phase 2.xlsx]
2019-04-18 final versions of documents with sig lines and short spring progress report
2019-04-19 schematics and readme build guide revision
2019-04-22 reorganized github structure, updates readmes, cleaned up unnecessary files, added project specifications in Documentation readme
    [NodeSchematic.sch, Rover.sch, spreadsheet.xlsx, willmywirelesslinkwork.xls]
2019-05-07 enabled accelerometer alert messages, added byte padding in between messages
2019-05-28 Added the stat Scripts
    [latDecimalTable.csv, latitude.csv, longDecimalTable.csv, longitude.csv, spacer no threads.stl, spacer threads.stl, timeLatLon.csv]
2019-07-11 moved UART3 functionality to UART1
2019-07-25 Added PCB files for Rover unit
    [roverPCB.brd, roverPCB.sch, roverPCB_simple.brd, roverPCB_simple.sch]
2019-08-16 Adding Modular GPS Receiver Test Scripts 1.0
    [latDecimalTable.csv, latitude.csv, longDecimalTable.csv, longitude.csv, spacer no threads.stl, spacer threads.stl, timeLatLon.csv]
2019-10-29 adding newest PCB
2019-11-20 adding PCB test scripts, demo scripts, and oo hardware
    [BasePCB.brd, BasePCB.sch, Rover.sch, roverPCB.brd, roverPCB.sch, roverPCB_simple.brd, roverPCB_simple.sch]
2019-12-03 restructured files
    [ACCEL11_16-11_19.csv, ACCEL11_16-11_19.xlsx, AC_TMP11_19.CSV, BasePCB.brd, BasePCB.sch, ROCKBLOCK_interface.brd, ROCKBLOCK_interface.sch, WEYCO's BOM Phase 2.xlsx]
2020-01-13 added classes for analog switch, radio, voltage regulator
2020-02-04 adding support for Swift Binary Protocol, currently constructing GNSS Controller class
2020-02-12 Created base class for controller objects, GNSSController can now populate JSON document, return true if data was successfully grabbed, GNSS controller has one updateable parameter, the logging frequ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
2020-02-14 GNSS Controller now updates best current positional value
2020-02-14 IMUController almost complete, ISR successfully wrapped under class
2020-02-16 successfully wrapped ISR in IMUController class, unfortunatley the interrupt pin cannot be passed and initialized through the constructor
2020-02-16 pin initialization now occuring in the IMUController's constructor
2020-02-18 cleaned up IMUController, ISR cleanly wrapped inside singleton class
2020-02-22 migrated Blake's RTCController to this branch to prevent merge conflicts, tuned up the RTCController API, added semantic versioning to the pcb files, added semantic versioning to the pin def config f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
    [base_2.0.0.brd, base_2.0.0.sch, rover_2.0.0.brd, rover_2.0.0.sch]
2020-02-26 adding namespace for error messages, beginning work on message class to move away from ArduinoJSON
2020-03-09 cleaned up status methods on SSModel for easier readability. Currently implementing a wrapper around reliable datagram for sending data packets larger than 64 bytes over a serial radio interface
2020-03-11 broke all props into seperate class within the model. This will allow config data queued for rovers on the network to be simply modelled by this class and standardizes valid config data ranges on bot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
2020-03-13 added external class for handling diagnostic data, useful for checking serialized diag data durign handshake if the accelerometer was tripped
2020-03-16 Add submodules for ArduinoJson and Adafruit_MMA8451
2020-03-17 switch back from submodules to using platformio libdeps
2020-03-28 switch to developer branch of platformio
2020-03-28 switch ldf mode to deep for compatibility
2020-03-30 stage 1 of fixing case sensitivity issues with the COM controller
2020-03-30 stage 2 of fixing case sensitivity issues with COM controller
2020-04-03 First pass at SatComm driver, need to fix compilation errors with type name
2020-04-04 Added stencils for PCB designs
    [BaseStencil v1.stl, RoverStencil v1.stl]
2020-04-05 broke config and pcb configuration files out, implemented simple backoff scheme, implemented channel detect functionality, CD is a deprecated RS232 signal which does not determine if the radio is sen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
2020-04-22 Switched CI Slave to Particle Debugger, removed board pack to speed up testing
2020-04-22 reformatted driver to work with new event system, need to finish writing driver actions
2020-04-24 Finished Controller/Driver pair, added integration tests for later
2020-05-08 Fix SatCommDriver tests, they are all passing
    [SatCommDriver.h]
2020-05-12 Fixed SatComm unnecessarily receiving
    [SatCommDriver.h]
2020-05-26 add SatCommDriver, IriduimSBD, and replace Console with PLOG integration
    [Diagnostics.cpp, SatCommDriver.h]
2020-05-27 integrate FeatherFault, fix misc. issues with other objects
    [feather_m0.cfg]
2020-05-27 switch to compile-time type inference, minor fixes
2020-06-02 removed manual testing routine in main, fixed build issues, removed unused classes GNSSdata, PropHandler, added backoff into main
    [Diagnostics.h, GNSSController.cpp, ManualTest.cpp]
2020-06-05 rover uses millis for wake time, base station can receive and dispatch props
2021-11-05 Add working relay code
2021-11-05 More code changes regarding relays/prepwork for request() function
2022-01-12 Copied Base code to allow for a new slate to rewrite
    [feather_m0.cfg]
2022-01-12 Fix mux settings for base
    [Base.cpp, Base.h, RadioManager.cpp]
2022-01-14 Fixed serializeJson error in RadioManager
    [Base.cpp, Base.h, RadioManager.cpp, RadioManager.h]
2022-01-21 Worked on adding a clean SDManger. This wil be used to replace FSController
    [Base.cpp, Base.h, RadioManager.cpp, SDManager.cpp, SDManager.h]
2022-01-25 Switched diagnostic data to use the Diagnostic class
2022-02-16 Added print statement.
2022-02-16 Modified the behavior of the radio test code.
    Fix issues with packets not sending and the feather port being unavailable.
    [Rover.cpp]
2022-02-23 Removed two lines from constructor to fix issues with code halting.
    [Rover.cpp]
2022-02-26 Rover::request() correctly serializes and transmits packets.
    [Rover.cpp, Rover.h]
2022-06-24 Add preliminary alarm testing prototype
2022-06-24 Add semi-function interrupt code
2022-06-30 reformatted time, corrected time, and integrated our code
    [Rover.cpp, Rover.h]
2022-07-20 Add led light after WFI
2022-08-14 SP fix with max, reduce .h files in main
    [MAX4820.cpp, MAX4820.h, Rover.cpp, Rover.h]
2022-08-14 Base sp fix for max
    [Base.cpp, Base.h]
2022-08-16 Ben fixed radio serializing issue, fix address issue
    [Base.cpp, RadioManager.cpp, Rover.cpp]
2022-08-25 Fix gps time and get rid of references to legacy SSModel
    [GNSSController.cpp, GNSSController.h, Rover.cpp]
2022-08-26 rewritten program flow
2022-08-26 rewritten flow states
2022-09-19 Fix gnss with Will
    [GNSSController.cpp, GNSSController.h, Rover.cpp, Rover.h]
2022-09-21 Fix rtc, add reliability to radio, STABLE WORKING
    [GNSSController.cpp, RadioManager.cpp, Rover.cpp]
2022-09-22 Added iridium and started writing SatComm driver
2022-12-11 Restructure using one platformio project with different environments to have single instances of code rather than different code for each device
    [feather_m0.cfg]
2022-12-19 Stabilized one project compiling
    [Base.cpp, Base.h, GNSSController.cpp, GNSSController.h, RadioManager.h, Rover.h, SDManager.h, SatComm.cpp]
2023-01-31 rover will stop collecting data when it has a fix, base will wake up 1 second before the rover
    [Rover.cpp, main-base.cpp, main-rover.cpp]
2023-02-03 Fixed not detecting a fix
    [Base.cpp, GNSSController.cpp, Rover.cpp, main-base.cpp]
2023-02-07 add resetGNSSStructs back, rover will now initialize with the proper address, satcomm minify now uses substring instead of loops
    [GNSSController.cpp, RadioManager.cpp, Rover.cpp, SatComm.cpp, main-base.cpp, main-rover.cpp]
2023-02-14 Current seemingly stable version
2023-02-14 Shorten poll time cause fixes appear to be gotten faster, power off GNSS after getting a fix
    [Rover.cpp, main-base.cpp, main-rover.cpp]
2023-02-16 Reverted splitting up of log cycles
    [SDManager.cpp]
2023-03-07 Changed rover to continue populating new fixes
    [Rover.cpp, main-rover.cpp]
2023-07-08 Add relay test case
