OPEnSLab-OSU/SlideSentinel/(notices)

Notices in the files:
NRF UART/NRF_tx/NRF_tx/NRF_tx.ino:
Copyright (C) 2012 James Coliz, Jr. <maniacbug@ymail.com>
modify it under the terms of the GNU General Public License
parts and their libraries:
SparkFun-Connectors: Licensing: Creative Commons ShareAlike 4.0 International - https://creativecommons.org/licenses/by-sa/4.0
microbuilder: This work is placed in the public domain, and may be freely used for commercial and non-commercial work with the following conditions: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
